arctic-trail/karhunkierros-sar-drone/docs/DESIGN_EVOLUTION_AND_STABILIZATION_LOG.md

# Master Design Evolution, Trade-Off Audit, and Architecture Stabilization Log

> **CONCEPT-STAGE STATUS DISCLAIMER (FIRST PUBLIC RELEASE):**
> This log documents the **open-source engineering concept, COTS hardware bill-of-materials (`€1,189–€1,329`), and software-simulated reference architecture** (`29/29` unit tests passing in `collector_hub/drone_observer.py`). While the shared ground trail-camera and collector stack ([`arctic-trail/arctic-trail-cam`](https://github.com/arctic-trail/arctic-trail-cam)) is bench-verified, **the physical SAR drone airframe, `-25 °C` winter flight endurance, payload drop, and `+10 °C` roofed station are currently at the concept and simulation stage** and require Phase 1–3 field flight validation and `Traficom` / `EASA SORA` regulatory authorization.

**Document Status:** Authoritative Master Engineering Log (`v2.0-FinLab-And-SupplyChain-Hardened`)  
**Repository Scope:** `karhunkierros-sar-drone` (100% Shared Ground Camera & Collector Stack with [`arctic-trail/arctic-trail-cam`](https://github.com/arctic-trail/arctic-trail-cam) + Modular `drone_observer.py` SAR Extension)  
**Purpose:** Permanently records every design iteration (Iterations 1–20), independent audit remediations (`F01`–`F53`), open-source ecosystem trade-offs, rejected architectural alternatives (including why we reject custom PCBs and heavy cloud/4G dependencies), and the **Reference COTS Hardware Baseline** so future development never goes in circles.

---

## 1. Executive Verdict: Has the Design Stabilized?

**Yes — at Iteration 20 (`v2.1-FinLab-USpace-Surge-And-SupplyChain-Hardened`), every finding from Round-1, Round-2, and Round-3 independent Flight Physics, ArduPilot Firmware, Hardware Bench Integration, Cybersecurity, Full-Stack & OPSEC Reviews plus Human-in-the-Loop Manual Manoeuvring, Two-Way Rescuer-to-Hiker Voice Relay, the `FIN-LAB` (`FIN-LAB-01..05`) reference benchmarks, and Allied Supply-Chain Provenance (`F01`–`F53`) has been resolved, and the complete architecture is verified end-to-end across all 29 automated `unittest` test suites.**

```
[========================================] 100% Software, Human Pilot Override, 2-Way Voice, FIN-LAB-01..05 & Audit Remediation (All 29 Test Suites Passing)
[========================================] 100% Shared Ground Camera & Collector Hub Stack with arctic-trail-cam (Zero Duplicate Products)
[========================================] 100% Snap-In Reference COTS Hardware Baseline (Zero Custom PCBs, <= €5,000 Rule Verified Across All 4 Allied Tiers)
[========                                ]  20% Physical Airframe Assembly & Live Field Flight Tuning
```

---

## 2. Complete Chronological Iteration History (Iterations 1–20)
*Why we changed what we changed — and what we must never revert to:*

| Iteration | Initial Idea / State | Problem / Limitation Discovered | Engineered Solution Adopted | Status |
| :--- | :--- | :--- | :--- | :---: |
| **Iter 1: Single-Camera Standoff Observer** | Drone launches on trail-camera trigger and orbits at `105 m AGL / 135 m` radius (`171 m` slant range) outside shotgun range (`55 m`). | Could only observe from high altitude; could not communicate with or warm a hypothermic person. | Added `compute_close_approach_state()` (`8–10 m` altitude, directional speaker + high-contrast message sign). | ✅ Locked |
| **Iter 2: "Bearnese Mountain Dog" Companion & Barrel** | Added miniature oak barrel with brass faucet ("Koskenkorva" joke) lowered to `2 m` above the person's head. | **Two severe flaws:** (1) Hovering `2 m` over a person's head with a cable is a physical entanglement/rotor hazard; (2) Alcohol (*Koskenkorva*) causes peripheral vasodilation and accelerates fatal hypothermia! | **Never revert to overhead drops or alcohol in public SAR:** Hard-coded a **`15 m` minimum horizontal human standoff bubble**, clear-snow offset drop (`10–15 m` away), **`25 N` electromagnetic/servo breakaway release**, `50 m` climb before audio prompt, and replaced payload with **`+42 °C` warm berry glucose-electrolyte drink**, hand warmers, and thermal blanket (keeping the *Koskenkorva* preset strictly as an internal pitch easter egg). | ✅ Locked |
| **Iter 3: Multi-Object & Multi-Drone Swarm** | Single drone could only track 1 person from 1 camera. | Tourist groups or families often split up (`> 250–450 m` apart) when lost in the dark. | Built `MultiCameraMultiObjectTracker`, `MultiDroneSwarmCoordinator` (up to 6 drones), and `plan_multi_drone_grid_search()` (boustrophedon parallel search lanes). | ✅ Locked |
| **Iter 4: Onboard Target-Lock & Self-Guidance** | Drone relied on ground trail-camera updates to know where the hiker was walking. | Once a hiker walks `50 m` past a trail camera, the ground camera can no longer see them. | Built `OnboardTargetLockSelfGuider`: once the drone's own thermal (`LWIR`) + optical (`YOLOv8n`) gimbal camera spots the person, it locks on and self-guides autonomously through tree canopy gaps (`CanopyKalmanTracker`). | ✅ Locked |
| **Iter 5: Privacy-by-Design ("Digitaalinen Autiotupa")** | Continuous trail camera tracking felt like "stalking random hikers in the woods." | Public and Data Protection Ombudsman (*Tietosuojavaltuutettu*) would reject continuous surveillance of hikers. | Created `PassiveTrailSightingLedger` (**48-hour auto-purging local ring buffer**, zero facial recognition, `0.00 W` RF) + `verify_humanitarian_sar_trigger()` (**"Pull, Don't Push"**: unlocks ONLY on `112 Suomi`, `Garmin inReach`, physical Trail-Post SOS button, or official `Poliisi`/`Rajavartiolaitos`/`Pelastuslaitos` SAR order). Also replaced defensive *"rauhanomainen"* wording with confident *"Suunnittelu, josta tietosuojavaltuutettukin tykkää"*. | ✅ Locked |
| **Iter 6: Finnish Legal, Wildlife & Arctic Context** | Generic coordinates and generic battery model. | Failed to account for *Poronhoitolaki* (`848/1990 § 42`), `-25 °C` *Kaamos* battery sag, or Finnish helicopter SAR coordinate formats. | Added `classify_finnish_boreal_thermal_signature()` (distinguishes humans from *poro* & *hirvi*; enforces `>= 100 m` silent ceiling over reindeer), `-25 °C` endurance model (`45%` dynamic handover reserve), and dual `ETRS-TM35FIN` + `WGS84 DDM` (`DD° MM.MMM'`) aviation SAR coordinates. | ✅ Locked |
| **Iter 7: Roadless Wilderness *Autiotupa* Survival Bridge** | Assumed the drone just orbits waiting for a police car. | In Karhunkierros / Lapland (`8–25 km` from the nearest plowed road), **a police car cannot reach the forest**, and snowmobile patrols take `90–180 min` — whereas hypothermia starts in `30–45 min`! Meanwhile, state `Metsähallitus` wilderness huts (*autiotuvat* with wood stoves) are only `0.5–2.5 km` away. | Built `compute_aerial_lantern_trail_guide_state()` (*Opaslyhty: "Seuraa minua autiotuvalle"*) + `evaluate_roadless_wilderness_autiotupa_rescue_bridge()`: guides hikers at walking pace with an `800 lm` spotlight to a warm *Autiotupa* in **`10–25 min`** (`> 110 min` faster than ground patrols). | ✅ Locked |
| **Iter 8: 100% Repository Separation** | Developed alongside the `arctic-trail-cam` ground sensor stack. | Keeping aerial SAR flight logic inside the ground trail-camera repository coupled release cycles across two distinct hardware builds. | Extracted into a **100% standalone Git repository** (`karhunkierros-sar-drone`) with clean modular versioning while sharing the common ground-camera and collector protocol. | ✅ Locked |
| **Iter 9: GNSS Jamming/Spoofing, RF Blackout & Icing Resilience** | Relied on standard GPS (`u-blox M10`), continuous RF telemetry, and `10 m AGL` below-canopy flight. | Eastern/Northern Finland experiences frequent **GPS jamming/spoofing** and RF interference; `10 m AGL` risks hitting spruce branches in wind; `-2 °C` freezing drizzle ices propellers. | Added `evaluate_gnss_rf_jamming_and_weather_resilience()`: (1) `PMW3901` Optical Flow + `Benewake TF02-Pro` (`40 m` IP65 LiDAR) cross-check fences off spoofed GPS (`no flyaway`) + `940 nm` trail-post fiducials; (2) `940 nm` One-Way Optical Diode pad handoff + 100% radio-silent autonomous rescue; (3) hydrophobic blade coating + centrifugal RPM ice-shedding burst; (4) `28 m AGL` above-canopy *Opaslyhty* mode with `10°` collimated spotlight. | ✅ Locked |
| **Iter 10: Immobilized Hiker 18h Beacon & Zero-Infrastructure Mobile Tailgate Mode** | Assumed (1) a pre-built fixed national-park drone pad, and (2) that every hiker can walk to the *Autiotupa*. | (1) Field testing and `Vapepa` volunteers need a portable car-trunk / snowmobile-*ahkio* launch mode with zero fixed park infrastructure; (2) an injured hiker with a broken ankle cannot walk to the *Autiotupa*. | Upgraded `compute_aerial_lantern_trail_guide_state()`: (1) supports `custom_shelter_target` for **Mobile Tailgate / Snowmobile *Ahkio* Launch & Return**; (2) if `stationary_duration_s >= 180 s`, escalates to `IMMOBILIZED_SHELTER_IN_PLACE_SKY_LIGHTHOUSE_HOLD` (`45 m AGL`) and, at `<= 25%` battery, lands on the `15 m` clearing in **`GROUNDED_CLEARING_18HR_LOW_POWER_STROBE_BEACON` (`18+ hours` strobe + beacon)** so an injured hiker is never abandoned. | ✅ Locked |
| **Iter 11 (`v1.1-Audit-Hardened`): Independent Audit Remediation (`F01`–`F22`) & Snap-In COTS Baseline** | Audit identified 22 findings across coordinates (`F01`), fail-closed verification (`F02`), `public_release_sar_cask` `50 m`/`15 m` overrides (`F03`), 65-byte MAVLink v2 frame packing (`F04`), `TF02-Pro` vs `TFmini-S` range (`F05`), `4S` vs `6S` X500 V2 voltage (`F06`), `OPERATIONAL` camera survey (`F07`), grid-search exhaustion (`F08`), relief battery check (`F09`), iterative airspace repulsion (`F10`), `SPD=0` preservation (`F11`), XSS/JSONL/UDP hardening (`F13`–`F18`), and shared `arctic-trail-cam` files (`F15`, `F19`–`F21`). | Maintaining two separate camera codebases or designing custom PCBs would slow down field testing and create hardware/software divergence bugs. | Implemented all audit fixes (`F01`–`F22`), standardized on **`8,000 mAh 4S2P (14.8 V, 118.4 Wh) Ultra-Low-Temp Silicon-Anode Li-Ion`** + **`Benewake TF02-Pro (40 m IP65)`** + **`MicoAir MTF-02P / Matek 3901-L0X`**, and scrubbed 100% of binary EXIF/XMP/C2PA/PDF metadata (`tests/test_enhanced_resilience.py`). | ✅ Locked |
| **Iter 12: Open-Source Field Drone Ecosystem Evaluation (`ArduPilot`, `ELRS`, `QuadroFleet`, `Delta`, `Eusocial Drones`)** | Evaluated whether to adopt external open-source frameworks (`ArduPilot`, `Betaflight`, `ExpressLRS`, `OpenIPC`, `QuadroFleet-Masina`, `Delta`, `Eusocial Drones`) vs. keeping our system lean and keeping the Reference COTS Hardware Baseline unchanged. | Adopting heavy 4G/VPN daemons (`QuadroFleet-Masina`) as a hard requirement fails in 0-bar Oulanka canyons; `Betaflight` lacks autonomous loiter/EKF3 optical-flow navigation; heavyweight cloud platforms (`Delta`) add unnecessary attack surface. However, missing native `ArduCopter EKF3` source-set switching or open-standard `CoT` packets would leave low-hanging fruit on the table. | **Adopted 4 zero-bloat, zero-hardware-change wins (`F26`):** (1) `generate_arducopter_pixhawk6c_param_profile()` configures `ArduCopter 4.5+` native `EKF3` dual source sets (`EK3_SRC1` = M10 GNSS, `EK3_SRC2` = Optical Flow + `TF02-Pro` LiDAR, switched instantaneously via `RC9_OPTION = 90` on GPS spoofing); (2) `ExpressLRS` (`ELRS`) 2.4 GHz FHSS on `RadioMaster Pocket` + `RP3 V2 Diversity` for jam-resistant override + `ELRS Airport` backup telemetry; (3) `export_open_sar_situational_awareness_packet()` exports `Delta`-style open-standard `ETRS-TM35FIN` JSON + `Cursor-on-Target (CoT)` XML + 4-tier telemetry failover (`940nm Diode` -> `868/900MHz LoRa` -> `ELRS` -> `Opportunistic 105m AGL LTE`); (4) `Eusocial Drones` "inverted iceberg" OPSEC boundary (`MIT` + safety/liability disclaimer, zero PII/metadata). | ✅ Locked |
| **Iter 13 (`v1.3-Marketplace-Hardened`): "Uber-for-SAR" Open-Alert Dispatch Marketplace, Automated Roofed Shelters, Multi-Unit Auto-Prioritization, Human Control Panel & 28 m Elastic Pull-Guidance (`F23`–`F26`)** | Previously, dispatch assumed a single pre-selected launch pad or manual CLI invocation. In real regional SAR, multiple mobile units (`Poliisi` drone vans, `Rajavartiolaitos` patrols, `Vapepa` units) and automated roofed wilderness stations (`+10 °C` weatherproof roofed nests) coexist and need a coordinated way to see, accept, and prioritize open alerts — with full human oversight. | Needed: (1) an "Uber-driver-style" open-alert acceptance flow for mobile vans + `AUTO_ACCEPT_GEOFENCE` mode for roofed stations; (2) safety interlocks so a roofed station with a jammed hatch, `> 25 kg` snow load, or failed heater never auto-launches (`F23`); (3) automatic `#2 Backup` promotion if `#1 Primary` aborts (`F24`); (4) closed-loop `28 m AGL` "Follow & Elastic Pull" escort verification (`F25`); and (5) a live Human Coordinator Control Panel. | Built `SARDispatchMarketplaceCoordinator`, `compute_elastic_pull_guidance_vector()`, `simulate_elastic_pull_escort_to_autiotupa()`, `/api/drone?action=dispatch-marketplace`, CLI `--mode dispatch-marketplace`, and the interactive **Uber-for-SAR Open-Alert Dispatch & Roofed Nests Control Panel** in `collector_hub/ui/index.html`, verified by `test_21` and `test_22`. | ✅ Locked |
| **Iter 14 (`v1.4-System-Assessment-Hardened`): End-to-End Physics, Safety-Geofence & Fail-Closed Marketplace Hardening (`F27`–`F31`)** | Deep assessment of the newly added `compute_elastic_pull_guidance_vector()` and `SARDispatchMarketplaceCoordinator` against Safeguards 1–6 (`15 m` human standoff, immobilized hiker 18h beacon, *Poronhoitolaki* `100 m` wildlife ceiling, "Pull, Don't Push" privacy gate, and physical roofed-hatch hardware protection). | Found 5 subtle cross-feature gaps: (`F27`) `compute_elastic_pull_guidance_vector()` achieved `6 m` / `10 m` spotlight lead by moving the `2.1 kg` airframe itself within `6 m` / `10 m` horizontally of the hiker (and `0 m` on arrival), violating `MIN_HUMAN_HORIZONTAL_STANDOFF_M = 15.0 m`; (`F28`) elastic pull lacked the immobilized hiker (`stationary_duration_s >= 180 s` -> `45 m` Sky-Lighthouse / `18h` grounded beacon) and *Poronhoitolaki* `100 m` reindeer hold; (`F29`) `broadcast_open_alert()` did not call `verify_humanitarian_sar_trigger()`; (`F30`) `human_coordinator_intervene("FORCE_ASSIGN_UNIT")` could attempt to launch a roofed nest into a jammed/snow-buried hatch; (`F31`) UI panel lacked one-click buttons for `Approve Launch`, `Abort #1 & Promote #2`, and `Toggle Nest #1 Auto`. | Resolved all 5 gaps (`F27`–`F31`): (`F27`) airframe always maintains `airframe_horiz_separation_m >= 15.0 m` via `enforce_hardcoded_human_safety_geofence()`, using `spotlight_gimbal_pitch_deg` to place the illuminated snow pool `6 m` / `10 m` / `15 m` ahead; (`F28`) unified immobilized hiker & *Poronhoitolaki* `100 m` escalation into `compute_elastic_pull_guidance_vector()`; (`F29`) fail-closed `verify_humanitarian_sar_trigger()` gate in `broadcast_open_alert()`; (`F30`) physical roofed-shelter interlock enforced even on manual coordinator override (`BLOCKED_UNSAFE_SHELTER_LAUNCH`); (`F31`) added all coordinator buttons in `collector_hub/ui/index.html`. | ✅ Locked |
| **Iter 15 (`v1.5-Audit-Hardened`): Round-1 Engineering Audit across Flight Physics, ArduPilot Firmware, Cybersecurity & OPSEC (`F32`–`F38`)** | Conducted two independent adversarial engineering reviews (Flight Physics & ArduPilot Firmware Review + Cybersecurity, Full-Stack & OPSEC Review) across the entire codebase, hardware parameter profile, and documentation. | Identified 7 high-value refinements (`F32`–`F38`): (`F32`) `evaluate_finnish_winter_flight_endurance()` previously used `133.2 Wh` (`9,000 mAh`) instead of `118.4 Wh` (`8,000 mAh 4S2P`) and passed `ambient_temp_c = +10 °C` when pre-warmed in a roofed nest, inadvertently disabling the `6 W` `+42 °C` cask heater and lowering the winter return reserve from `40–45%` to `30%`; (`F33`) `auto_prioritize_and_award_task()` had a dangerous fallback (`if not feasible_bids: feasible_bids = list(accepted_bids)`) that would launch a jammed/unfeasible unit if only unfeasible bids were present, and `human_coordinator_intervene()` checked cached bid dicts rather than live `self.fleet_units` state on post-acceptance hatch faults or backup failover; (`F34`) `generate_arducopter_pixhawk6c_param_profile()` needed `PM02 V3` calibration (`BATT_MONITOR=4`), `SERIAL5_PROTOCOL=2` / `FLOW_TYPE=5` (`MicoAir MTF-02P`), `SERIAL6_PROTOCOL=23` (`ELRS CRSF`), and `SERVO9_FUNCTION=28` (`GRIP_ENABLE=1` servo airdrop); (`F35`) during *Autiotupa* arrival (`dist <= 20 m`), pushing the drone `15 m` along `(ux_goal, uy_goal)` overshot directly over the cabin roof/chimney, and lateral pull (`6 m` beam vs `15 m` airframe) needed `spotlight_gimbal_yaw_rel_deg = 180.0` (aft); (`F36`) `export_open_sar_situational_awareness_packet()` needed `xml.sax.saxutils.escape` on `cot_xml` and unified `OULANKA_REF_LAT_DEG` (`66.2605° N`) CRS projection with `local_enu_to_etrs_tm35fin()`; (`F37`) `simulate_sar_dispatch_marketplace_lifecycle()` needed to re-run `simulate_multi_accept` after `hold_or_abort_launch`, merge default unit keys on JSON load, and allow exiting Marketplace to Standoff; (`F38`) scrubbed US-specific procurement strings (`Upgrade Energy`, `915MHz`, `"Ordered ..."`) from tracked files and fixed duplicate `test_17` method naming (`26` unittest suites). | Implemented all 7 Round-1 engineering audit remediations (`F32`–`F38`) and verified with `test_23_multi_model_audit_physics_security_and_opsec_regressions` (`26/26` `unittest` test suites passing). | ✅ Locked |
| **Iter 16 (`v1.6-Round2-Audit-Hardened`): Round-2 Adversarial Audit across Aerospace Kinematics, MAVLink Bitmasks, Hardware Bench Bring-Up & Atomic Persistence (`F39`–`F44`)** | Conducted a second independent adversarial engineering review probing arrival gimbal geometry, MAVLink v2 bitmasks, sub-zero fleet handover reserves, Wave 1/2/3 bench diagnostics, atomic JSON persistence, and binary PDF consistency. | Discovered 6 concrete engineering refinements (`F39`–`F44`): (`F39`) in `compute_elastic_pull_guidance_vector()`, `ARRIVED_AT_AUTIOTUPA_SAFE_HAVEN` had `effective_lead_m = 0.0`, which triggered `beam_offset_from_drone_m > 0` and set `spotlight_gimbal_yaw_rel_deg = 180.0°` (pointing the spotlight aft into the forest instead of at the cabin door!), and `compute_aerial_lantern_trail_guide_state()` (*Opaslyhty*) lacked the lateral `15 m` clearing offset on arrival (`dist_to_hut_m <= 20 m`), overflying the cabin roof when `dist_to_hut_m == 15 m`; (`F40`) `build_mavlink_guidance_frame()` used `type_mask = 0x0DF8`, which set `VX_IGNORE (8)`, `VY_IGNORE (16)`, `VZ_IGNORE (32)`, and `YAW_IGNORE (1024)` to `1` (ignored by ArduPilot!); (`F41`) `FleetCoordinator` hardcoded `30%` RTH reserve instead of scaling to `40%`/`45%` in sub-zero weather, `evaluate_unit_bid_metrics()` used `15%` post-return margin at `-22 °C`, `human_coordinator_intervene()` set `ROOF_CLOSED_WEATHER_SEALED` immediately while an aborted roofed drone was still airborne returning to dock, and `SubjectKalmanTracker.step()` lacked a velocity spike clamp; (`F42`) needed a dedicated Wave 1/2/3 SAR Drone hardware bench diagnostic and `.param` exporter (`run_sar_drone_companion_bench_check()`, `--mode bench-check --export-params`, and `run_guided_bench_doctor.py --drone-bench`); (`F43`) needed atomic JSON file writes (`_atomic_write_json` via temp + `fsync` + `os.replace`), mode persistence across `grid-search` and `sar-tourist-group`, 3D UI altitude sync (`28 m` / `50 m` / `8 m`), `403` directory-listing block, and `300 s` freshness filtering in `subghz_nlos_relay.py`; (`F44`) `docs/KARHUNKIERROS_PRO_BONO_SAR_BRIEF_FI.pdf` needed regeneration + metadata scrubbing so its binary text matches the `8,000 mAh 4S2P (118.4 Wh)` and `v1.6` documentation. | Implemented all 6 Round-2 engineering audit fixes (`F39`–`F44`), regenerated and metadata-scrubbed `docs/KARHUNKIERROS_PRO_BONO_SAR_BRIEF_FI.pdf`, and verified with `test_24_round2_multi_model_aerospace_and_bench_audit_regressions` (`27/27` `unittest` test suites passing). | ✅ Locked |
| **Iter 17 (`v1.7-Human-Pilot-And-Two-Way-Voice-Hardened`): Post-Detection Human Pilot Manual Manoeuvring & Two-Way Rescuer-to-Hiker Voice Intercom Relay (`F45`–`F47`)** | Automation is ideal for transit and parallel grid search, but once the lost person is found in the dark boreal forest, **we cannot trust pure automation to handle close-in obstacle nuances alone, nor will a frightened hiker blindly follow a silent, robotic drone** (they are more likely to fear or run away from it unless a real human rescuer speaks to them and listens to their reply). | Needed: (`F45`) Post-detection `HOLD_FOR_HUMAN_PILOT_AND_VOICE_CONTACT` (`35 m AGL`, `25 m` horizontal standoff) + pre-configured `ArduCopter 4.5+` manual stick override modes (`FLTMODE1 = 5 LOITER`, `FLTMODE4 = 4 GUIDED`, `FLTMODE6 = 6 RTL`) for `RadioMaster Pocket ELRS`; (`F46`) `HumanPilotAndTwoWayVoiceRelayController` allowing remote 6-DOF operator nudges (`N/S/E/W`, `Alt`, `Yaw`, `Gimbal`, `Deadman Hover Brake`, `Manual Cask Release`) via 65-byte `MAVLink v2 SET_POSITION_TARGET_LOCAL_NED` frames while **still enforcing `enforce_hardcoded_human_safety_geofence()`** (`>= 15.0 m` horizontal standoff, `>= 6.0 m` LiDAR floor); (`F47`) **Live Two-Way Voice Intercom Relay (`Rescuer <-> Hiker`)** solving the `82 dBA` propeller noise physics problem via 3 selectable uplink modes: (1) `AIRBORNE_PROP_NOTCHED_MIC_AND_VISUAL_GESTURE`, (2) `GROUNDED_15M_CLEARING_QUIET_SPEAKERPHONE`, and (3) `CASK_DROPPED_COLLAR_PTT_MIC`. | Built `HumanPilotAndTwoWayVoiceRelayController`, `execute_human_pilot_and_voice_relay_action()`, CLI `--mode human-pilot`, `/api/drone?action=human-pilot`, the interactive **Human Pilot & 2-Way Voice Intercom** panel in `collector_hub/ui/index.html`, and `test_25` (`28/28` `unittest` test suites passing). | ✅ Locked |
| **Iter 18–20 (`v2.1-FinLab-USpace-Surge-And-SupplyChain-Hardened`): 3-Pass Implementation & Red-Team Hardening of `FIN-LAB-01 / 02 / 03 / 04 / 05` & Allied Supply-Chain Provenance (`F48`–`F53`)** | Evaluated our SAR Drone and Arctic Trail Cam against the `FIN-LAB` Nordic harsh-environment & autonomous systems working group charters (`FIN-LAB-01` through `FIN-LAB-05`) and supply-chain resilience benchmarks (`NdFeB` sintered magnets, `-40 °C` battery cells, uncooled `LWIR` thermal cores, and the `<= €5,000` BOM rule) across 3 full adversarial engineering iterations. | Identified and closed 5 high-leverage capabilities + 6 adversarial red-team physics/geometry refinements (`F48`–`F53`): (1) **`FIN-LAB-03` High-Altitude (`> 40 m` to `120 m AGL`) GNSS-Denied Navigation (`F51`)** solving the `40 m` `Benewake TF02-Pro` LiDAR range ceiling during `105 m AGL` transit via Cold-Air Hypsometric Baro-DEM Scaling ($\Delta h_{\text{true}} = \Delta h_{\text{ISA}} \cdot (\bar{T}_K / 288.15)$, preventing the `4,347 m` `-25 °C` barometric drift trap) + Dual-Band `IMX462 Starvis` / `TOPDON TC001 LWIR` Homography Odometry + NUC shutter freeze watchdog + compound-blinding emergency descent to the `<= 40 m` LiDAR floor + surveyed *Autiotupa*/River/`940 nm` Trail-Post EKF resets (`20.76 m <= 30.0 m` 30-min drift pass mark); (2) **`FIN-LAB-05` `10 Hz` Cold-Weather & Flight Black-Box Telemetry Logger (`F52`)** (`IEC 60068-2-1` Cold & `RTCA DO-160G Section 24` Icing) with dynamic $\bar{R}_{\text{internal}}$ EMA, predictive `35 A` climb voltage-sag guard (`< 12.2 V` clamps climb rate to `1.5 m/s`), $\Omega^2$-scaled aerodynamic icing torque anomaly (`> 12%` triggers `8,500 RPM` centrifugal shedding without false-positive alarms on clean high-RPM climbs), and automatic `CLASS_A_MINUS_30C_QUALIFIED` grading; (3) **`FIN-LAB-01` Open Ingest API (`v0.9`) Civilian Twin Adapters, C2 Ingest Bridge & O1–O5 Scorecard (`F49`, `F50`, `F53`)** (`AutiotupaCabinOccupancyAndOverdueAdapter` with solar chimney false-alarm guard, `AcousticDistressAndMotorBearingAdapter` with Cramer's Rule `t1, t2 > 0` & `sin_opening >= sin(15°)` GDOP gate + wind howling suppression, `ReindeerPaliskuntaCollarTelemetryAdapter`, `TrailCameraMmWaveOpticalDiodeAdapter`, `ingest_finlab01_observation_into_sar_c2()`, and duration-weighted `compute_finlab01_conformance_scorecard()`); (4) **`FIN-LAB-04` Seeded Monte Carlo SAR Fleet & Battery Sizing Digital Twin (`F48`)** (`1,000` runs in `~7 ms` enforcing the `18.0 km` winter SAR operating radius and roadless Oulanka canyon ski approach so `CONFIG_MINIMAL_2_NESTS_1_PACK` fails at `59.6%` Golden-Hour while **`CONFIG_BALANCED_4_NESTS_3_PACKS`** (`€185k`, `100%` Golden-Hour, `P95 = 15.5 min`) is selected as Pareto-optimal); (5) **FIN-LAB Allied Component Provenance, Pin-to-Pin `JST-GH` Harness Schedule (`TELEM2` Pin 1 `+5V` isolated) & 5-Stage `2.5h` Rapid Build Checklist (`F53`)** (`€1,329` COTS incl. `+€45` `[D19]`/`[D20]` high-field EMI ferrite & UHF/DECT mic kit / `€1,770` Allied Tier-1 / `€2,126.40` `+60%` Allied Contingency / `€2,965` Sovereign European `Lynred ATTO320 / Senop` LWIR — all well under `<= €5,000`). | Built `compute_finlab03_gnss_denied_high_altitude_navigation()`, `ColdWeatherBlackBoxLogger`, `AutiotupaCabinOccupancyAndOverdueAdapter`, `AcousticDistressAndMotorBearingAdapter`, `ReindeerPaliskuntaCollarTelemetryAdapter`, `TrailCameraMmWaveOpticalDiodeAdapter`, `ingest_finlab01_observation_into_sar_c2()`, `compute_finlab01_conformance_scorecard()`, `simulate_sar_fleet_monte_carlo_sizing()`, `audit_supply_chain_and_cots_buildability()`, `run_complete_finlab_and_supply_chain_verification_suite()`, CLI `--mode finlab-suite`, `/api/drone?action=finlab-suite`, the **FIN-LAB & Supply-Chain Suite** UI inspector panel, and `test_26` (`29/29` `unittest` test suites passing). | ✅ **v2.0 FinLab-And-SupplyChain-Hardened** |

---

## 3. Learnings from the Open-Source Field Drone Ecosystem (Zero Hardware Changes)

| Project / Layer | What It Is | Our Architectural Decision (No Overkill, Zero Hardware Change) |
| :--- | :--- | :--- |
| **`ArduPilot` (`ArduCopter 4.5+`, GPL-3.0)** | Full autonomous flight stack for `Pixhawk 6C` (`STM32H7`). | **ADOPTED (`generate_arducopter_pixhawk6c_param_profile()`):** Runs natively on `Holybro Pixhawk 6C` + `PM02 V3`. We use its built-in **`EKF3` Dual Source-Set Switching** (`EK3_SRC1_*` = M10 GNSS; `EK3_SRC2_*` = `MicoAir MTF-02P / Matek 3901-L0X` Optical Flow + `Benewake TF02-Pro` LiDAR via `RC9_OPTION = 90`) and native `SERVO9_FUNCTION = 28` (`GRIP_ENABLE = 1`) servo airdrop so our Pi 5 can switch out of spoofed GPS in `< 50 ms` without custom flight-control C++ code. |
| **`Betaflight` (GPL-3.0)** | Acrobatic FPV flight controller firmware. | **REJECTED:** Designed for manual FPV racing/freestyle; lacks autonomous loiter, waypoint navigation, belly servo payload release, and `EKF3` optical-flow/LiDAR position hold. |
| **`ExpressLRS` (`ELRS`)** | Open-source FHSS RC link (`2.4 GHz`). | **ADOPTED:** Supported natively via **`RadioMaster Pocket ELRS` + `RP3 V2 Diversity Receiver` (`SERIAL6_PROTOCOL = 23`)**. Provides frequency-hopping safety-pilot override and can carry low-rate MAVLink telemetry (`ELRS Airport`) as Link Tier 3. |
| **`QuadroFleet-Masina` (4G/5G VPN)** | Open-source 4G/5G LTE video/telemetry + VPN tunnel. | **SKIP FULL STACK / ADOPT CONCEPT AS TIER-4 BURST:** Deep Karhunkierros canyons have `0 bars` of cellular reception, and running WebRTC/VPN daemons on the critical flight path adds unnecessary failure modes. Instead, our **Link Tier 4** uses a zero-dependency opportunistic high-altitude (`105 m AGL` above canopy) compressed keyframe burst only when hilltop LTE is detected, while **Link Tier 1 (`940 nm` Optical Diode)** and **Link Tier 2 (`868/900 MHz LoRa`)** remain primary. |
| **`Delta` (Open Architecture vs. Open Source)** | Multi-agency situational awareness architecture built on open data standards (`CoT`). | **ADOPTED OPEN-STANDARD PACKET (`export_open_sar_situational_awareness_packet()`):** Instead of building a heavyweight cloud, every alert and drone state exports a lightweight, XML-escaped, zero-dependency **`ETRS-TM35FIN` JSON + `Cursor-on-Target (CoT)` XML** packet (`< 1 m` CRS agreement) so `Poliisi`, `Rajavartiolaitos`, `Vapepa`, or `QGroundControl / ATAK` tablets can view and accept alerts immediately. |
| **`Eusocial Drones` ("Inverted Iceberg" Model)** | Open-source community portal that keeps sensitive operational tooling private. | **ADOPTED:** Validates our exact repository architecture: public-ready humanitarian SAR codebase (`MIT` + safety/liability disclaimer, zero PII/metadata, zero vendor-order correlation) with strict operational security hygiene. |

---

## 4. "Uber-for-SAR" Open-Alert Marketplace, Roofed Auto-Stations & 28 m Elastic Pull-Guidance (`F23`–`F38`)

1. **Open-Alert Broadcast to Mobile Units & Roofed Auto-Stations (`broadcast_open_alert()`, `F29`):**
   - Enforces `verify_humanitarian_sar_trigger()` ("Pull, Don't Push" privacy gate, `F29`): fails closed (`REJECTED_NO_HUMANITARIAN_SAR_TRIGGER`) unless triggered by an authorized `112 Suomi`, `Garmin inReach`, Trail-Post SOS button, overdue *autiotupa* check-in, or official `Poliisi` / `Rajavartiolaitos` / `Pelastuslaitos` SAR order.
   - When authorized, broadcasts an open task (`OPEN_FOR_UNIT_ACCEPTANCE`) to all registered **Mobile Patrol Units** (`POLIISI-VAN-OULU-21`, `RAJA-PARTIO-KUUSAMO-04`, `VAPEPA-AHKIO-RUKA-07`) and **Automated Roofed Wilderness Stations** (`NEST-OULANKA-ROOF-01`, `NEST-VALTAVAARA-ROOF-02`).
2. **Weatherproof Roofed Stations (`+10 °C`) with Auto-Accept & Live Hardware Safety Interlocks (`F23`, `F30`, `F33`):**
   - Automated stations sit under a motorized weatherproof roof (`+10 °C` heated enclosure keeping snow, freezing rain, and rime ice off the airframe and keeping the `8,000 mAh` Li-Ion pack at `100%` warm capacity, while `evaluate_finnish_winter_flight_endurance()` decouples `cell_temp_c` from `ambient_temp_c` so the `+42 °C` cask heater and `40–45%` winter return reserve remain active in `-22 °C` air, `F32`).
   - When set to `AUTO_ACCEPT_GEOFENCE`, the station automatically accepts tasks within its `14 km` geofence **only if** its `F23` safety interlock passes (`roof_hatch_operational == True`, `roof_snow_load_kg <= 25.0 kg`, `internal_temp_c >= -15.0 °C`, and `auto_accept_mode != "MAINTENANCE_OFFLINE"`).
   - Live bid refresh (`_refresh_active_task_bids()`, `F33`) re-evaluates `self.fleet_units` before every prioritization, manual assignment, or backup promotion. If all accepting units are unfeasible or have jammed hatches, `auto_prioritize_and_award_task()` fails closed (`BLOCKED_NO_FEASIBLE_OR_SAFE_UNITS`) and never launches an unsafe unit.
3. **Multi-Unit Auto-Prioritization & Automatic `#2 Backup` Failover (`F24`, `F33`):**
   - When multiple units accept the same alert, `auto_prioritize_and_award_task()` scores every feasible bid (`0–100 pts`): **Flight ETA (`45%`)**, **Winter Battery Endurance Margin (`25%`)**, **Thermal/Cask/GNSS-Denied Capability (`15%`)**, and **Shelter/Optical-Diode Readiness (`15%`)**.
   - Ranks `#1` as `PRIMARY_SAR_RESCUER` and `#2` as `SECONDARY_BACKUP_INTERCEPT`. If `#1` aborts (`ABORT_PRIMARY_PROMOTE_BACKUP`), `#2` is verified against live `shelter_safety_interlock_ok and mission_feasible` before promotion (`F33`).
4. **Human Coordinator Control Panel & Governance Modes (`F31`, `F37`):**
   - Supports three governance modes: `AUTO_DISPATCH_WITH_HUMAN_VETO` (default), `MANUAL_COORDINATOR_APPROVAL_ONLY`, and `FULL_AUTONOMOUS_ZERO_TOUCH`.
   - At any moment in the 3D UI (`collector_hub/ui/index.html`) or API, the human coordinator can click **Force Assign Unit**, **Approve Manual Launch**, **Abort Primary & Promote #2 Backup**, **Nest #1 Auto: ON/OFF**, **Hold / Pause Launch**, **Force Immediate RTB**, or **Standoff Orbit**.
5. **Closed-Loop `28 m AGL` "Follow & Elastic Pull" Guidance with Hard-Coded `15 m` Standoff, Aft Gimbal Yaw & Lateral *Autiotupa* Clearing Arrival (`F25`, `F27`, `F28`, `F35`):**
   - After dropping the `+42 °C` berry-electrolyte cask and thermal blanket at a `15 m` horizontal offset, the drone climbs to **`28.0 m AGL`** (safely above `15–22 m` spruce crowns) and engages `compute_elastic_pull_guidance_vector()`:
     - **Hard-Coded `>= 15.0 m` Horizontal Airframe Standoff & Aft Gimbal Orientation (`F27`, `F35`):** The `2.1 kg` airframe never moves closer than `15.0 m` horizontally to the hiker (`enforce_hardcoded_human_safety_geofence()`). When closer spotlight guidance (`6.0 m` or `10.0 m` ahead of the hiker) is needed while the airframe is `15.0 m` ahead, the gimbal rotates aft (`spotlight_gimbal_yaw_rel_deg = 180.0`) and pitches (`spotlight_gimbal_pitch_deg`) toward the hiker so the illuminated snow pool lands `6.0 m` or `10.0 m` in front of their boots.
     - **`ARRIVED_AT_AUTIOTUPA_SAFE_HAVEN` Lateral Clearing Offset (`F35`):** Once within `20.0 m` of the *autiotupa*, the drone offsets `15.0 m` laterally perpendicular to the trail (`-uy_goal, ux_goal`) in the cabin's front clearing (`drone_distance_to_autiotupa_m >= 15.0 m`), illuminating the cabin door from the side without ever overflying the cabin roof or hot chimney before executing autonomous Return-to-Base (`RTB`).

---

## 5. Reference COTS Hardware Baseline (Snap-In Architecture, Zero Custom PCBs)

| Subsystem | Reference COTS Components | Architectural Role |
| :--- | :--- | :--- |
| **Airframe & Propulsion** | `HolyBro X500 V2 500mm ARF` (pre-soldered 2216 KV920 motors, 20A BLHeli_S ESCs, PDB, 1045 props) | `500 mm` carbon-fiber quadcopter rated for `14.8 V 4S` propulsion and `2.1 kg` all-up SAR weight. |
| **Flight Controller & GNSS** | `HolyBro Pixhawk 6C (STM32H7)` + `PM02 V3` Power Module + `Micro M10 GNSS` + `6-Pin JST-GH` Cable Harness Kit | Runs `ArduCopter 4.5+` with `PM02 V3` sensing (`BATT_MONITOR=4`) and dual `EKF3` sensor source sets (`EK3_SRC1` GNSS / `EK3_SRC2` Optical Flow + LiDAR). |
| **Arctic Li-Ion Power System & Charger** | `8,000 mAh 4S2P (14.8 V, 118.4 Wh) Ultra-Low-Temp Silicon-Anode Li-Ion` (`-40 °C` rated) + `ISDT 608AC Smart XT60 Balance Charger` | Provides `36–38 min` pre-warmed winter endurance (`28+ min` cold-soaked at `-25 °C`) with `40–45%` dynamic winter return reserve. |
| **Companion Computer, Sensors & Bench Link** | `Raspberry Pi 5 (8GB)` + `Active Cooler` + `64GB microSDXC + USB-C SD Reader` + `27W USB-C Bench PSU` + `Cat6 Gigabit Ethernet RJ45 Patch Cable` + `5V/5A UBEC` + `TOPDON TC001 LWIR (256x192 + USB-C/A Adapter)` + `Arducam IMX462 Starvis` + `Benewake TF02-Pro (40m IP65 LiDAR)` + `MicoAir MTF-02P / Matek 3901-L0X Optical Flow` | Runs `drone_observer.py` vision, thermal classification, GNSS-spoofing cross-check, and `MAVLink v2` (`TELEM2`) commands. |
| **Telemetry, Control (`+ 2× 18650 Cells`), 2-Way Voice, EMI Shielding & SAR Payload** | `MicoAir LR900-F 868/900MHz LoRa` + `RadioMaster Pocket ELRS` + **`2× 18650 Flat-Top 3.7V Li-Ion Cells`** + `RP3 V2 Diversity Receiver` + `Servo/Electromagnetic Airdrop Release (SERVO9)` + `1,500 lm (10°) Spotlight` + `USB 5W Speaker + SSS1629A5 UAC2 Mic [D07]` + `Out-of-Band UHF (520–580 MHz) / DECT (1.9 GHz) Wireless Collar PTT Mic [D19] (inside Rescue Cask)` + `6× Fair-Rite Mix 31/43 Snap-On Ferrites & Copper EMI Tape [D20]` | 4-tier telemetry failover, `< 50 m` high-field EMI bus reset immunity (`[D20]`), jam-resistant manual override (`FLTMODE1=LOITER`), live two-way `Rescuer <-> Hiker` voice intercom (`3` acoustic uplink modes incl. `2.4 GHz`-jam-immune UHF/DECT collar mic `[D19]`), `15 m` offset care-cask drop, and `28 m AGL` *Opaslyhty* trail pull. |
