arctic-trail/karhunkierros-sar-drone/docs/EAR_ITAR_EU_DUAL_USE_AND_AALTO_PUBLICATION_COMPLIANCE.md

# Lane C (`Opaslyhty` & `PELASTUS`): EAR / ITAR / EU Dual-Use (`(EU) 2021/821`) & OFAC Sanctions Compliance Dossier for Aalto University Sharing & Public GitHub Release

**Document ID:** `LANE-C-EXPORT-COMPLIANCE-2026-10-31`  
**Synchronised with:** [`README.md`](../README.md), [`PROJECT_AND_DESIGN_BRIEF.md`](../PROJECT_AND_DESIGN_BRIEF.md), [`CHINA_FREE_ALLIED_EU_BOM_AND_ASSEMBLY_MANUAL.md`](CHINA_FREE_ALLIED_EU_BOM_AND_ASSEMBLY_MANUAL.md), and [`AALTO_OPTION_E_PHASE2_PELASTUS_CHALLENGE_BRIEF.md`](../aalto_pelastus_benchmark_challenge/AALTO_OPTION_E_PHASE2_PELASTUS_CHALLENGE_BRIEF.md).

---

## 1. Executive Verdict: Is Anything ITAR-Controlled?

- **ITAR (`22 CFR Parts 120–130`, USML): `ZERO RISK (0% ITAR Content)`.**
  - Nothing in `Opaslyhty` or `PELASTUS` falls on the U.S. Munitions List (`USML Cat VIII` or `Cat XII`). Commercial uncooled microbolometers (`Teledyne FLIR Boson` / `Lynred Atto`), standard civilian `u-blox M10` GNSS, and unarmed civil SAR airframes are governed by civil/dual-use rules (**U.S. EAR `15 CFR Parts 730–774`** and **EU Dual-Use Regulation `(EU) 2021/821`**), not ITAR.

---

## 2. The 4 Specific EAR / EU Dual-Use Risk Areas & Mandatory Guardrails

| # | Risk Area & Legal Citation | Why It Could Trigger a Permit / Violation | Status in Our Current Repo & Mandatory Guardrail |
| :---: | :--- | :--- | :--- |
| **1** | **Thermal Camera Core Frame Rate (`> 9 Hz` vs. `≤ 9 Hz`) & OFAC Sanctions**<br>*(EAR `ECCN 6A003.b.4.b` & `15 CFR § 734.4(a)(1)` `0%` de minimis; EU `2021/821` Annex I `6A003.b.4.b`; OFAC E.O. `14024`)* | • **Original `Topdon TC001` (`InfiRay` `25 Hz`):** Core maker `Yantai iRay Technology Co., Ltd.` is on the **U.S. OFAC SDN List** (`1 May 2024`, E.O. `14024`) and **BIS Entity List** (`89 FR 35688`). University compliance blocks SDN hardware.<br>• **Any U.S.-origin `> 9 Hz` (`30/60 Hz`) FLIR Boson (`6A003.b.4.b`):** Controlled for **Regional Stability (`RS1`)** with a **0% de minimis rule** (`§ 734.4(a)(1)`). Putting a `30/60 Hz` U.S. Boson on the drone makes the *entire drone* EAR-controlled and triggers **"deemed re-export" (`§ 734.14`)** restrictions if non-EU/non-allied foreign students at Aalto access non-public `6E001/6E002` integration data.<br>• **French `Lynred Atto320 25 Hz` (`Option P15-B`):** Controlled under **EU `6A003.b.4.b`**. Intra-EU transfer (`FR -> FI` / Aalto) is license-free under `Art. 11`, **but** physical export outside the EU requires a Finnish Ministry for Foreign Affairs (`Ulkoministeriö`) permit, and non-public vendor SDKs/ICDs (`6E001`) cannot be put in a public repo. | **SAFE IF THIS GUARDRAIL IS FOLLOWED:**<br>1. **For Open Public Repo & University Sharing:** Use our committed primary **`Option P15-A` (`Teledyne FLIR Boson 320 ≤9 Hz [8.6 Hz]`, MPN `20320A006-9AAX`, `ECCN 6A993.a`)**. Because it is `≤ 9 Hz`, it is **exempt from `6A003.b.4.b`**, has **zero `0%` de minimis taint**, and requires **no permit** to share with Aalto or publish on GitHub.<br>2. **Never commit vendor NDA documents or proprietary binary SDKs (`6E001`/`6E002`)** to the public repo—only publish our standard Linux `V4L2` / `USB-UVC` open-source capture code (`EAR § 734.7` / EU General Software Note exempt). |
| **2** | **`PELASTUS` (`160 m/s` Fixed-Wing) Crossing the `30-Minute` Complete-UAV Threshold**<br>*(EAR & EU `2021/821` Annex I `9A012.a.1` & Technology `9E001`)* | Under both **U.S. ECCN `9A012.a.1`** and **EU Dual-Use `9A012.a.1`**, a non-military autonomous UAV becomes a **controlled Dual-Use item** if it has:<br>1. Maximum endurance **`>= 30 minutes`** (and `< 1 hour`), **AND**<br>2. Capability for stable controlled flight in wind gusts **`>= 46.3 km/h` (`25 knots` / `12.86 m/s`)**.<br>• **`Opaslyhty` (`2.41 kg` quad) is 100% exempt** on both prongs (`19–27 min < 30 min` AND firmware wind limit `10.0 m/s = 36.0 km/h < 46.3 km/h`).<br>• **However, `PELASTUS` (`160 m/s` = `576 km/h` fixed-wing)** inherently withstands `> 25 kt` gusts. If an Aalto student team builds `PELASTUS` with **`>= 30 minutes` of battery/fuel endurance**, the physical aircraft and its non-public development data (`9E001`) become **controlled Dual-Use items**! | **MANDATORY GUARDRAIL FOR AALTO BRIEF:**<br>1. **Hard-cap the `PELASTUS` student challenge battery capacity / endurance specification to `<= 20 minutes` (`< 30 minutes`).** (At `160 m/s`, a `15 km` rescue sprint takes only `94 seconds`, so a `15–20 min` battery pack easily completes the mission while keeping `PELASTUS` **100% outside `9A012.a.1`**.)<br>2. Keep all Aalto challenge deliverables **100% open-source / published ("Public Domain" & "Fundamental Research" under `15 CFR § 734.7 / § 734.8` and the EU General Technology Note)** so no `9E001` deemed-export or technical-assistance permit is ever triggered. |
| **3** | **Encryption Source Code on Public GitHub (`ECCN 5D002`)**<br>*(EAR `15 CFR § 742.15(b)` & `§ 740.17` ENC; Wassenaar Crypto Note)* | Because GitHub is hosted on U.S. servers, uploading software to a public GitHub repo is subject to the EAR. Publishing custom **confidentiality encryption (`> 56-bit` AES/ChaCha20)** source code (`ECCN 5D002`) in a public repo is legal without a license *only* if you send a one-time notification email with the repo URL to `crypt@bis.doc.gov` and `enc@nsa.gov` (`15 CFR § 742.15(b)`). | **SAFE AS BUILT:**<br>• Our `GW-1` alert protocol uses **cleartext CoT + `Ed25519` digital authentication signatures**. Under `ECCN 5A002` Note 4 / `5D002`, **authentication/signature-only code (`Ed25519`) is NOT controlled under `5D002`**.<br>• **Guardrail:** Keep `RF-1` as signed cleartext (`Ed25519`). If payload confidentiality encryption is ever added to the public repo, send the 1-paragraph `§ 742.15(b)` URL notice to BIS/NSA before pushing. |
| **4** | **GNSS Anti-Jam (`CRPA`) or High-Speed (`> 515 m/s`) Navigation**<br>*(ITAR `USML Cat XII(d)` / EU `ML11` / EAR `7A005`)* | Multi-element Controlled Reception Pattern Antennas (`CRPA` / null-steering anti-jam GNSS) and GNSS receivers unlocked above COCOM limits (`> 515 m/s` or `> 18 km` altitude) are strictly controlled military/dual-use items (`USML Cat XII(d)` / `ML11` / `7A005`). | **SAFE AS BUILT:**<br>• Both `Opaslyhty` and `PELASTUS` use standard commercial single-antenna `u-blox M10` GNSS with factory COCOM limits intact.<br>• **Guardrail:** Never add GNSS anti-jam (`CRPA`) beamformers or RF spoofing hardware to the Aalto challenge or repo. |

---

## 3. Bottom-Line Checklist Before Publishing or Handing Off to Aalto University

1. **Public GitHub Repo (`Opaslyhty` + `PELASTUS` Simulation / Code / CAD):**
   - **100% clear to publish today with zero permits required** (uses `Ed25519` authentication-only, open `V4L2`/`USB-UVC` interfaces, zero proprietary vendor SDKs, and `≤ 9 Hz` `Teledyne FLIR Boson 320` primary configuration).
2. **Sharing the `PELASTUS` Challenge Brief with Aalto University (`Option E` Phase 2):**
   - **100% clear with zero permits required**, because [`AALTO_OPTION_E_PHASE2_PELASTUS_CHALLENGE_BRIEF.md`](../aalto_pelastus_benchmark_challenge/AALTO_OPTION_E_PHASE2_PELASTUS_CHALLENGE_BRIEF.md) explicitly mandates **maximum battery endurance `<= 20 minutes` (`< 30 min`)** and **100% open academic publication (`EAR § 734.7 / § 734.8` & EU General Technology Note)** so student prototypes never cross into `9A012.a.1` or `9E001`.
3. **Physical Hardware Loan (`Opaslyhty` Quad) Inside Finland:**
   - **With `Option P15-A` (`Teledyne FLIR Boson 320 ≤9 Hz`, `ECCN 6A993.a`):** **Zero dual-use restrictions** — can be freely loaned to Aalto University or SLPS and operated by any student or volunteer (subject only to standard `EAR Part 746` / EU comprehensive embargo exclusions for Iran, DPRK, Syria, Cuba, Russia, and Belarus).
   - **With `Option P15-B` (`Lynred Atto320 25 Hz`, `EU 6A003.b.4.b`):** **No permit required inside Finland or the EU** (intra-EU transfer under `EU Reg. 2021/821 Art. 11`), but the physical `25 Hz` thermal camera module must not be exported outside the EU (e.g., to Norway or the UK) without a Finnish Ministry for Foreign Affairs (`Ulkoministeriö`) dual-use export license.
