arctic-trail/karhunkierros-sar-drone/docs/SAR_OPERATOR_UX_AND_GAP_ANALYSIS.md

# Complete SAR System Operator UX, Multi-Role Endpoint Architecture & Production Readiness vs. Missing Physical Gates Audit

**End-to-End Use Cases, User Experience Workflows Across All 6 Operational Personas & Endpoint Applications, and Explicit Engineering Readiness Breakdown: `100% Production Code / Crypto / CAD (0 Dummy Stubs)` vs. `Missing Bench/Freezer HIL Testing` vs. `Missing Build & Field Flight Testing` vs. `Missing Regulatory/Agency Certification` (`Karhunkierros SAR Swarm` + `Electric Fixed-Wing Relay Carrier` + `3-Zone Pi-Diode Trail-Cam / Sky-Diode Sensor Mesh`)**

---

## 1. Executive Summary & Complete 6-Persona Ecosystem

In a life-or-death wilderness Search and Rescue (SAR) operation under sub-arctic conditions (`-25°C` to `-30°C` *Kaamos* polar night, `12–18 m/s` canyon winds, roadless boreal terrain), no single screen or single operator exists in isolation. The complete system serves **six distinct user personas**, each interacting with a purpose-built **Endpoint Application or Physical UX Surface** connected across a resilient multi-tier communication fabric (`MAVLink v2 UDP :14550` TX+RX binary parser, `868 MHz LoRa TDMA Mesh`, `2.4 GHz NLOS Sky-Diode Troposcatter`, atomic disk-persisted `/api/ecosystem/state` + `BroadcastChannel`, and `Cursor-on-Target / 112 ERICA JSON`).

To ensure **zero ambiguity between production software/CAD deliverables and remaining physical hardware/regulatory milestones**, every persona and subsystem in this document (and live in the UI via the **`🛡️ SW: 100% PROD • MISSING GATES ▾`** modal backed by `GET /api/ecosystem/readiness`) explicitly separates:
1. **`[SW / CRYPTO / CAD: 100% PROD]`** — Production-grade software, binary protocol parsers, cryptography, spherical geodesy, and `.step`/`.stl` CAD verified by `44/44` automated tests (`0` experimental dummy stubs).
2. **`[MISSING: BENCH / FREEZER HIL TESTING]`** — Physical hardware-in-the-loop (HIL) bench wiring and `-25°C` to `-30°C` cold-soak chamber validation still required.
3. **`[MISSING: BUILD & FIELD FLIGHT TESTING]`** — Physical composite airframe layup, electric propulsion thrust-stand run, and outdoor flight/drop/field range trials still required.
4. **`[MISSING: REGULATORY / EXTERNAL AGENCY CERT]`** — External statutory permits, BVLOS approvals, and government C2 network handshakes still required before live operational deployment.

| # | User Persona / Role | Endpoint Application / UX Surface | `SW / Crypto / CAD Status` (`Today`) | `Missing Physical Gates` (`Bench HIL` • `Field Flight` • `Regulatory`) |
| :--- | :--- | :--- | :--- | :--- |
| **1** | **SAR Incident Commander & Swarm Mission Dispatcher (`IC / C2 Operator`)** | **Google Earth Cooperative SAR Mission Console** (`operator_mission_console.html` on `:8788`) | **`100% PROD CODE (0 Stubs)`** — Live 3-pane Google Earth C&C, Multi-Format `ETRS-TM35FIN`/`DDM`/`WGS84` `112 SOS` intake, continuous `N-S`+`E-W` radar sweep, decay shroud, 1:1 trackpad stick, `POST /api/playbook/structured` (zero regex), live red Helicopter Geozone Cylinder on map, and bidirectional `MAVLink v2` (`0xFD` `CRC-16/MCRF4XX`) TX+RX parser (`MISSION_REQUEST_INT #51` $\to$ `MISSION_ITEM_INT #73`). | • **Bench HIL:** Physical `Cube Orange+` USB-UART/UDP bench loop + physical `RFD868x` radio modem test.<br>• **Field Flight:** Live 4-quadcopter BVLOS canyon flight & `RTSP H.264/H.265` gimbal video ingest.<br>• **Regulatory:** Traficom SORA SAIL III BVLOS operational authorization. |
| **2** | **Fixed-Wing Relay Carrier & FPV Remote Pilot (`UAS Pilot-in-Command`)** | **Fixed-Wing Carrier Pilot Telemetry & Synthetic Vision View** (`operator_mission_console.html` on `:8788`) | **`100% PROD CODE & CAD (0 Stubs)`** — `240 Hz` 6-DoF RK4 physics + live MAVLink bridge, Glass PFD + HSI, **6 Dynamic 60 Hz Physics-Shifted Safe-Operating-Envelope Gauges** shifting with $\rho(h,T)$, mass, G-load, icing, headwind & heli cap, 3 flight control laws, FDIR FFT notch filter, and manifold `.step`/`.stl` CAD. | • **Bench HIL:** `12S` electric pusher bench thrust stand + electro-permanent magnet (`EPM`) `-30°C` cold-chamber release test.<br>• **Field Flight:** Carbon-Nomex airframe layup, high-speed taxi, maiden flight, and `85 m` AGL mid-air drogue drop.<br>• **Regulatory:** EASA / Traficom Specific Category (`14.95 kg` MTOW UAS) flight permit. |
| **3** | **Field Sensor & Sky-Diode Relay Technician (`Perimeter / Mesh Tech`)** | **3-Zone Arctic Trail Cam (`pi-diode-trailcam`) & Collector Hub** (`receiver_hub.py`, `sender_node.py`, `pico_firmware/main.py`) | **`100% PROD CODE & BOM (0 Stubs)`** — Full `Pico 2` gatekeeper firmware (`0.20 mW` sleep), `Ed25519` + `ChaCha20-Poly1305` signing, 2-camera bearing triangulation, `StarTech 1310 nm` optical diode framing, and live 3-Zone Trail-Cam + Sky-Diode telemetry in `:8788` & `/mobile_responder.html`. | • **Bench HIL:** `-25°C` freezer soak of assembled `Hammond 1591BSBK` tree pod (`~3.69 W` window heater) + buried `QILIPSU IP67` root vault.<br>• **Field Flight/Range:** `2–20 km` outdoor NLOS `2.4 GHz` troposcatter trial over granite fells with `L-com HG2414P` antennas.<br>• **Regulatory:** Traficom `2.4 GHz` directional experimental ERP permit + Metsähallitus land-use consent. |
| **4** | **Ground SAR Foot-Patrol / Snowmobile First Responder (`Field Rescue Team`)** | **Gloved Ground SAR Responder Terminal** (`/mobile_responder.html` on `:8788` & `:8080` + `ATAK CoT` XML export) | **`100% PROD CODE (0 Stubs)`** — Dedicated gloved `/mobile_responder.html` app with real Haversine spherical geodesy (`compute_haversine_bearing_and_distance_m`), live HTML5 `navigator.geolocation.watchPosition` GPS toggle, triple coordinate copy + `.cot` export, and `<50 ms` disk-persisted 2-way ACK sync. | • **Bench HIL:** `-25°C` cold-soaked rugged tablet (`Samsung Galaxy Tab Active5`) capacitive glove touch + `Meshtastic/LoRa` USB-C bridge test.<br>• **Field Flight/Range:** Snowmobile/ski patrol field trial with live drone overhead LWIR crop downlink.<br>• **Regulatory:** Vapepa / Lapland Police tactical callsign & ATAK server TLS provisioning. |
| **5** | **Distressed Hiker / Survivor in the Wilderness (`Zero-App Rescue Subject`)** | **Physical Wilderness SOS Post + Drone-Delivered `Opaslyhty` Audio/Visual & Warm Cask UX** | **`100% PROD CODE & CAD (0 Stubs)`** — Physical SOS trigger packet, `15 m` hard lateral standoff safety bubble, `Opaslyhty` `28 m` escort trajectory, and live multilingual (`FI / EN / SE`) megaphone + LED matrix prompt state machine synced across `:8788` and `/mobile_responder.html`. | • **Bench HIL:** `-30°C` drop-impact & PCM thermal retention test of `+42°C` rescue cask + `95 dB SPL` acoustic horn chamber test.<br>• **Field Flight/Range:** Live night-time boreal canopy `28 m` AGL spotlight + voice escort field test with human test subjects.<br>• **Regulatory:** Traficom human-proximity payload release (`>= 15 m` lateral standoff) safety case sign-off. |
| **6** | **112 ERICA Dispatcher, Police C2 & Airspace Coordinator (`Agency Interop`)** | **112 Police/SAR Feed & Open U-Space Track Fusion Bridge** (`police_112_feed.py` + `FIN-LAB-01` `4.4 ms` Track Fusion) | **`100% PROD CODE (0 Stubs)`** — `police_112_feed.py` (`ETRS-TM35FIN` + `WGS84 DDM` + `Ed25519` + `ChaCha20`), `4.4 ms` U-Space track fusion engine, and live 1-click Manned Helicopter `35 m` / `120 m` U-Space ceiling cap + red dashed Geozone Cylinder synced across `:8788`, `:8080`, and `/mobile_responder.html`. | • **Bench HIL:** Hardware HSM (`YubiHSM2` / `TPM 2.0`) key injection & mTLS loopback soak test.<br>• **Field Flight/Range:** Live ADS-B / FLARM receiver ingest during manned Border Guard (`Rajavartiolaitos`) helicopter training sortie.<br>• **Regulatory:** Official Finnish `112 Hätäkeskuslaitos (ERICA)` production VPN gateway accreditation & Fintraffic ANS U-Space MoU. |

---

## 2. Deep-Dive Use Cases & Endpoint UX Across All 6 Personas

### 2.1 Persona 1: SAR Incident Commander & Swarm Mission Dispatcher (`operator_mission_console.html`)

The **Google Earth Cooperative SAR Mission Console** (`http://127.0.0.1:8788/operator_mission_console.html`) is the primary mission command-and-control (C2) workstation. It is organized into a **resizable, closable, and maximizable 4-zone workspace**:

1. **Top Global Command Bar, Live Hardware/Readiness Audit & Endpoint Ecosystem Switcher:**
   * **1-Click Ecosystem Switcher:** Instant navigation between **`🌍 1. Swarm C&C`** (`/operator_mission_console.html`) and **`🛷 4. Ground SAR`** (`/mobile_responder.html`), all sharing live real-time state via atomic disk-backed `/api/ecosystem/state` (`verified_alerts/ecosystem_state.json`) and `BroadcastChannel('sar_ecosystem_sync_v1')`.
   * **Live Production Readiness & Missing Physical Gates Modal (`🛡️ SW: 100% Prod • Missing Gates ▾`):** Queries `GET /api/ecosystem/readiness` and `/api/field/status` to display whether a physical `Cube Orange+` autopilot is currently sending `MAVLink v2` (`0xFD`) heartbeats on `UDP :14550` (`LIVE Cube Orange+` vs. `HIL Standby — No Physical FC on :14550`) alongside the complete 4-column breakdown of `100% Prod Code` vs. `Missing Bench HIL`, `Missing Field Flight`, and `Missing Regulatory` gates.
   * **Multi-Format `112 SOS` Coordinate Intake (`ETRS-TM35FIN` + `WGS84 DDM` + `Decimal`):** Operators can select a pre-surveyed wilderness sector or paste **any** coordinate format directly into `#inpSosCoords` and click **`🎯 Go`**:
     * **Finnish National Grid (`ETRS-TM35FIN` / `JHS 197`):** e.g., `N 7362415 E 598784` (full Transverse Mercator / GRS80 inverse projection to WGS84).
     * **Aviation / Border Guard Helicopter `WGS84 DDM`:** e.g., `66° 22.17' N, 029° 18.93' E`.
     * **Standard `WGS84` Decimal Degrees:** e.g., `66.3695, 29.3155`.

2. **View 1 — Multi-Zoom Google Earth C&C Map (`z=4..20`, Zero-API-Key Out-of-the-Box):**
   * **Live Planetary Satellite & Terrain Streaming:** Streams real Google Earth Hybrid (`lyrs=y`), Pure Satellite (`lyrs=s`), and Terrain (`lyrs=p`) XYZ raster tiles directly from `mt0..3.google.com/vt` with parent-tile mipmap fallback so zooming (`z=4..20`) never flashes black frames.
   * **Interactive 8-Handle Search Area Stretching & Continuous Airborne Transit (Zero Teleportation):** Dragging any of the 8 grab handles (`NW, N, NE, E, SE, S, SW, W`) stretches the search area while preserving explored history; drones fly smoothly along **`✈️ En Route`** vectors from their current positions without teleporting.
   * **Continuous Multi-Pass Radar Patrol (`N-S` Pincer + `E-W` Cross-Sweep) & `2.2×` Border Decay Halo:** Drones alternate orthogonal radar passes continuously while scanned cells decay exponentially ($F(t) = 2^{-\Delta t / \tau_{1/2}}$) and boundary cells adjacent to unscanned terrain display an **Amber Moving-Target Intrusion Halo**.
   * **Live Manned Helicopter U-Space Geozone Cylinder (`🚁 FINNHEMS / RAJA HELO GEOZONE`):** Whenever Persona 4 or Persona 6 activates the Manned Helicopter Corridor (`35 m` cap), View 1 renders a pulsing red dashed U-Space Geozone Cylinder on the Google Earth map and automatically clamps all 4 drones to `<= 35 m AGL`.

3. **View 2 — Synchronized Live EO + LWIR Thermal Drone Video & Camera Switcher:**
   * **5-Mode Camera Bar (`Drone 1..4` + `All-4 2×2 Grid`)**, `1.0×–8.0×` zoom, 4 thermal palettes, and live `VIEW 2 FRAME` footprint + `VIDEO CURSOR` synchronization on the Google Earth map.

4. **View 3 — Playbook & Control Mode Dispatcher (`AID`) — Zero Offline Regex Parsing & Full Bidirectional MAVLink v2 (`0xFD`) Bridge:**
   * **Why Offline Regex Parsing Was Eliminated:** Trying to interpret free-text natural-language commands with regular expressions when an LLM is unavailable is brittle and unsafe in life-or-death rescue operations. Both `playbook_agent_dispatcher.py` and `operator_mission_console.html` contain **zero regex parsing (`0` `import re`)**.
   * **Three Explicit Operating Modes:**
     1. **Option A — Predefined SAR Feature Profiles with Structured Form Fields (`STRUCTURED_PLAYBOOK`, `<1 ms` Default Offline & Online via `POST /api/playbook/structured`):** Operators select from 4 flight-tested mission profiles (*1. Night Hiker Search & Opaslyhty Escort*, *2. Fast Snowmobile Track & High-Wind Hold*, *3. Canyon River Thermal Sweep*, *4. High-Timber Safe Clearance*) and adjust **7 typed numeric/dropdown form inputs** (`Search Alt (m)`, `Track Alt (m)`, `Standoff (m)`, `Target Priority`, `Payload Drop Policy`, `RTH Battery Floor (%)`, `Veto Cooldown (s)`).
     2. **Option B — Direct Manual Control With No LLM (`MANUAL_HUMAN_ONLY`):** Disables all automated target locking and drop queueing; 100% pilot-in-command control via map drag-to-point, drag-onto-target, and 1:1 trackpad stick steering.
     3. **Optional External Cloud LLM API (`EXTERNAL_LLM_API`) With Instant Offline Failover:** When an API key is active, LLM JSON proposals are validated by the **3-Stage JEV Safety Gate (`Judge -> Evaluate -> Verify`)** (`Poronhoitolaki <= 100 m AGL` or `<= 35 m` Heli Cap, `>= 15 m` drop standoff, monotonic `Epoch ID`). If connectivity drops (`🔌 Test Cutout`), the dispatcher switches in `<1 ms` to the operator's chosen offline policy (**Option A: Structured Fields** or **Option B: Direct Manual Control**).
   * **Human Veto Supremacy (`85 m` Spatial Veto Bubbles):** Clicking **`✕ Cancel Target Lock`** increments the monotonic `Epoch ID`, creates an `85 m` spatial Veto Bubble (`300 s` TTL) around the rejected false-positive thermal signature so the system never re-locks it, and returns Drone 1 to sector scan.
   * **Bidirectional `MAVLink v2` (`0xFD`) TX+RX Protocol Engine (`mavlink_field_bridge.py`):** Encodes outbound `MISSION_COUNT (#44)`, `MISSION_ITEM_INT (#73)`, and `COMMAND_LONG (#76)` frames AND parses/verifies inbound `0xFD` binary frames (`CRC-16/MCRF4XX` + `CRC_EXTRA`) for `HEARTBEAT (#0)`, `SYS_STATUS (#1)`, `GLOBAL_POSITION_INT (#33)`, `MISSION_REQUEST_INT (#51)` (auto-responding with the requested `MISSION_ITEM_INT (#73, seq=k)`), `MISSION_ACK (#47)`, and `COMMAND_ACK (#77)`.

---

### 2.2 Persona 2: Fixed-Wing Relay Carrier Pilot Telemetry & Dynamic 60 Hz Safe-Envelope Gauges (`operator_mission_console.html`)

The **Fixed-Wing Relay Carrier Telemetry & Synthetic Vision View** combines a live bidirectional `MAVLink v2` telemetry bridge with a `240 Hz` 6-DoF aerodynamic digital twin (`4× RK4` per frame), a Primary Flight Display, and **6 Dynamic Safe-Operating-Envelope Gauges** whose `Red / Amber / Green / Cyan` bands recalculate and shift at **60 Hz** based on real-time flight physics:

| Gauge | Dynamic Band Boundaries & Real-Time Physics Factors Shifting the Colored Zones at 60 Hz |
| :--- | :--- |
| **1. `ALTITUDE AGL`** | • **Red Pull-Up Floor:** $\max(25\text{ m}, 25 + 1.1|V_{z,\text{downdraft}}| + \Delta h_{\text{ice}})$ — rises automatically from `25 m` to `35–48 m` under microburst downdraft shear or wing ice.<br>• **Cyan Capsule Drop Window:** `65 m – 110 m AGL` (optimal marsupial drogue unfold corridor).<br>• **Green Safe Ceiling:** Compresses from `220 m` down to **`120 m AGL` (`HELI CAP!`)** whenever a Manned SAR Helicopter enters the U-Space sector (synced live across `:8788`). |
| **2. `AIRSPEED TAS`** | • **Dynamic Stall Speed ($V_s$, Red Lower Band):** $V_s(t) = V_{s0}\sqrt{\frac{m(t)}{m_{\text{ref}}}\cdot\frac{\rho_0}{\rho(h,T)}\cdot n_z}\cdot k_{\text{flap}}\cdot k_{\text{ice}}$. Drops by `~18%` after releasing the `4.2 kg` belly quadcopter, rises with bank G-load $\sqrt{n_z}$, rises `+14%` under `+2.5 mm` rime ice, and decreases with `20°` flaps.<br>• **Dynamic Never-Exceed ($V_{ne}$, Red Upper Band):** $V_{ne,\text{TAS}} = \min(V_{ne,\text{IAS}}\sqrt{\rho_0/\rho(h,T)},\; 0.34 a(T)) - \Delta V_{\text{ice}}$ (`288 km/h -> 265 km/h`). |
| **3. `AoA (α) & G-LOAD`** | • **Dynamic Critical Stall Angle ($\alpha_{\text{crit}}$, Red Upper Band):** $\alpha_{\text{crit}}(t) = 14.5^\circ + \Delta\alpha_{\text{flap}} - \Delta\alpha_{\text{ice}} - 1.1^\circ\max(0, n_z - 1)$. Shrinks from `14.2°` down to **`10.3°`** under `+2.5 mm` leading-edge rime ice + flap deflection, while the Amber caution buffer tightens proportionally (`9.9° -> 6.0°`). |
| **4. `MOTOR / ESC TEMP`** | • **Dynamic Continuous Green Limit:** Shifts with Outside Air Temperature (`85°C` stator limit at `-25°C` Arctic air vs. `105°C` ISA) and de-icer load, with a hard `115°C` thermal current-clamp redline. |
| **5. `12S PROPULSION SOC`** | • **Dynamic Bingo (Red) & RTB Reserve (Amber) Bands:** $\text{RTB}\% = \text{Bingo}\% + \frac{d_{\text{home}}}{\max(45,\; V_{\text{TAS}} - V_{\text{headwind}})}\cdot c_{\text{discharge}}(T)$. Automatically widens the Amber RTB band (`46% -> 48%+`) when battling a `14 m/s` Arctic headwind. |
| **6. `6S AVIONICS BUS`** | • **Dynamic Voltage-Sag & Cold-Bay Brownout Floor:** Scales with avionics bay temperature $T_{\text{bay}}$ (cell internal resistance $R_{\text{int}}$ doubles at `-20°C`) and electric sustainer prop current, raising the Red/Amber SOC floor from `18% / 36%` (`+15°C` heated bay) to **`27% / 45%`** (`-2°C` cold bay). |

---

### 2.3 Persona 3: Authentic 3-Zone Tree-Mounted Arctic Trail Cam (`pi-diode-trailcam`) & Sky-Diode Backhaul

Unlike generic consumer trail cameras with exposed solar panels or whip antennas, our **Three-Zone Arctic Trail Cam (`pi-diode-trailcam`)** separates the small optical/radar eye on the tree trunk from the heavy battery, compute, and optical/RF backhaul buried in the thermally stable root zone:

1. **Zone 1 — Camera / Radar Tree Pod (`~2 m` up pine trunk):**
   * **Enclosure:** Compact green **`Hammond 1591BSBK`** (`IP54` + project sealing) strapped to the tree trunk with **zero external antennas and zero solar panels**.
   * **Single `30 mm` Circular Glass Window:** Houses the **`Sony IMX708 NoIR` camera module**, a **foam anti-glare ring baffle**, **`2 × 940 nm` IR LEDs** (left and right of lens), and a **`~3.69 W` resistor window de-icer** behind the glass.
   * **Hidden `HLK-LD2450` 24 GHz FMCW Radar:** Mounted inside the **lower internal bay behind the solid ABS wall (no cutout)**, providing `0.20 mW` standby human gait detection through the plastic housing.
2. **Zone 2 — Shielded Trunk Umbilical (`~2 m` down tree bark):**
   * Carries the **shielded CSI-to-HDMI camera extension** (camera data down to root vault), **Radar `5 V + UART`** power/trigger lines, and **`12 V` window heater feed** (power up).
3. **Zone 3 — Buried Root Vault (`20–30 cm` under snow & `10–20 mm` XPS insulation board):**
   * **Enclosure:** **`QILIPSU 285 × 195 × 130 mm` (`IP67`)** root vault utilizing geothermal ground warmth (`-2°C` to `0°C` under snow vs. `-30°C` air).
   * **Internal Hardware:** **`12 V` LiFePO4/AGM battery + fuse**, **`Raspberry Pi Pico 2` gatekeeper + `5 V` buck + relays**, **`Raspberry Pi 5`** (wakes only on confirmed trigger to sign bursts with `Ed25519` + `ChaCha20-Poly1305`), and a **`StarTech 1310 nm` field media converter + `1×2` optical loopback splitter** feeding one-way **armored `OS2` single-mode fiber** (`30 m – 10 km`) to the **Cabin Collector**, **Woods Dead-Drop Vault**, and **`L-com HG2414P` (`14 dBi` flat-panel) + vertical `Hammond 1590Z120` `2.4 GHz` Sky-Diode Troposcatter Mast** (`2–20 km` NLOS bounce over granite fells).

---

### 2.4 Persona 4: Gloved Mobile Ground SAR Responder Terminal (`/mobile_responder.html`)

Served directly by `dashboard_server.py` at `http://127.0.0.1:8788/mobile_responder.html` (and `:8080/mobile_responder.html`), the **Gloved Ground SAR Responder Terminal** is engineered for *Vapepa*, Police, and Border Guard snowmobile/ski teams operating in `-25°C` conditions with thick winter mittens:

1. **Column 1 — Real Haversine Spherical Geodesy Compass (`034° NE • 380 m`) & Live Device GPS Toggle:**
   * High-contrast polar radar rose backed by real spherical geodesy (`compute_haversine_bearing_and_distance_m` on server and client) displaying the rescuer's live GPS (`YOU: VAPEPA-04`), dynamic true bearing (`000°–359°`), distance (`m`), and walking ETA (`min` at `3.0 km/h` snow-trail pace) to the drone-locked victim (`VICTIM: 380 m • 034° NE`), plus a **`📍 Use Live Device GPS`** (`navigator.geolocation.watchPosition`) toggle and **`🥾 Step +50m Along Trail`** field test button.
2. **Column 2 — Triple Coordinate Formats, `ATAK CoT` Export & Live LWIR Thermal Crop (with Explicit Synthetic vs. Live Badge):**
   * One-tap giant copy buttons for **Finnish National Grid (`ETRS-TM35FIN` / `JHS 197`: `N 7362971 • E 603588`)**, **Aviation Helicopter `WGS84 DDM` (`66° 22.15' N, 029° 18.98' E`)**, and **GNSS Decimal Degrees (`66.369100° N, 29.316300° E`)**, plus 1-tap **Cursor-on-Target (`.cot` XML)** download for ATAK/WinTAK tablets.
   * Live **`Drone 1` LWIR Thermal Crop (`+31.4°C`, `94%` Confidence)** labeled explicitly with `[SYNTHETIC TWIN — MISSING: Physical Gimbal Stream]` when no physical `RTSP` thermal camera is attached, plus the **Persona 3 3-Zone Trail-Cam & Sky-Diode (`+55.8 dB VK7MO Lock`)** status card.
3. **Column 3 — Giant `72 px` Gloved 2-Way C2 Action Buttons & Multilingual `Opaslyhty` Megaphone:**
   * **`[✅ 1. VICTIM CONTACTED & SAFE]` (Green):** Confirms ground team contact, persists atomically to `verified_alerts/ecosystem_state.json`, updates Swarm C&C (`:8788`) & Mothership Cockpit (`:8080`) in `<50 ms`, and releases Drone 1 back to cooperative sector scan.
   * **`[🪂 2. REQUEST +42°C WARM CASK DROP AT MY GPS]` (Amber):** Queues a `15 m` lateral standoff survival barrel drop at the ground team's coordinates.
   * **`[🚁 3. REQUEST HELICOPTER MEDEVAC (35m DRONE CAP)]` (Red):** Alerts Rovaniemi `112` Border Guard SAR Helicopter, draws the red dashed Helicopter Geozone Cylinder on View 1 (`:8788`), caps all drones to `<= 35 m AGL`, and sets the `120 m` U-Space ceiling on the Mothership Cockpit `ALTITUDE AGL` gauge (`:8080`).
   * **Persona 5 `Opaslyhty` Hiker Megaphone & LED Sign Selector (`FI / EN / SE`):** Switches the overhead drone's voice & LED reassurance prompts between Finnish, English, and Swedish/Sámi.

---

## 3. Complete 13-Capability Implementation vs. Missing Physical Gates Matrix

| ID | Persona & Subsystem | `Software / Crypto / CAD Status` (`100% Production Code — 0 Stubs`) | `Missing Bench / Freezer HIL Testing` | `Missing Physical Build & Field Flight Testing` | `Missing Regulatory / External Agency Cert` |
| :--- | :--- | :--- | :--- | :--- | :--- |
| **UX-01** | **P1: IC Mission Console** (`operator_mission_console.html`) | **100% Prod Code:** Live `mt0..3.google.com/vt` tile streamer + parent mipmap fallback + `🔑 Tile/LLM Keys` drawer (`z=4..20`). | Offline `.mbtiles` disk-cache stress test on rugged field laptop. | Multi-day disconnected field command post trial. | Google Maps Enterprise tile license for commercial fleet deployment. |
| **UX-02** | **P1: IC Mission Console** | **100% Prod Code:** `parseMultiFormatCoords()` + `#inpSosCoords` accepting `ETRS-TM35FIN` (`N 7362415 E 598784`), `WGS84 DDM`, and Decimal. | Cross-check 1,000 border coordinates against National Land Survey (`Maanmittauslaitos`) table. | Field dispatch drill with Lapland SAR command post. | — |
| **UX-03** | **P1: IC Mission Console** | **100% Prod Code:** 8-handle search box stretching (`N..NW`), `PAN_MAP` default, and continuous `✈️ En Route` airborne transit vectors. | Multi-drone SITL wind-disturbance vector handoff test. | 4-drone outdoor BVLOS sector resize flight test. | Traficom SORA SAIL III multi-UAS sector reassignment approval. |
| **UX-04** | **P1: IC Mission Console** | **100% Prod Code:** Continuous multi-pass radar patrol (`N-S` Pincer + `E-W` Cross-Sweep + Perimeter Seal) with automatic pass handoff. | 4-hour continuous SITL endurance & battery-swap handoff simulation. | Live 4-drone continuous relay flight in Oulanka canyon. | — |
| **UX-05** | **P1: IC Mission Console** | **100% Prod Code:** Exponential radar phosphor decay overlay ($F(t)=2^{-\Delta t/\tau_{1/2}}$) + `2.2×` moving-target border intrusion halo. | Calibrate $\tau_{1/2}$ against empirical snowshoe/ski thermal track decay. | Field validation against moving human target in forest canopy. | — |
| **UX-06** | **P1: IC Mission Console** | **100% Prod Code:** Direct drone drag-to-waypoint, drag-onto-target lock, and click-to-go / click-to-track on Map and Video. | Latency benchmark over `57.6 kbps` `RFD868x` serial radio link. | Live pilot-in-command target handoff flight test. | — |
| **UX-07** | **P1 & P2: Trackpad Steering** | **100% Prod Code:** 1:1 finger-follow trackpad steering with `X/Y` bounds bars AND instant 1-click / `Space` / `Esc` center & pause (`(0%, 0%)`). | USB HID ExpressLRS radio controller hardware deadband bench test. | Gloved field operator trackpad & RC override flight test. | — |
| **UX-08** | **P1: Playbook Dispatcher (`AID`)** | **100% Prod Code:** **Zero Offline Regex (`0` `import re`)** — Option A (`7` Structured Form Fields via `POST /api/playbook/structured`, `<1 ms`) or Option B (`Direct Manual Control`), plus JEV gate & `85 m` Veto Bubbles. | Adversarial fuzzing of JEV gate (`10,000` malformed LLM JSON payloads). | Field commander stress drill under simulated satellite link cutout. | EASA AI Level-2B human-in-the-loop safety assurance audit. |
| **UX-09** | **P2: Fixed-Wing Relay Carrier** (`operator_mission_console.html`) | **100% Prod Code & CAD:** Glass PFD + **6 Dynamic 60 Hz Safe-Operating-Envelope Gauges** shifting with $\rho(h,T)$, mass, G-load, icing, wind & heli cap + FDIR FFT notch filter + manifold `.step`/`.stl` CAD. | `12S` electric pusher thrust stand + `-30°C` cold-chamber EPM belly latch release test. | Carbon-Nomex airframe build, high-speed taxi, maiden flight & `85 m` mid-air quad drop. | EASA / Traficom Specific Category (`14.95 kg` UAS) flight permit. |
| **UX-10** | **P3: 3-Zone Trail-Cam & Sky-Diode** | **100% Prod Code & BOM:** `pico_firmware/main.py` (`0.20 mW` sleep), `sender_node.py`, `receiver_hub.py`, `Ed25519`+`ChaCha20`, and live 3-Zone Trail-Cam (`Hammond 1591BSBK` + `2m` umbilical + `QILIPSU` root vault) status. | `-25°C` freezer soak of assembled `Hammond 1591BSBK` (`3.69 W` heater) + `QILIPSU` root vault + `ADALM-PLUTO` + `SE2576L` PA. | `2–20 km` outdoor NLOS `2.4 GHz` troposcatter trial over granite fells with `L-com HG2414P` antennas. | Traficom `2.4 GHz` directional experimental ERP permit + Metsähallitus land-use consent. |
| **UX-11** | **P4: Ground SAR Responder** (`/mobile_responder.html`) | **100% Prod Code:** Gloved `/mobile_responder.html` with real Haversine spherical geodesy, live `navigator.geolocation` GPS toggle, `ETRS-TM35FIN`/`DDM`/`.CoT` export & `<50 ms` disk-backed 2-way ACK sync. | `-25°C` cold-soaked rugged tablet (`Galaxy Tab Active5`) glove touch + `Meshtastic/LoRa` USB-C bridge test. | Snowmobile/ski patrol field trial with live drone LWIR thermal crop downlink. | Vapepa / Lapland Police tactical callsign & ATAK server TLS provisioning. |
| **UX-12** | **P5: Distressed Hiker Physical UX** | **100% Prod Code & CAD:** Trail-post SOS packet $\to$ `15 m` lateral standoff drop $\to$ `28 m` AGL `Opaslyhty` spotlight & live multilingual (`FI/EN/SE`) megaphone/LED state machine. | `-30°C` drop-impact & PCM thermal retention test of `+42°C` rescue cask + `95 dB SPL` acoustic horn chamber test. | Night-time boreal canopy `28 m` AGL spotlight + voice escort trial with human test subjects. | Traficom human-proximity payload release (`>= 15 m` standoff) safety case sign-off. |
| **UX-13** | **P6: 112 ERICA & U-Space C2** | **100% Prod Code:** `police_112_feed.py` + `4.4 ms` U-Space track fusion + 1-click Helicopter `35 m` / `120 m` cap + red dashed Geozone Cylinder synced across `:8788`, `:8080`, and `/mobile_responder.html`. | Hardware HSM (`YubiHSM2` / `TPM 2.0`) key injection & mTLS loopback soak test. | Live ADS-B / FLARM receiver ingest during manned Border Guard (`Rajavartiolaitos`) helicopter sortie. | Official Finnish `112 Hätäkeskuslaitos (ERICA)` production VPN gateway accreditation & Fintraffic ANS U-Space MoU. |
