arctic-trail/karhunkierros-sar-drone/docs/images/real_build/stage3_24_full_benchtop_clean_separated_bundles_golden_overview.jpg

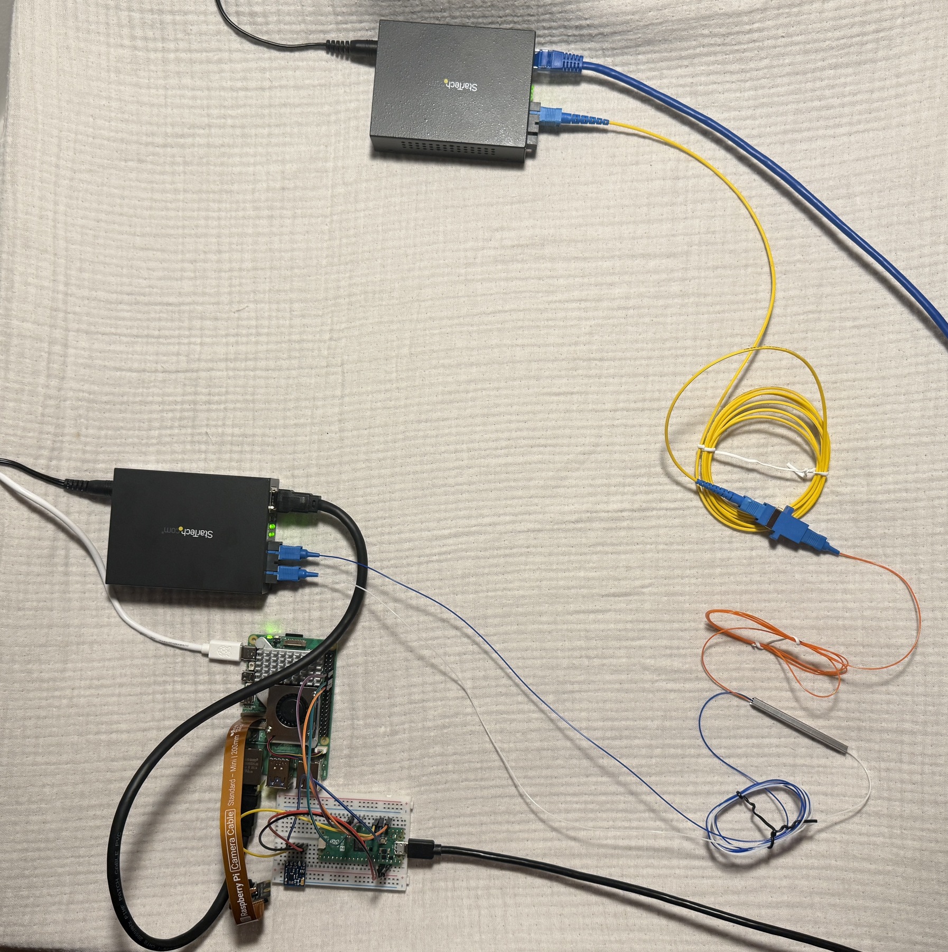
docs/images/real_build/stage3_24_full_benchtop_clean_separated_bundles_golden_overview.jpg
