arctic-trail/karhunkierros-sar-drone/docs/images/sar_operator_cnc_mission_ux_v11.jpg

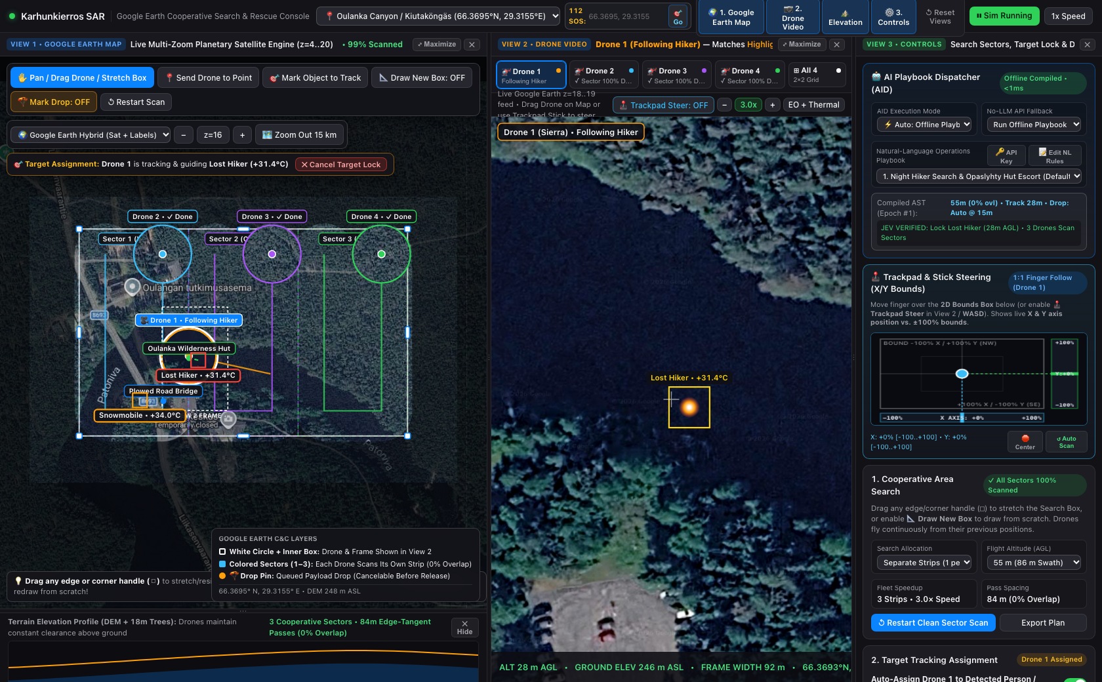
docs/images/sar_operator_cnc_mission_ux_v11.jpg
