arctic-trail/karhunkierros-sar-drone/pcb/Allied_EU_COTS_BOM.csv

Item_ID | SSOT_Part_Key | Category | Manufacturer_Part_Number | Description | Supplier_EU_Allied | Qty | Unit_Mass_kg | Total_Mass_kg | Unit_Cost_EUR | Total_Cost_EUR | Custom_PCB | Bench_Status
P01 | P01_Holybro_X500_V2_Frame_Motors | Airframe & Propulsion | Holybro-30056-X500-V2-ARF | Holybro X500 V2 500mm 3K Carbon Fiber Quadcopter Kit + 4x 2216 KV920 Brushless Motors + 4x BLHeli_S 20A ESCs + 4x 1045 Carbon-Nylon Propellers + 270mm Wide-Stance Carbon Landing Skids | Holybro / DroneShop.nl (EU) | 1 | 0.755 | 0.755 | 290.00 | 290.00 | False | ON_BENCH
P02 | P02_Holybro_Pixhawk_6C_Mini_PM02V3 | Flight Controller & Power Sense | Holybro-11021-PX6C-Mini-PM02V3 | Holybro Pixhawk 6C Mini (STM32H743 + ICM-42688-P + BMI088 Dual Heated IMU) + PM02 V3 12S XT60 Power Module (18.182 V/V Divider on Pin 4 & 36.36 A/V Shunt on Pin 3) | Holybro / Mouser EU | 1 | 0.068 | 0.068 | 225.00 | 225.00 | False | ON_BENCH
P03 | P03_Holybro_M10_GPS_Compass | GNSS & Magnetometer | Holybro-12029-M10-GPS | Holybro M10 Multi-Constellation GNSS (GPS/Galileo/GLONASS/BeiDou) + IST8310 Compass on Rear-Port Folding Pedestal Mast (-68 +64 mm) | Holybro / Mouser EU | 1 | 0.042 | 0.042 | 59.00 | 59.00 | False | ON_BENCH
P04 | P04_Molicel_P45B_4S2P_9000mAh_PTC | Arctic Energy Storage & Thermal Bay | INR21700-P45B-4S2P-EPP15-PTC10W | 8x Molicel INR21700-P45B (4S2P 14.4V 9.0Ah Low-Impedance Li-Ion Pack) + 100A 4S BMS + JST-XH Balance Lead + 60A MIDI Fuse + 174x114x104mm (15mm Wall) EPP Enclosure + 10W Polyimide PTC Heater + DS18B20 + IRLZ44N MOSFET | NKON.nl (NL) / DigiKey EU | 1 | 0.785 | 0.785 | 129.00 | 129.00 | False | ON_BENCH
P05 | P05_Benewake_TF02_Pro_BMP390_Mount | Multi-Modal Altitude & Baro Suite | TF02-Pro-40m-BMP390-JSTGH | Benewake TF02-Pro 40m IP65 Optical ToF Altimeter (69x41.5x26mm Nadir on SERIAL4 RNGFND1_TYPE 19) + Bosch BMP390 Precision Barometer (BARO_GND_TEMP Hypsometric Cold-Air Compensation) | Mouser EU / Eckstein GmbH | 1 | 0.085 | 0.085 | 145.00 | 145.00 | False | ON_BENCH
P06 | P06_RPi5_Topdon_TC001_LWIR_Pod | Companion Compute & LWIR/EO/LoRa Payload | RPi5-8GB-TC001-IMX296-SX1262-BEC12S | Raspberry Pi 5 (8GB) + Active Cooler + Topdon TC001 256x192 25Hz LWIR Thermal Camera (-45 deg Oblique-Nadir) + RPi Global Shutter Camera (IMX296 Nadir VIO) + Waveshare SX1262 868MHz LoRa HAT + Matek BEC12S-PRO 5V/5A UBEC | BerryBase DE / Mouser EU / Topdon EU | 1 | 0.525 | 0.525 | 415.00 | 415.00 | False | ON_BENCH
P07 | P07_ELRS_868MHz_C2_And_RemoteID | C2 Telemetry & EU SORA Compliance | RM-Bandit-868MHz-ELRS-Holybro-RID | RadioMaster Bandit Micro 868MHz ExpressLRS Diversity C2 Receiver (CRSF on RC IN) + Holybro EU Direct Remote ID Broadcast Module (DroneCAN) | DroneShop.nl / Holybro EU | 1 | 0.065 | 0.065 | 48.00 | 48.00 | False | ON_BENCH
P08 | P08_Silicone_Harness_PEEK_Fasteners | Thermal Isolation & Integration Hardware | 12AWG-SIL-PEEK-M3-KEVLAR | 12 AWG Silicone 200C (-60C) Foam-Labyrinth Harness + PEEK Thermal-Break Standoff Isolators + M3 Silicone Vibration Bobbins + Dual Kevlar Battery Straps + Loctite 243 | Wurth Elektronik / Boker DE | 1 | 0.055 | 0.055 | 18.00 | 18.00 | False | ON_BENCH
P09 | P09_Polar_Night_Strobe_Shepherd_Starvis_Kit | Polar-Night Kaamos Guiding-Lantern & Starvis-2 NoIR Kit | IMX462-STARVIS2-XPG3-3W-EASA-STROBE | EASA 3sm Green Night Anti-Collision Strobe Dome (0.5W Dorsal) + Cree XP-G3 3.0W 350lm Warm-White PWM Downward Hiker Shepherd LED Spot (AO3400 MOSFET on AUX1 SERVO9) + Sony IMX462 Starvis-2 NoIR 0.0001 lux Low-Light Optical-Flow Sensor | BerryBase DE / Mouser EU / DroneShop.nl | 1 | 0.030 | 0.030 | 45.00 | 45.00 | False | ON_BENCH
