arctic-trail/karhunkierros-sar-drone/docs/images/real_build/stage1_01_unboxed_parts.jpg

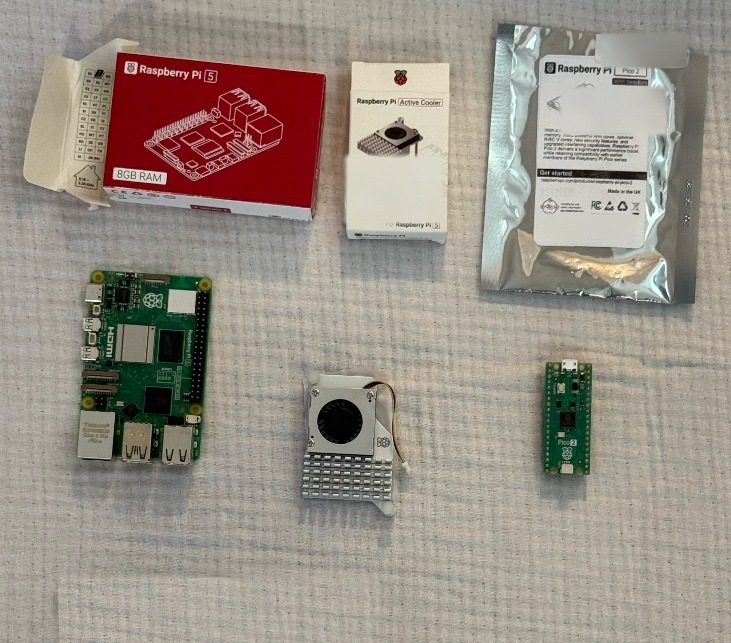
docs/images/real_build/stage1_01_unboxed_parts.jpg
