arctic-trail/karhunkierros-sar-drone/cad/opaslyhty_x500v2_sar_assembly.step

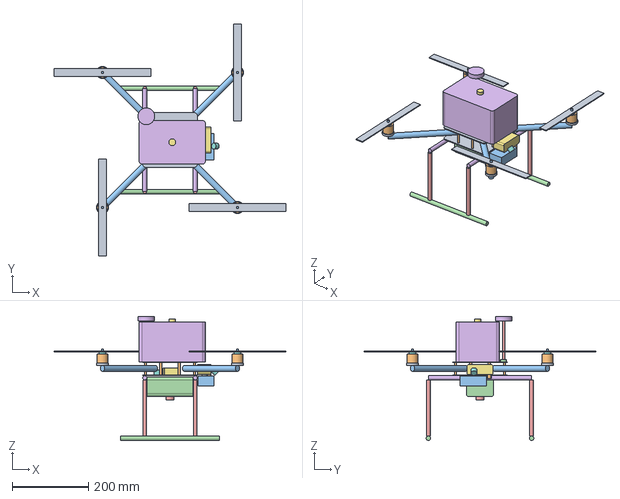
[picture p25: CAD file, 2026-11-12]
cad/opaslyhty_x500v2_sar_assembly.step
607.6 x 607.6 x 325.0 mm
