arctic-trail/karhunkierros-sar-drone/maritime_usv_finlab06/cad/finlab06a_hull_frames_and_deck_1to1.dxf

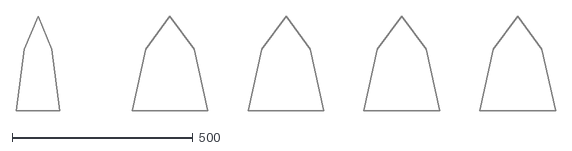
[picture p26: CAD file, 2026-10-22]
maritime_usv_finlab06/cad/finlab06a_hull_frames_and_deck_1to1.dxf
1490.0 x 260.0
