arctic-trail/karhunkierros-sar-drone/(list of files, cad)

Other CAD files:
cad/opaslyhty_x500v2_sar_cnc_plates.dxf
maritime_usv_finlab06/cad/finlab06a_catamaran_1850mm.step
cad/opaslyhty_x500v2_sar_assembly.stl
maritime_usv_finlab06/cad/finlab06a_catamaran_1850mm.stl
