arctic-trail/karhunkierros-sar-drone/docs/images/flashing_steps/step01_device_select.png

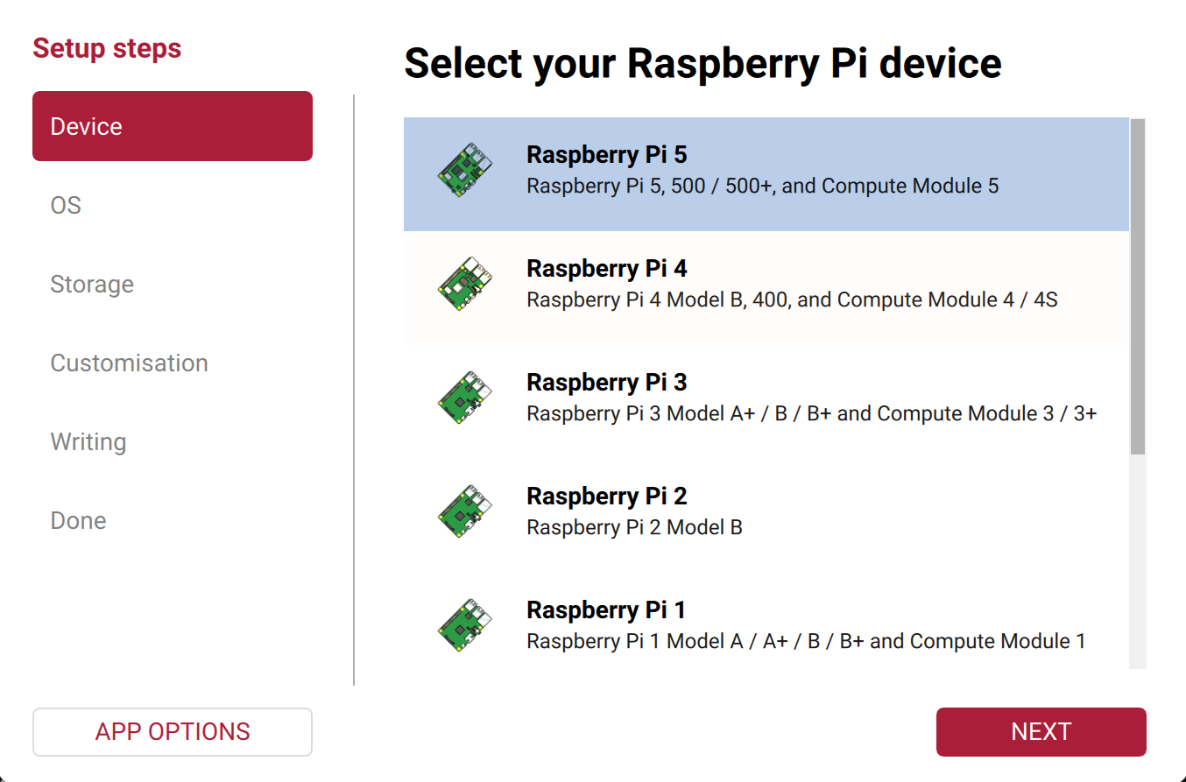
docs/images/flashing_steps/step01_device_select.png
