arctic-trail/karhunkierros-sar-drone/docs/images/flashing_steps/step03_os_other.png

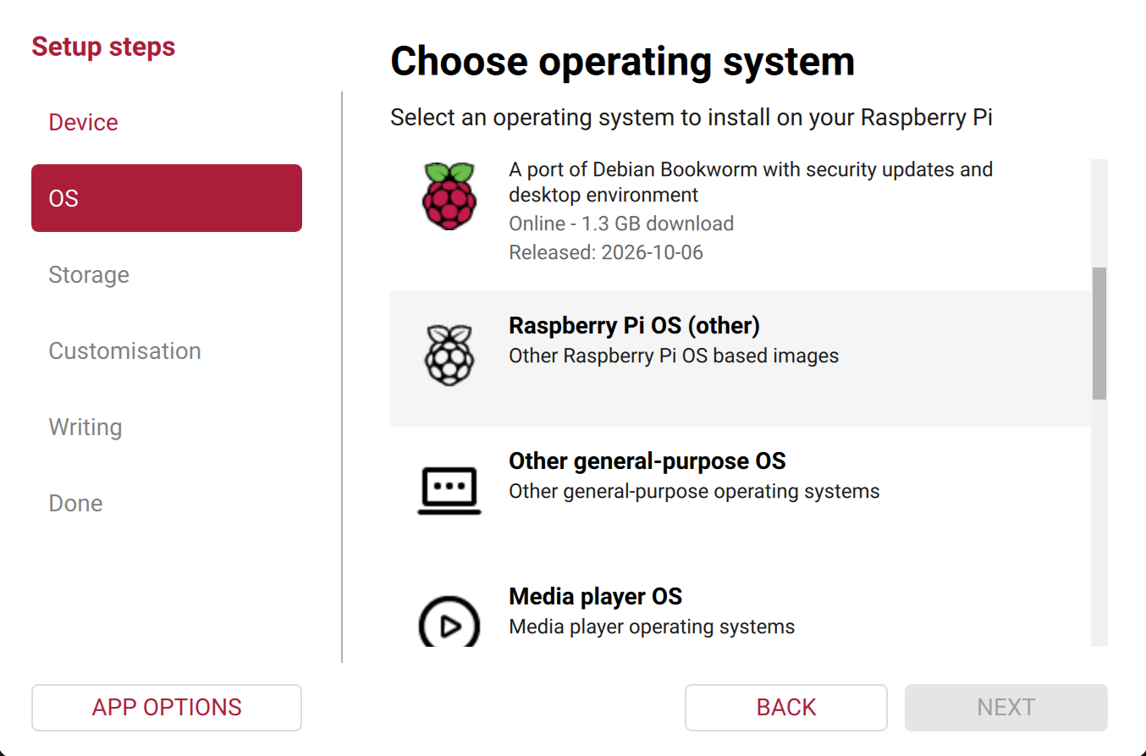
docs/images/flashing_steps/step03_os_other.png
