arctic-trail/karhunkierros-sar-drone/docs/images/flashing_steps/step04_os_lite_64bit.png

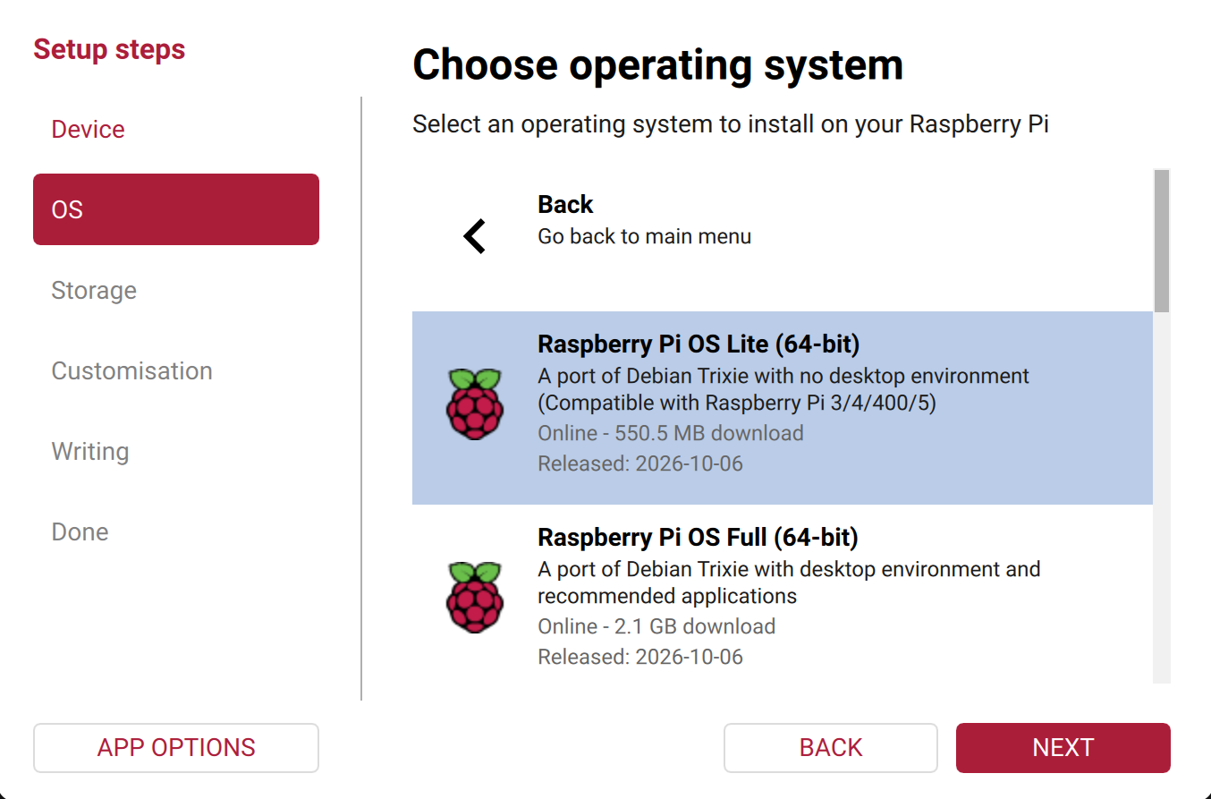
docs/images/flashing_steps/step04_os_lite_64bit.png
