arctic-trail/karhunkierros-sar-drone/docs/images/flashing_steps/step07_hostname_trailcam_node.png

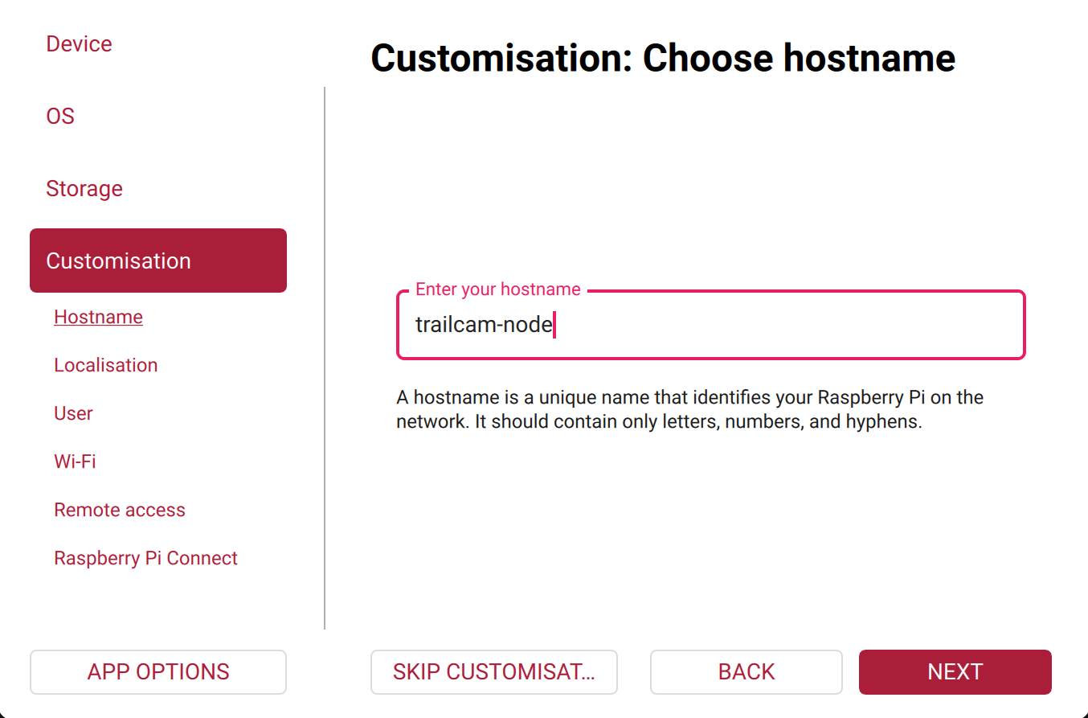
docs/images/flashing_steps/step07_hostname_trailcam_node.png
