arctic-trail/karhunkierros-sar-drone/docs/images/flashing_steps/step09_user_pi.png

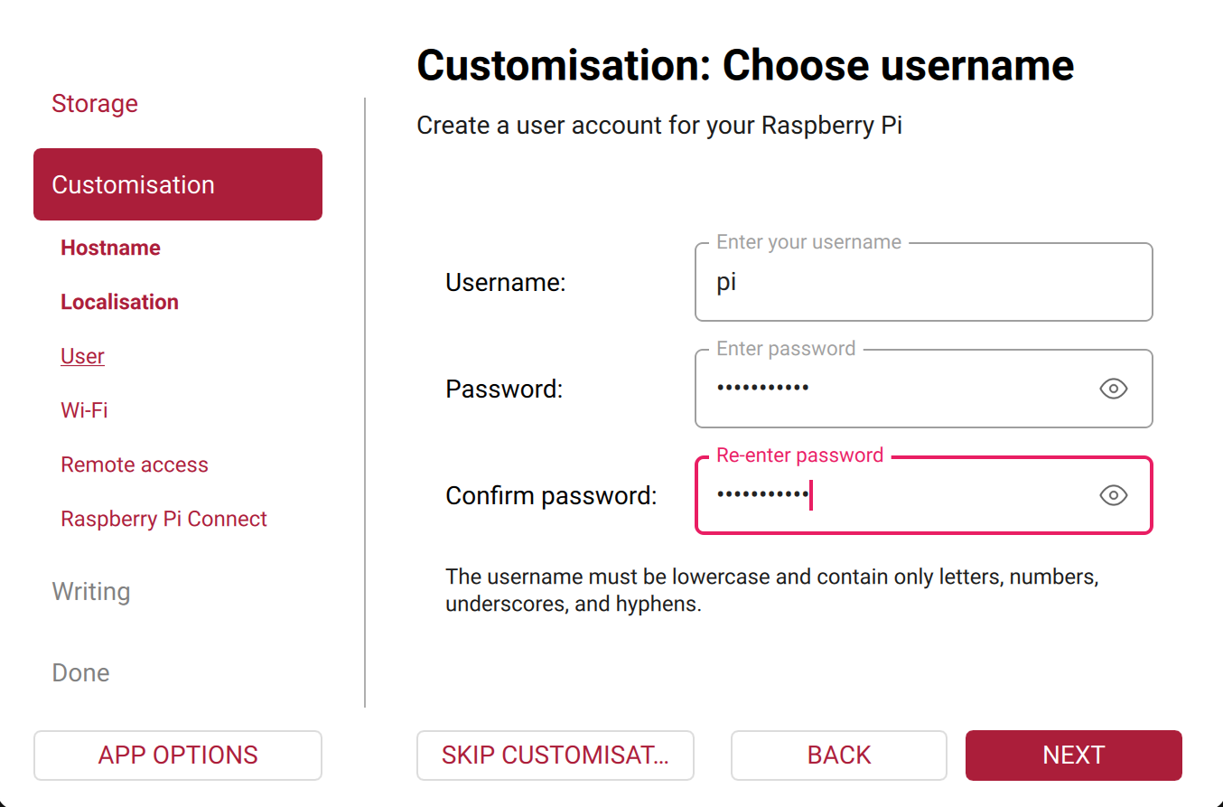
docs/images/flashing_steps/step09_user_pi.png
