arctic-trail/karhunkierros-sar-drone/docs/images/flashing_steps/step11_ssh_enable.png

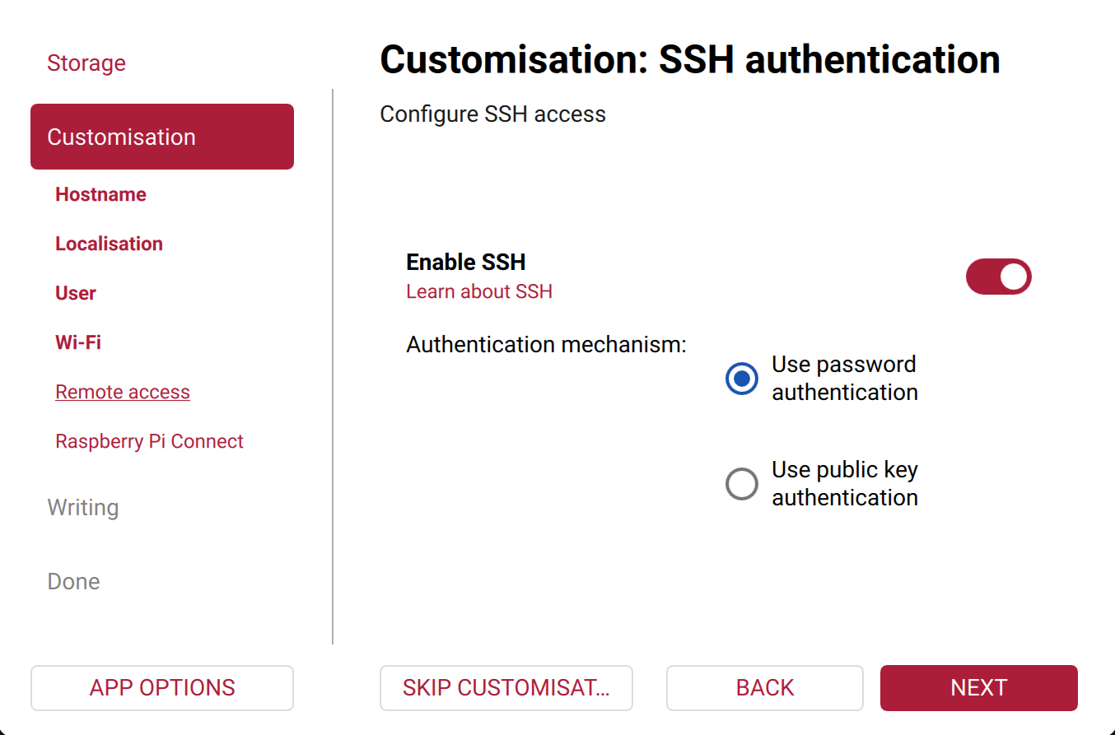
docs/images/flashing_steps/step11_ssh_enable.png
