arctic-trail/karhunkierros-sar-drone/docs/images/flashing_steps/step17_write_complete.png

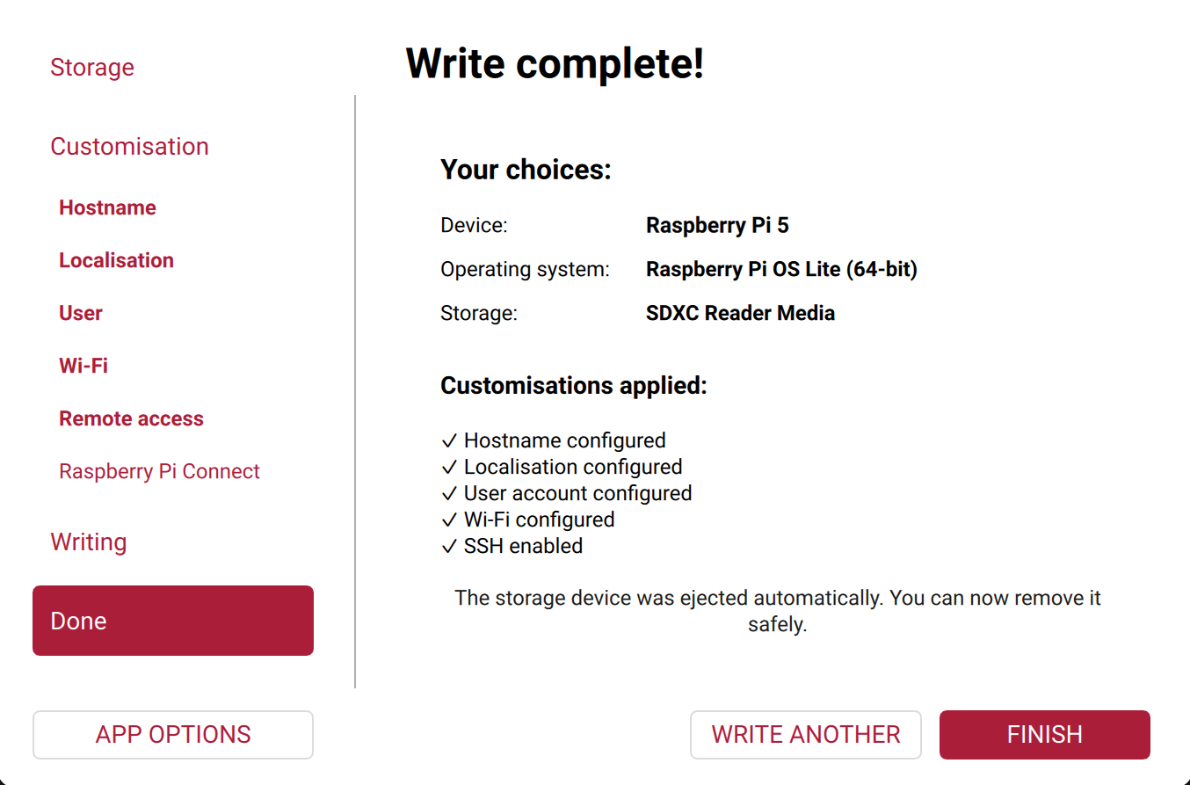
docs/images/flashing_steps/step17_write_complete.png
