arctic-trail/karhunkierros-sar-drone/docs/images/real_build/ribbon_wide_vs_narrow_ends_guide_v1.jpg

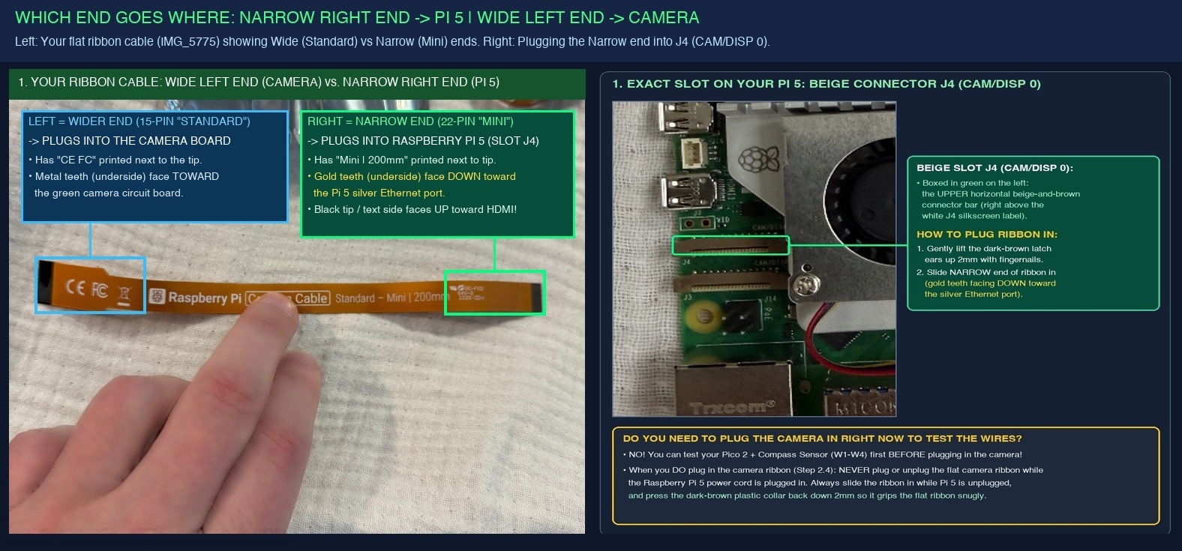
docs/images/real_build/ribbon_wide_vs_narrow_ends_guide_v1.jpg
