arctic-trail/karhunkierros-sar-drone/docs/images/real_build/stage1_02_peeling_thermal_film.jpg

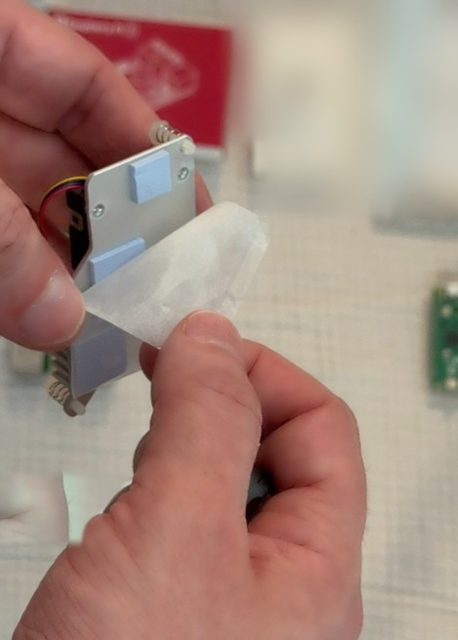
docs/images/real_build/stage1_02_peeling_thermal_film.jpg
