arctic-trail/karhunkierros-sar-drone/docs/images/real_build/stage1_03_cooler_top_alignment.jpg

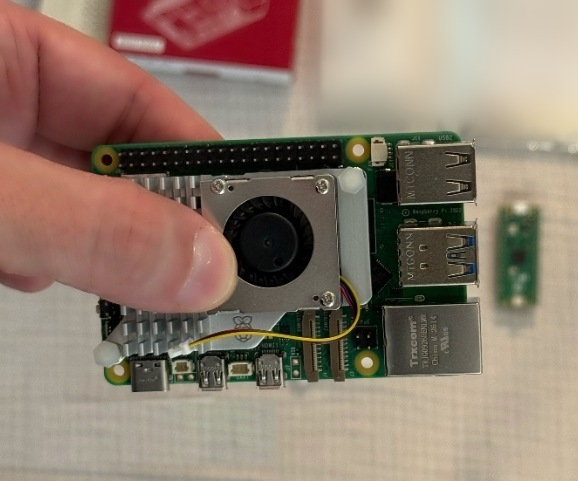
docs/images/real_build/stage1_03_cooler_top_alignment.jpg
