arctic-trail/karhunkierros-sar-drone/docs/images/real_build/stage1_04_hdmi_camdisp_clearance.jpg

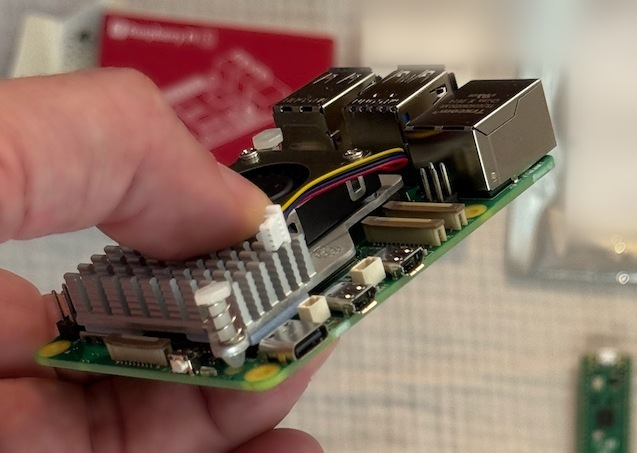
docs/images/real_build/stage1_04_hdmi_camdisp_clearance.jpg
