arctic-trail/karhunkierros-sar-drone/docs/images/real_build/stage1_05_gpio_side_profile_pins_locked.jpg

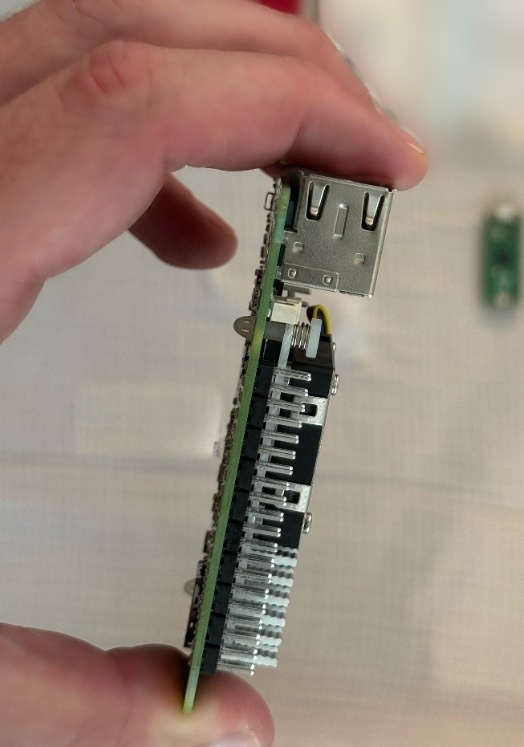
docs/images/real_build/stage1_05_gpio_side_profile_pins_locked.jpg
