arctic-trail/karhunkierros-sar-drone/docs/images/real_build/stage1_06_ports_edge_profile.jpg

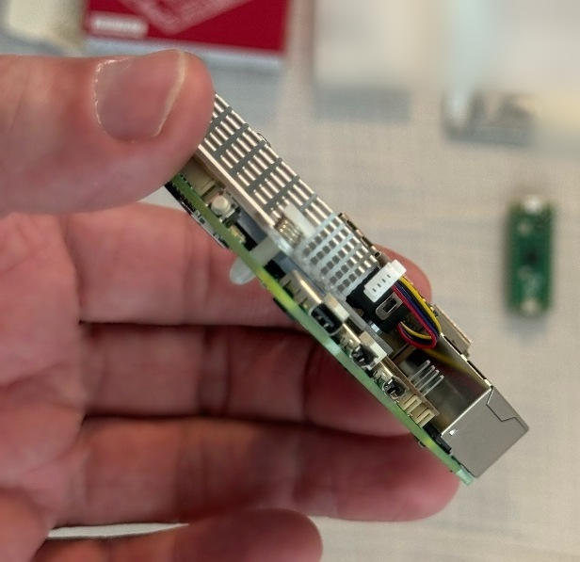
docs/images/real_build/stage1_06_ports_edge_profile.jpg
