arctic-trail/karhunkierros-sar-drone/docs/images/real_build/stage1_07_fan_socket_j11_closeup.jpg

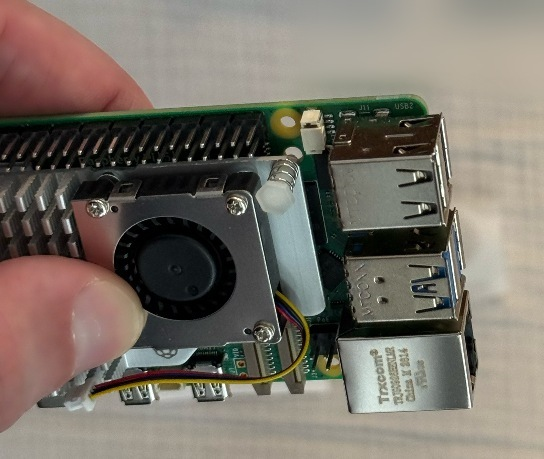
docs/images/real_build/stage1_07_fan_socket_j11_closeup.jpg
