arctic-trail/karhunkierros-sar-drone/docs/images/real_build/stage1_07b_pointing_at_j11_dust_cap.jpg

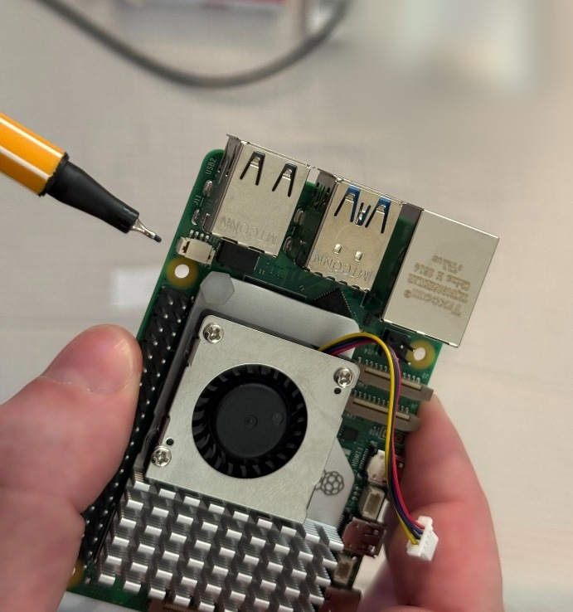
docs/images/real_build/stage1_07b_pointing_at_j11_dust_cap.jpg
