arctic-trail/karhunkierros-sar-drone/docs/images/real_build/stage1_07c_prying_j11_dust_cap.jpg

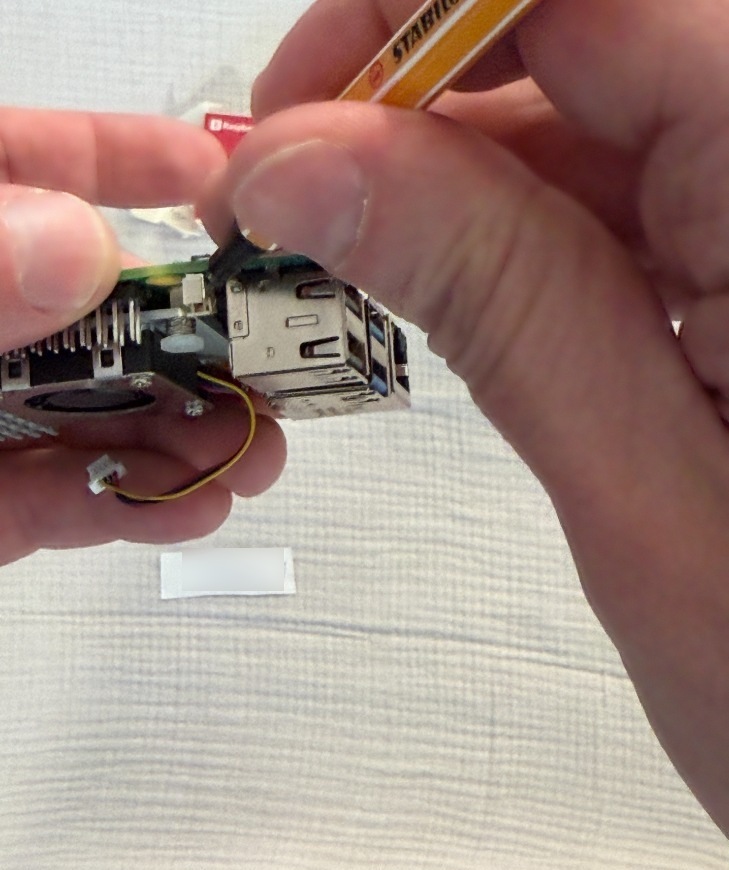
docs/images/real_build/stage1_07c_prying_j11_dust_cap.jpg
