arctic-trail/karhunkierros-sar-drone/docs/images/real_build/stage1_07d_j11_cap_removed_socket_open.jpg

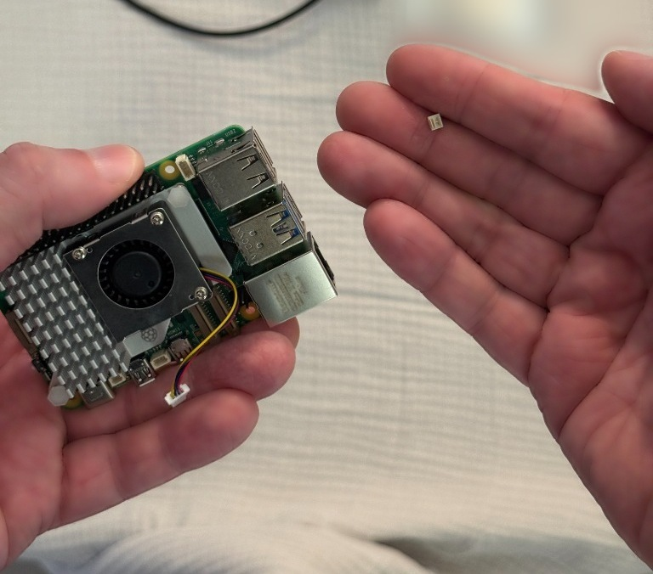
docs/images/real_build/stage1_07d_j11_cap_removed_socket_open.jpg
