arctic-trail/karhunkierros-sar-drone/docs/images/real_build/stage1_07e_fan_cable_plugged_into_j11.jpg

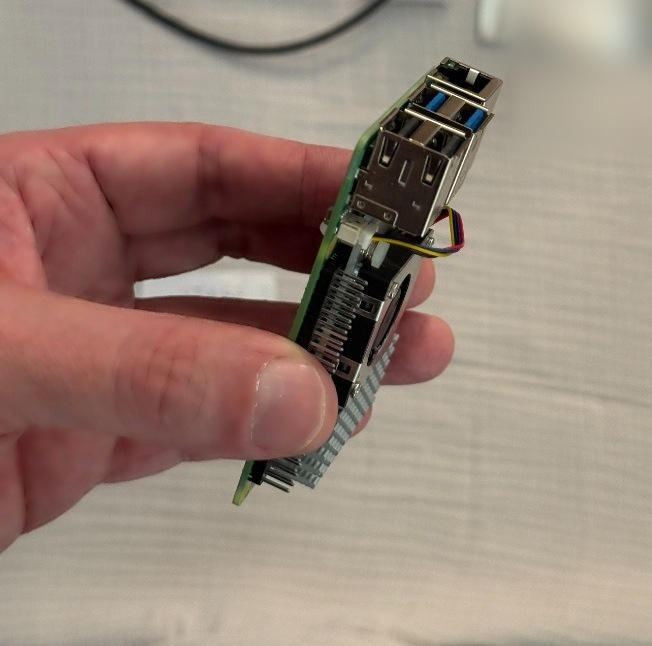
docs/images/real_build/stage1_07e_fan_cable_plugged_into_j11.jpg
