arctic-trail/karhunkierros-sar-drone/docs/images/real_build/stage1_08_pico2_micro_usb_alignment.jpg

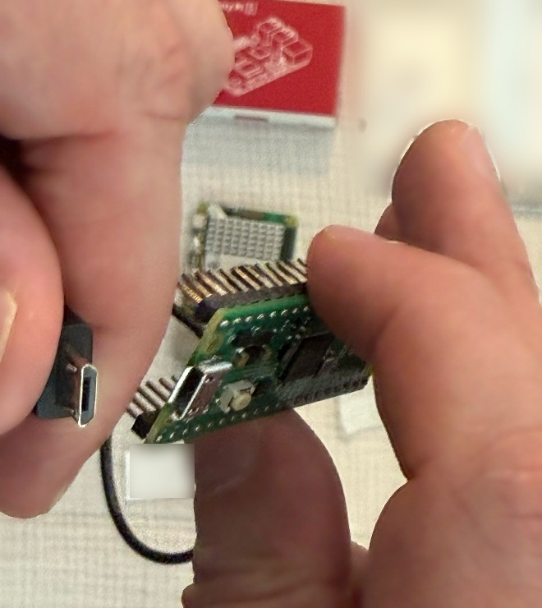
docs/images/real_build/stage1_08_pico2_micro_usb_alignment.jpg
