arctic-trail/karhunkierros-sar-drone/docs/images/real_build/stage1_09_pico2_top_bootsel_view.jpg

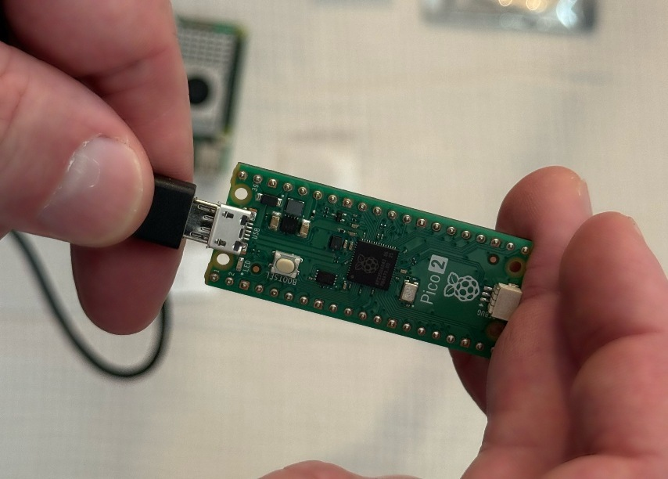
docs/images/real_build/stage1_09_pico2_top_bootsel_view.jpg
