arctic-trail/karhunkierros-sar-drone/docs/images/real_build/stage1_10_pico2_40pin_header_profile_closeup.jpg

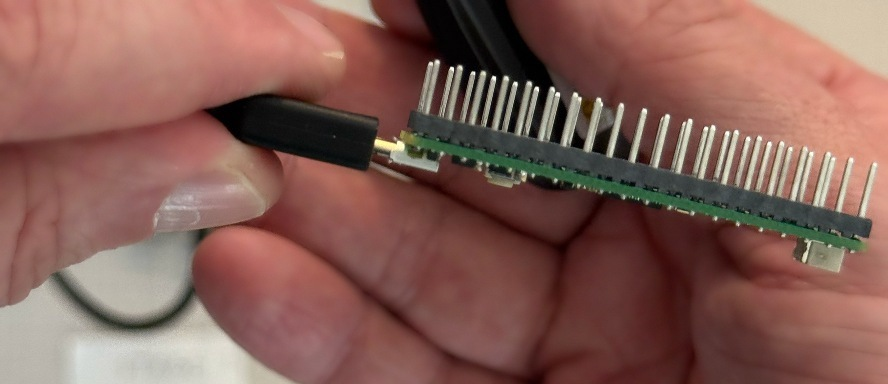
docs/images/real_build/stage1_10_pico2_40pin_header_profile_closeup.jpg
