arctic-trail/karhunkierros-sar-drone/docs/images/real_build/stage1_11_pico2_side_profile_over_stage1_bench.jpg

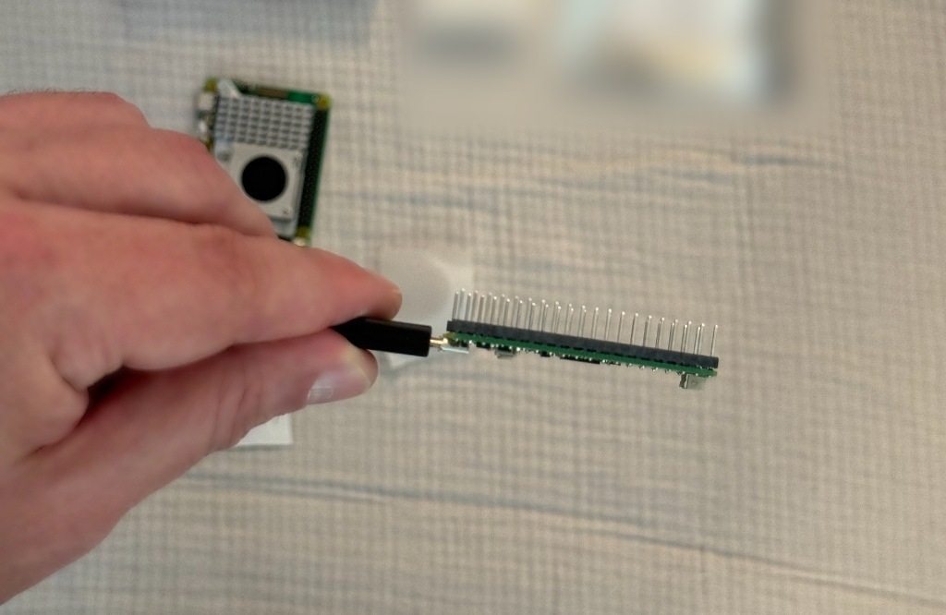
docs/images/real_build/stage1_11_pico2_side_profile_over_stage1_bench.jpg
