arctic-trail/karhunkierros-sar-drone/docs/images/real_build/stage1_12_micro_usb_to_usb_a_cord_both_ends.jpg

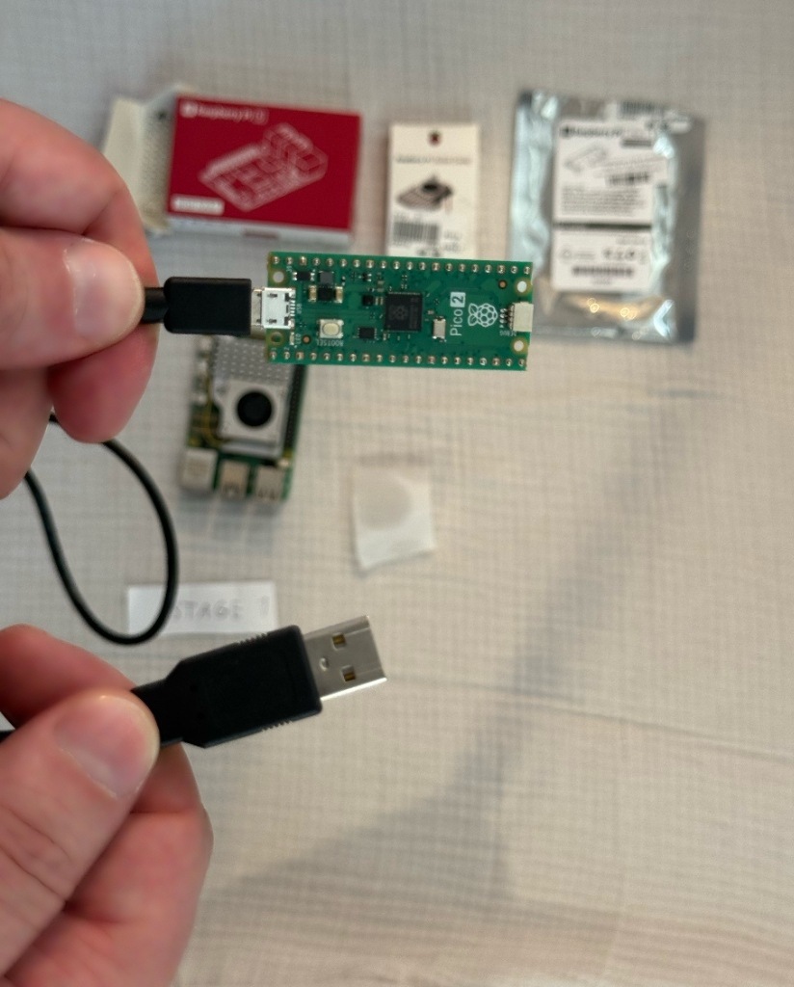
docs/images/real_build/stage1_12_micro_usb_to_usb_a_cord_both_ends.jpg
