arctic-trail/karhunkierros-sar-drone/docs/images/real_build/stage1_13_usb_c_adapter_in_macbook_pro.jpg

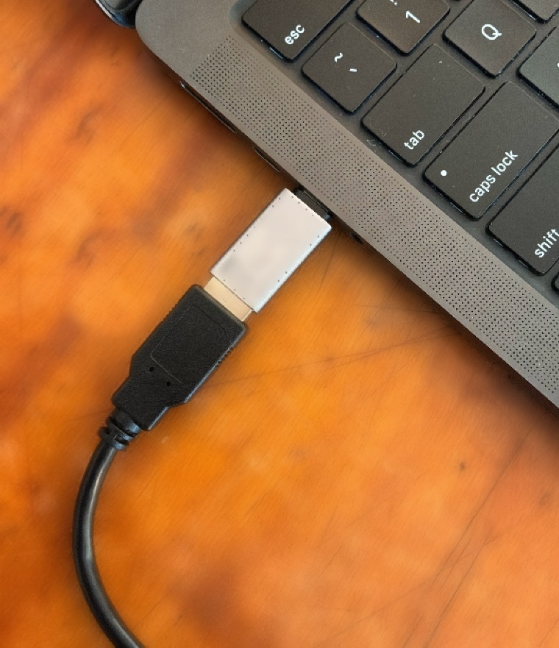
docs/images/real_build/stage1_13_usb_c_adapter_in_macbook_pro.jpg
