arctic-trail/karhunkierros-sar-drone/docs/images/real_build/stage1_14_pressing_bootsel_button.jpg

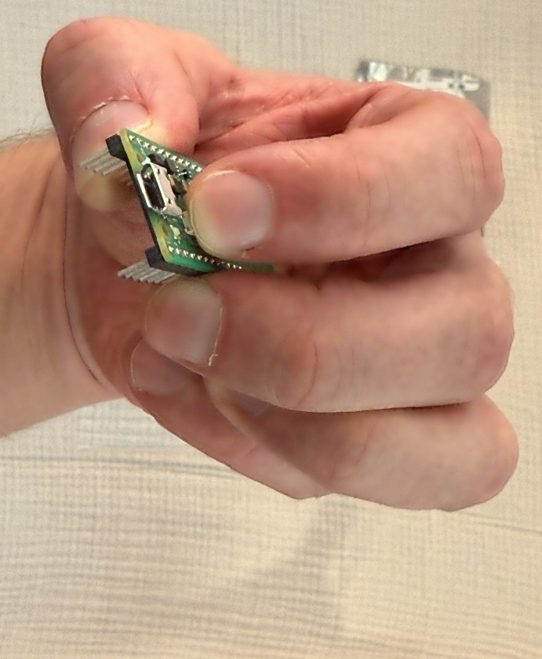
docs/images/real_build/stage1_14_pressing_bootsel_button.jpg
