arctic-trail/karhunkierros-sar-drone/docs/images/real_build/stage1_15_plugging_cord_while_holding_bootsel.jpg

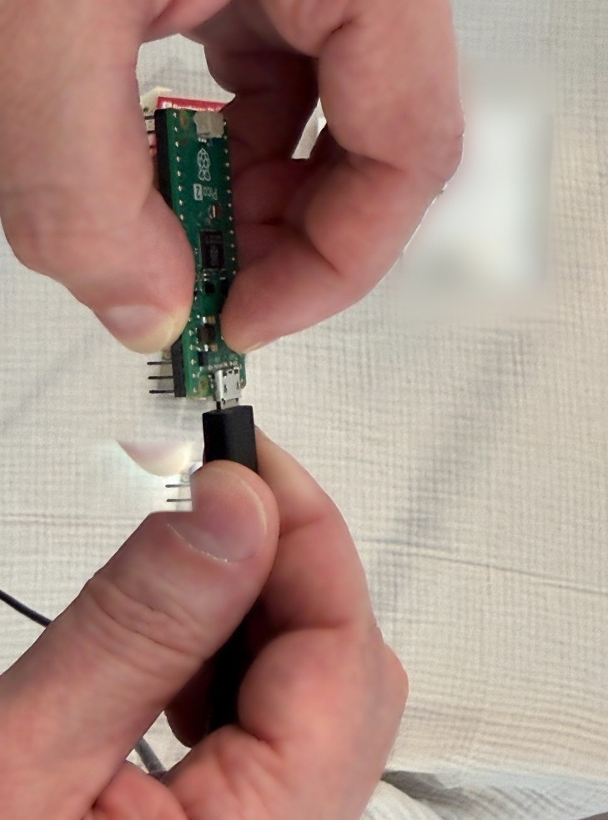
docs/images/real_build/stage1_15_plugging_cord_while_holding_bootsel.jpg
