arctic-trail/karhunkierros-sar-drone/docs/images/real_build/stage2_01_empty_breadboard_30rows.jpg

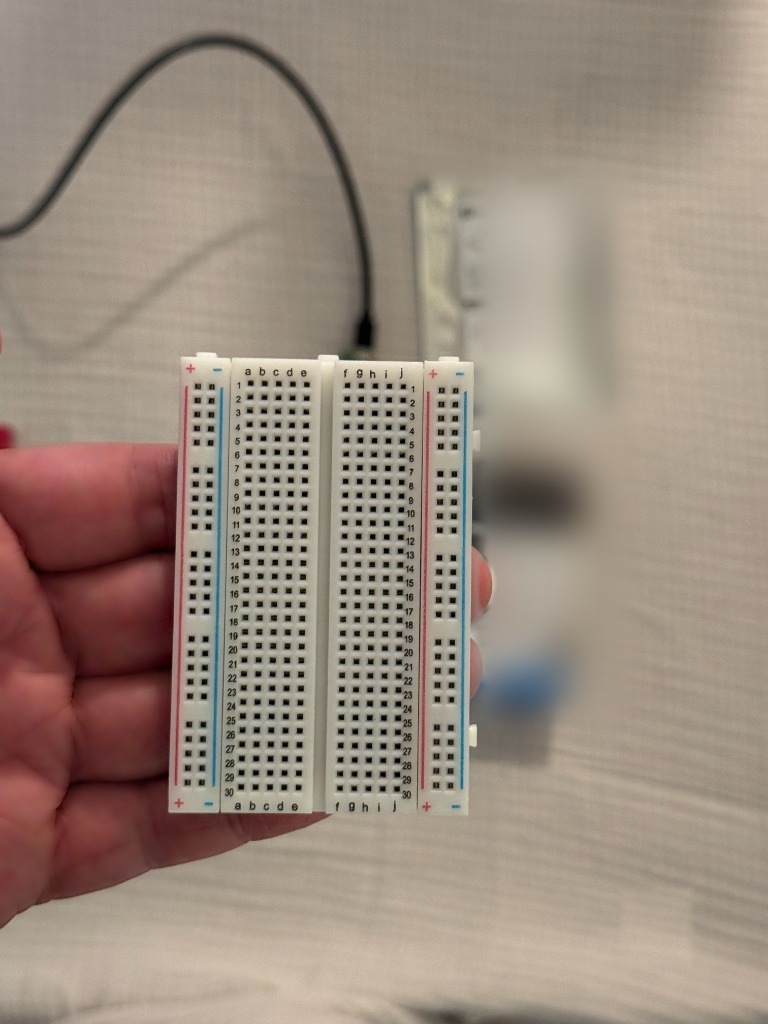
docs/images/real_build/stage2_01_empty_breadboard_30rows.jpg
