arctic-trail/karhunkierros-sar-drone/docs/images/real_build/stage2_02_pico2_top_alignment_rows1_to_20.jpg

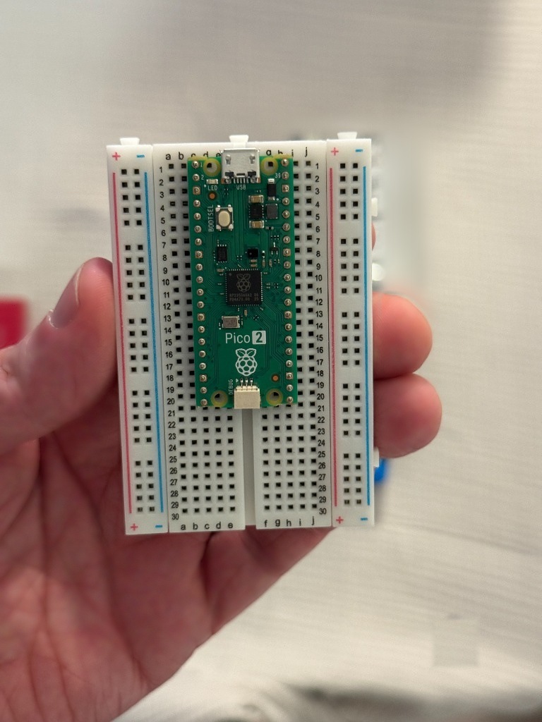
docs/images/real_build/stage2_02_pico2_top_alignment_rows1_to_20.jpg
