arctic-trail/karhunkierros-sar-drone/docs/images/real_build/stage2_03_pico2_angled_seated_in_breadboard.jpg

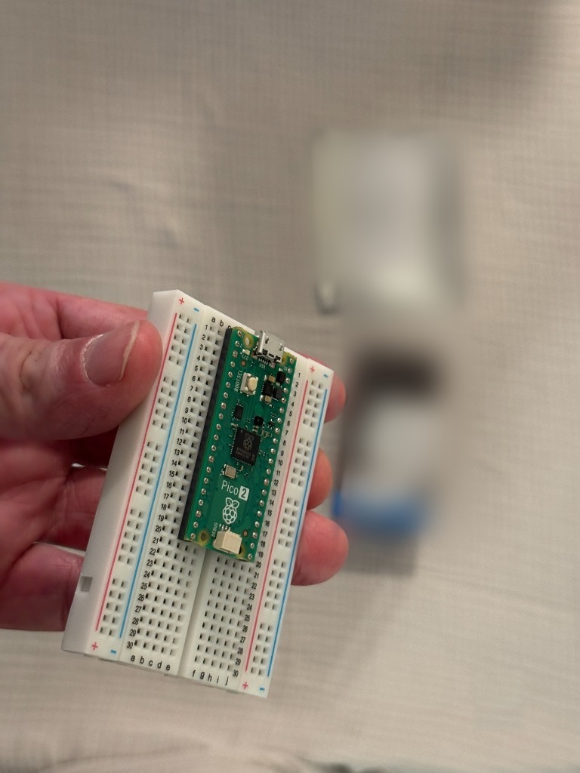
docs/images/real_build/stage2_03_pico2_angled_seated_in_breadboard.jpg
