arctic-trail/karhunkierros-sar-drone/docs/images/real_build/stage2_04_pico2_side_profile_flush_on_breadboard.jpg

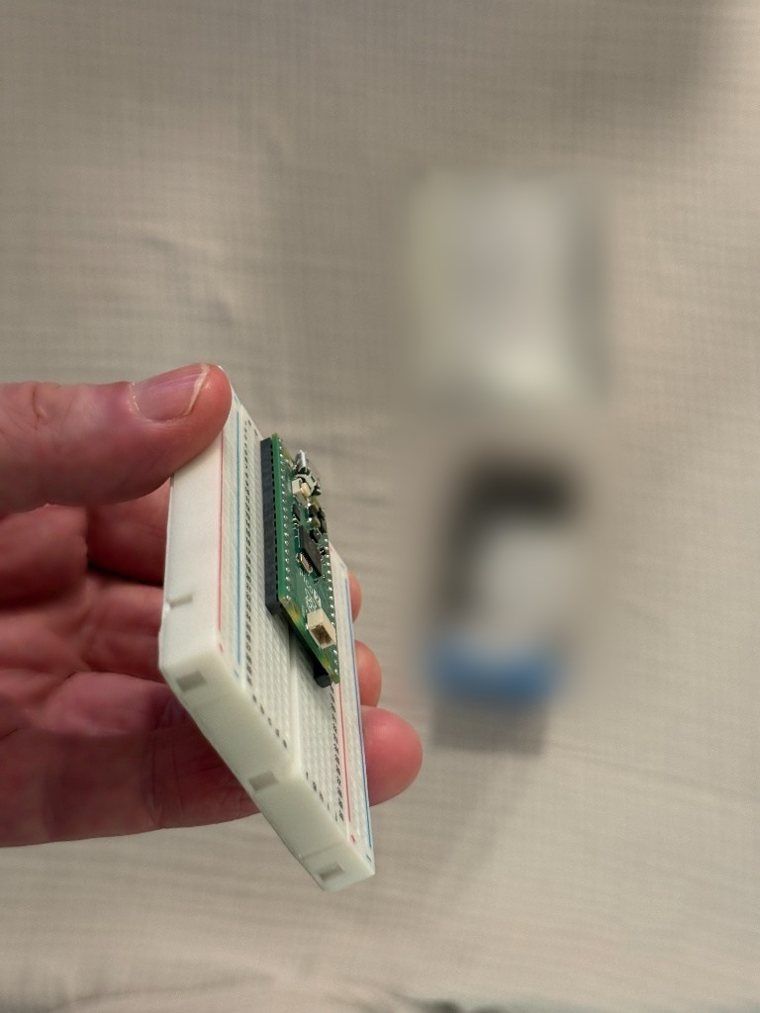
docs/images/real_build/stage2_04_pico2_side_profile_flush_on_breadboard.jpg
