arctic-trail/karhunkierros-sar-drone/docs/images/real_build/stage2_05b_unboxed_qmc5883l_gy271_sensor.jpg

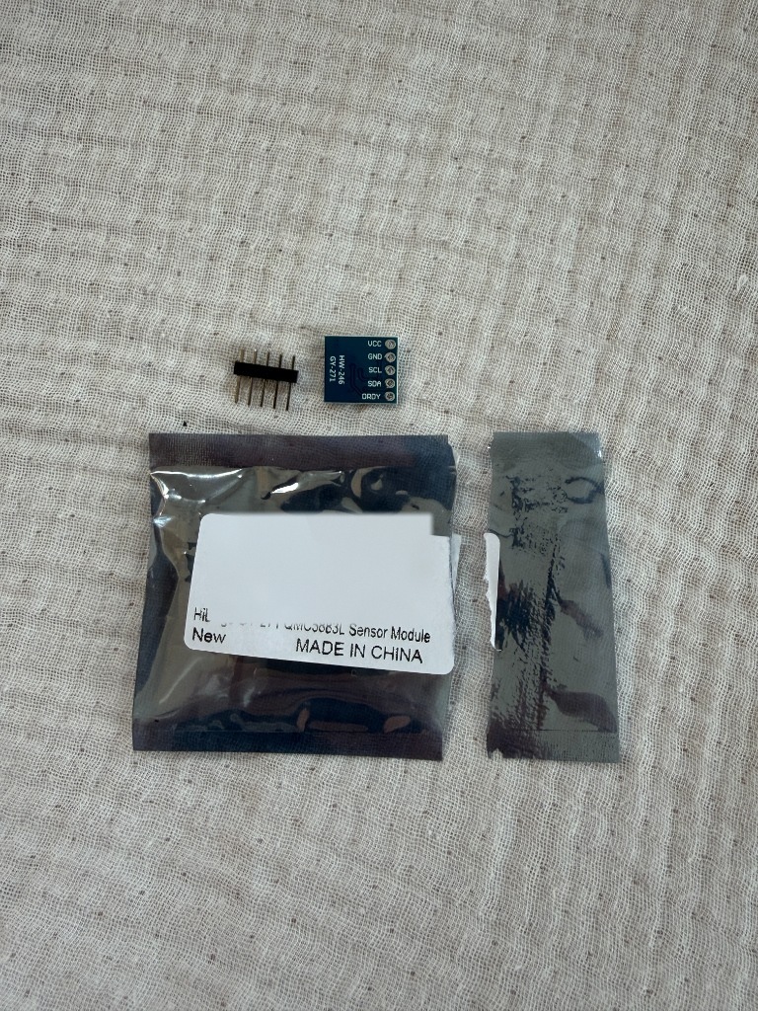
docs/images/real_build/stage2_05b_unboxed_qmc5883l_gy271_sensor.jpg
