arctic-trail/karhunkierros-sar-drone/docs/images/real_build/stage2_06_topdown_breadboard_pico2_next_to_pi5.jpg

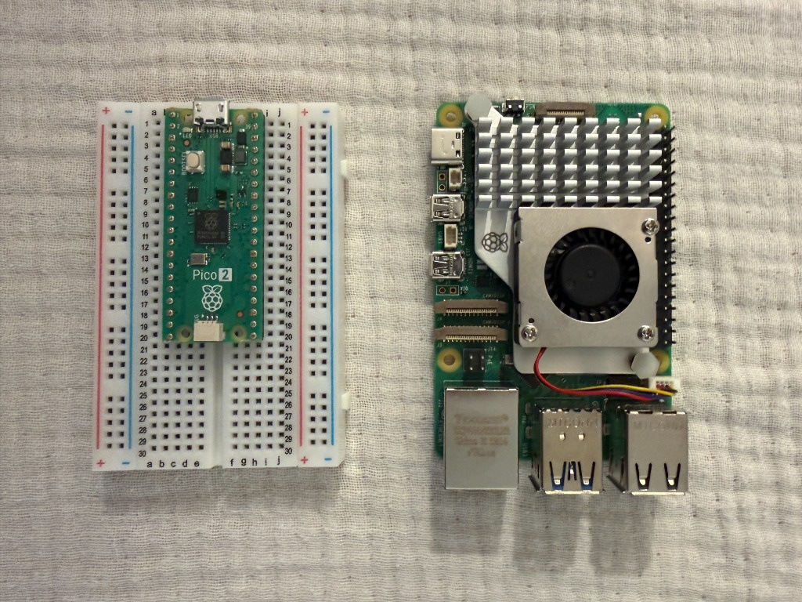
docs/images/real_build/stage2_06_topdown_breadboard_pico2_next_to_pi5.jpg
