arctic-trail/karhunkierros-sar-drone/docs/images/real_build/stage2_07_micro_usb_cord_connected_to_breadboard_pico2.jpg

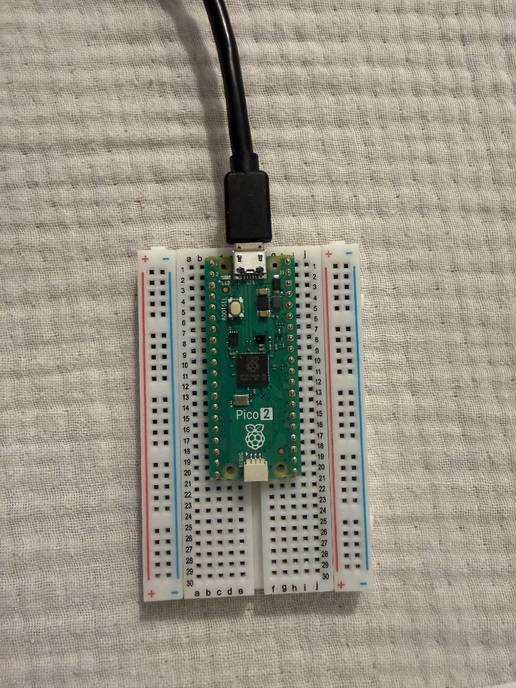
docs/images/real_build/stage2_07_micro_usb_cord_connected_to_breadboard_pico2.jpg
