arctic-trail/karhunkierros-sar-drone/docs/images/real_build/stage2_08_sandisk_64gb_microsd_and_adapter.jpg

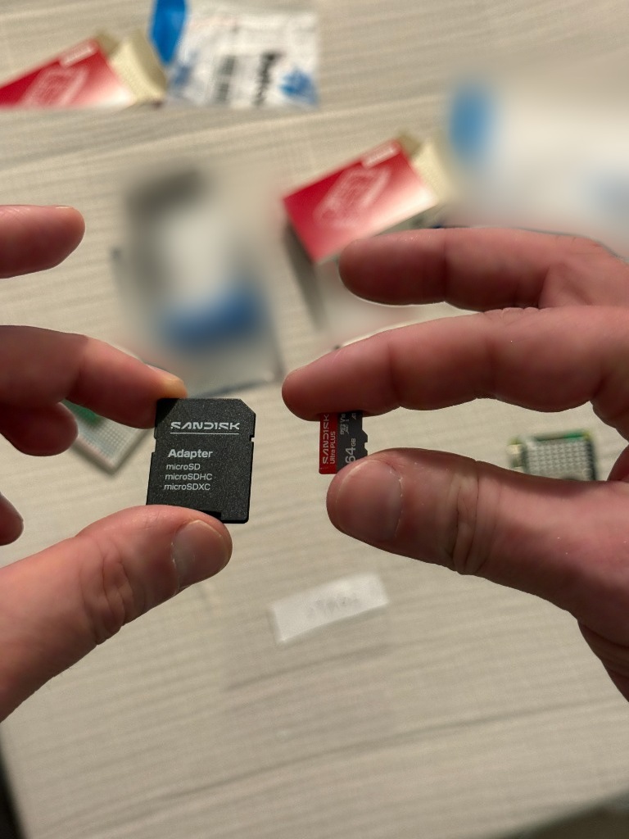
docs/images/real_build/stage2_08_sandisk_64gb_microsd_and_adapter.jpg
