arctic-trail/karhunkierros-sar-drone/docs/images/real_build/stage2_09_sliding_microsd_into_adapter.jpg

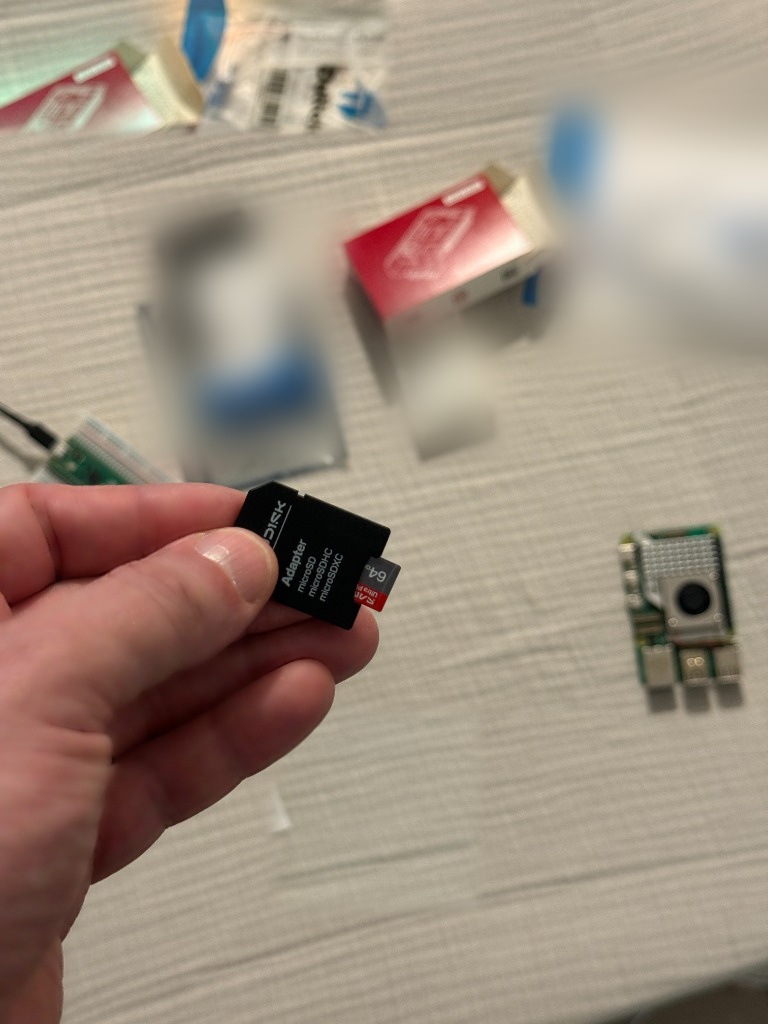
docs/images/real_build/stage2_09_sliding_microsd_into_adapter.jpg
