arctic-trail/karhunkierros-sar-drone/docs/images/real_build/stage2_10_microsd_seated_flush_in_adapter.jpg

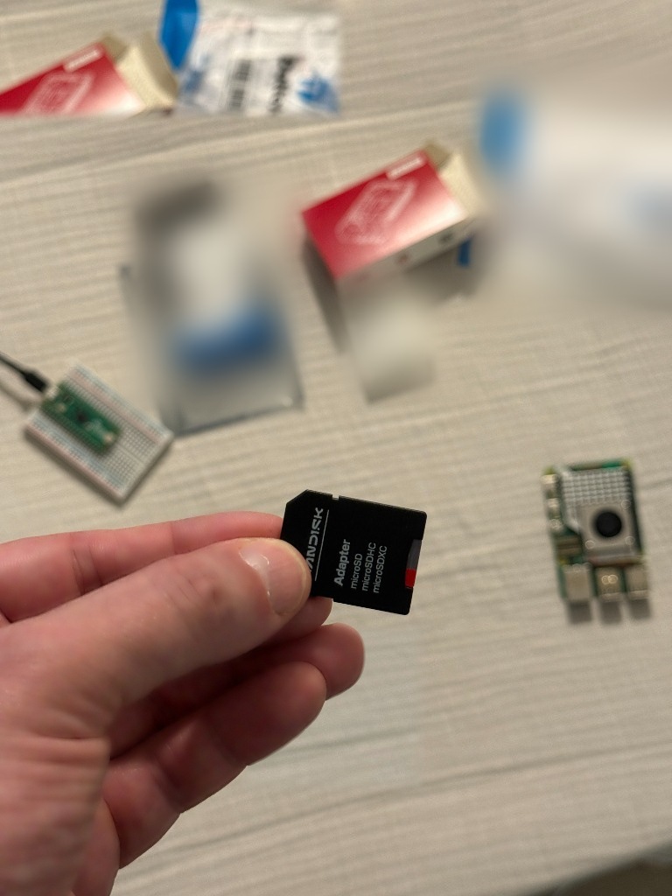
docs/images/real_build/stage2_10_microsd_seated_flush_in_adapter.jpg
