arctic-trail/karhunkierros-sar-drone/docs/images/real_build/stage2_11_sd_adapter_in_macbook_pro_slot.jpg

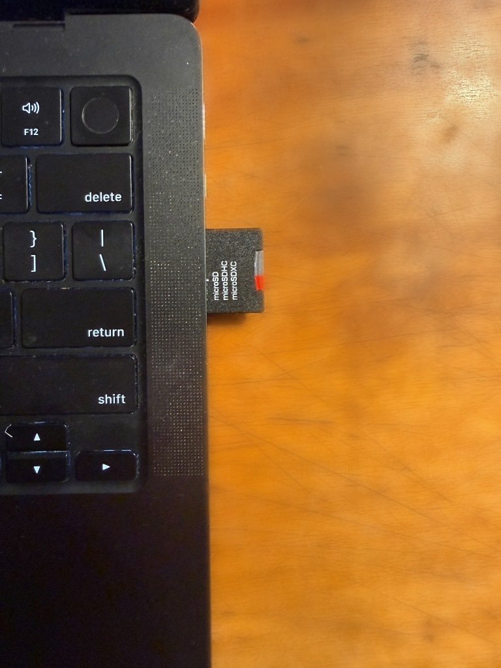
docs/images/real_build/stage2_11_sd_adapter_in_macbook_pro_slot.jpg
