arctic-trail/karhunkierros-sar-drone/docs/images/real_build/stage2_12_sliding_microsd_into_pi5_underside_slot.jpg

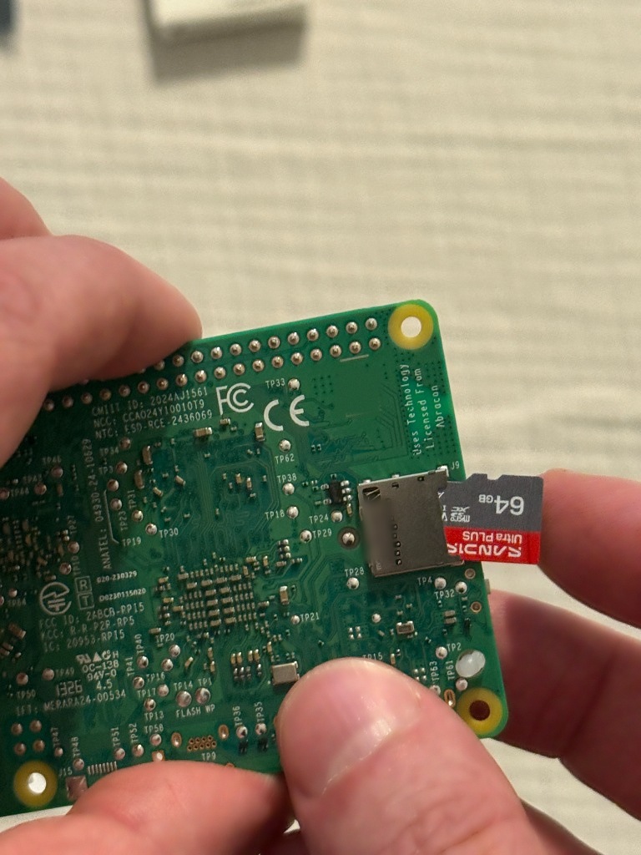
docs/images/real_build/stage2_12_sliding_microsd_into_pi5_underside_slot.jpg
