arctic-trail/karhunkierros-sar-drone/docs/images/real_build/stage2_13_microsd_seated_flush_in_pi5_underside_slot.jpg

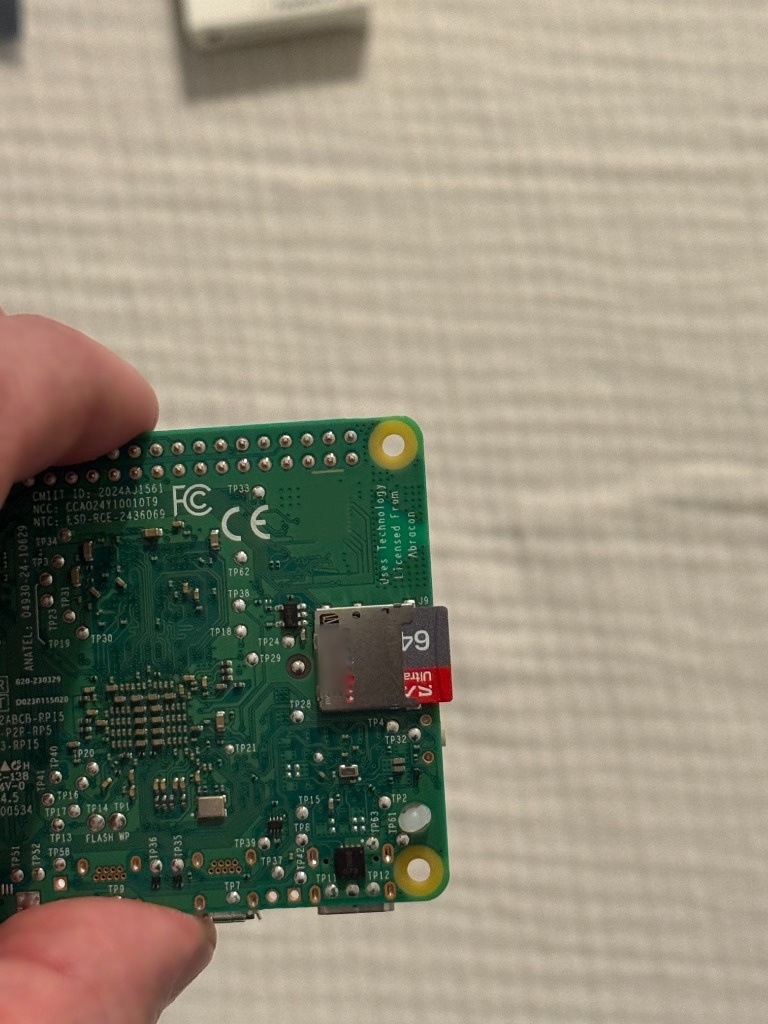
docs/images/real_build/stage2_13_microsd_seated_flush_in_pi5_underside_slot.jpg
