arctic-trail/karhunkierros-sar-drone/docs/images/real_build/stage2_14_elegoo_jumpers_flatlay.jpg

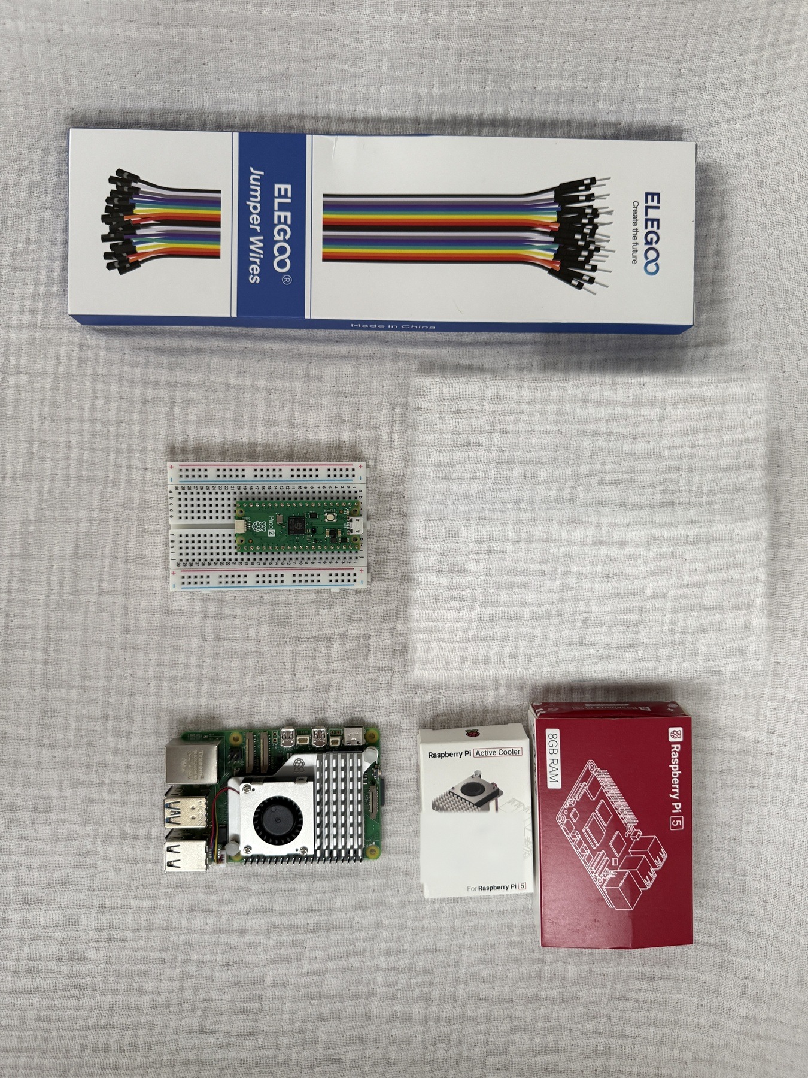
docs/images/real_build/stage2_14_elegoo_jumpers_flatlay.jpg
