arctic-trail/karhunkierros-sar-drone/docs/images/real_build/stage2_15_unpacked_40wire_jumper_ribbon.jpg

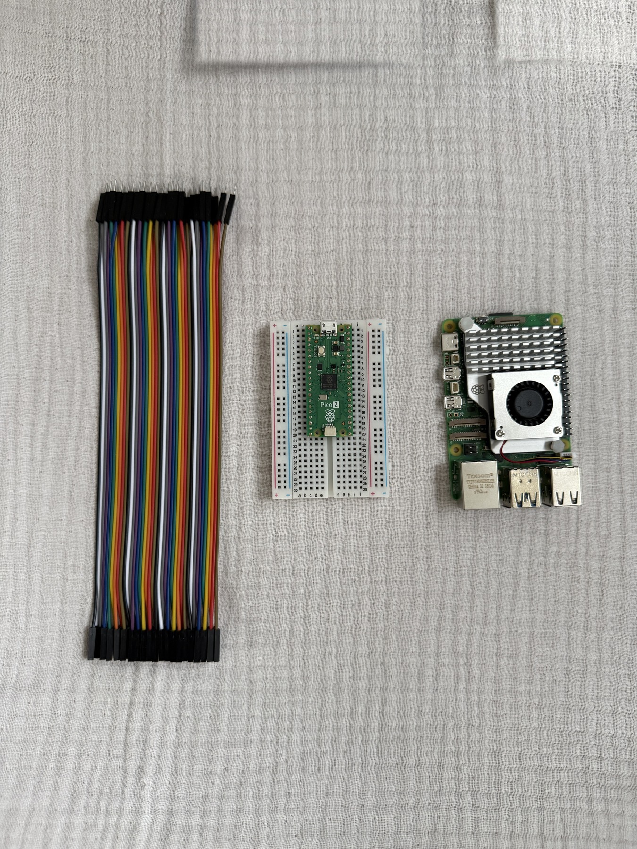
docs/images/real_build/stage2_15_unpacked_40wire_jumper_ribbon.jpg
