arctic-trail/karhunkierros-sar-drone/docs/images/real_build/stage2_16_4_male_male_and_3_male_female_wires_selected.jpg

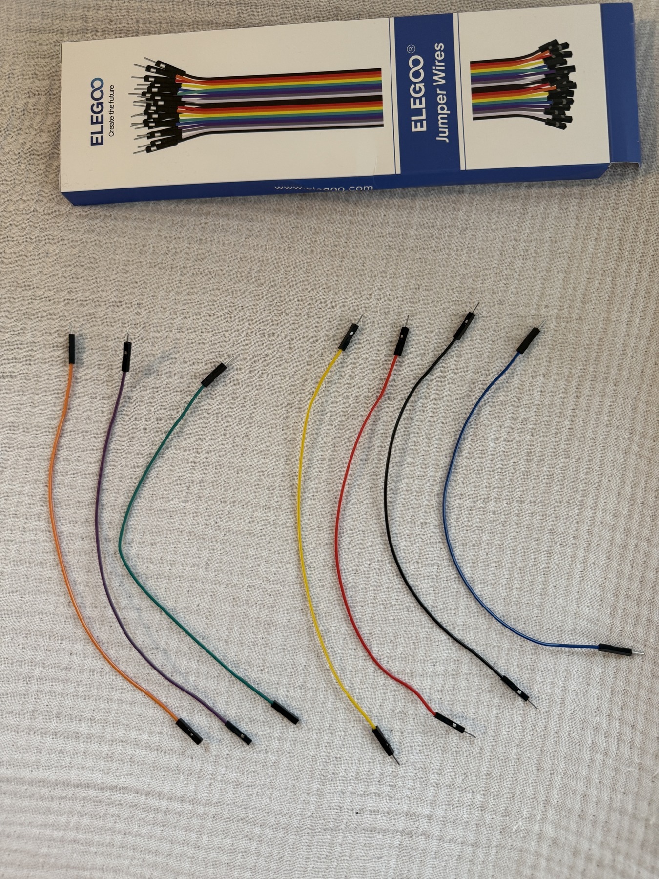
docs/images/real_build/stage2_16_4_male_male_and_3_male_female_wires_selected.jpg
