arctic-trail/karhunkierros-sar-drone/docs/images/real_build/stage2_17_unboxed_gy271_compass_and_5pin_header.jpg

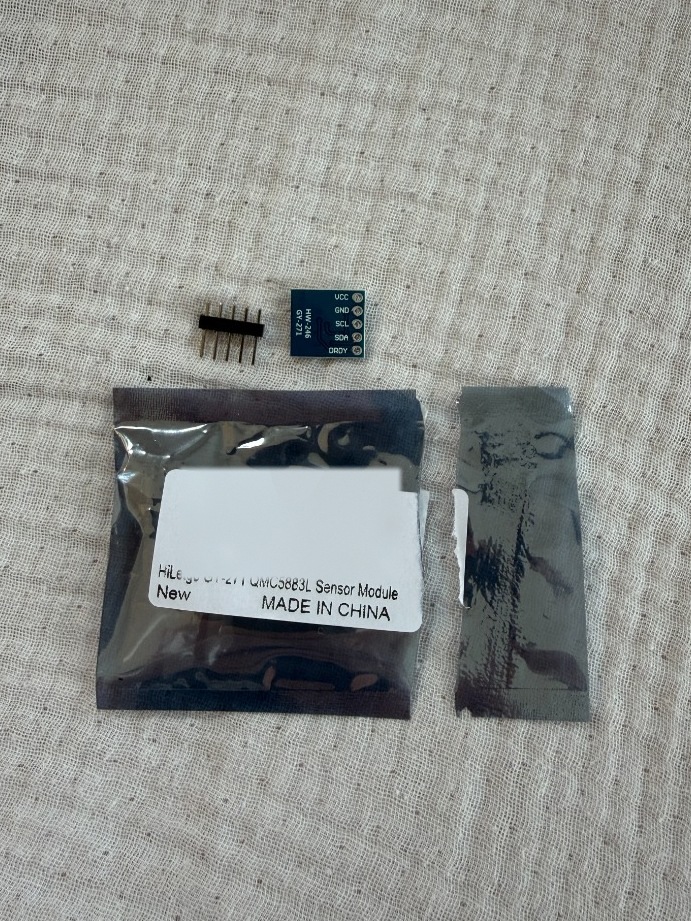
docs/images/real_build/stage2_17_unboxed_gy271_compass_and_5pin_header.jpg
