arctic-trail/karhunkierros-sar-drone/docs/images/real_build/stage2_18_straightening_jumper_pin_with_pliers.jpg

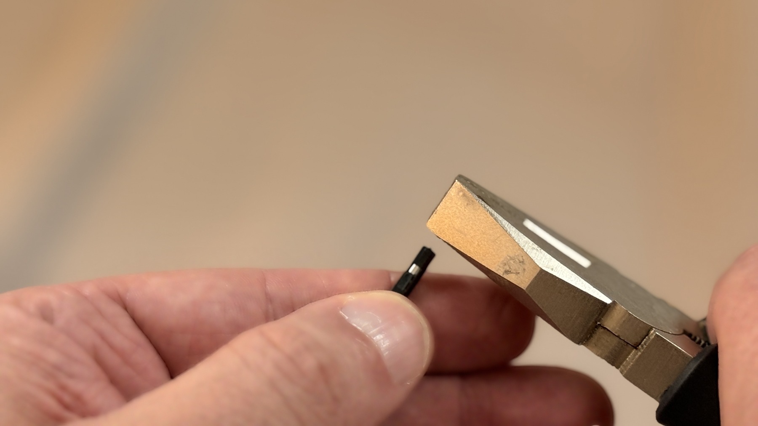
docs/images/real_build/stage2_18_straightening_jumper_pin_with_pliers.jpg
