arctic-trail/karhunkierros-sar-drone/docs/images/real_build/stage2_19_w1_to_w4_wired_on_breadboard_top_view.jpg

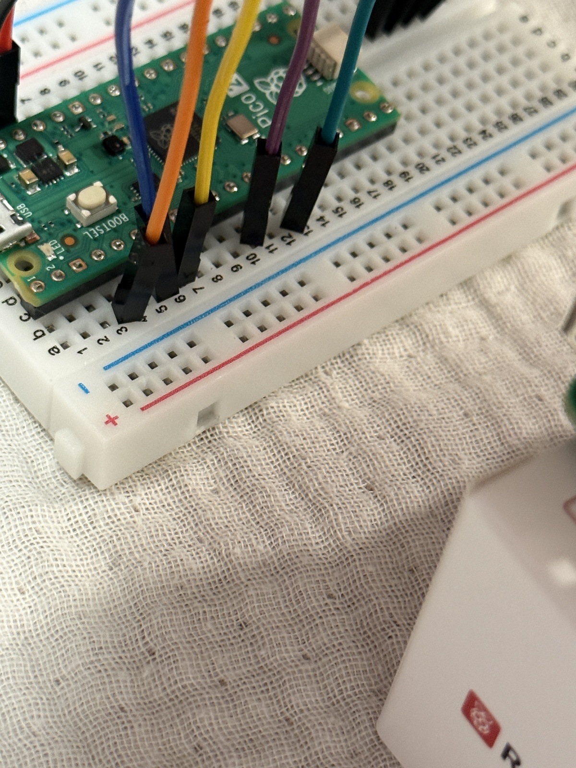
docs/images/real_build/stage2_19_w1_to_w4_wired_on_breadboard_top_view.jpg
