arctic-trail/karhunkierros-sar-drone/docs/images/real_build/stage2_20_all_7_wires_on_breadboard_rows_visible.jpg

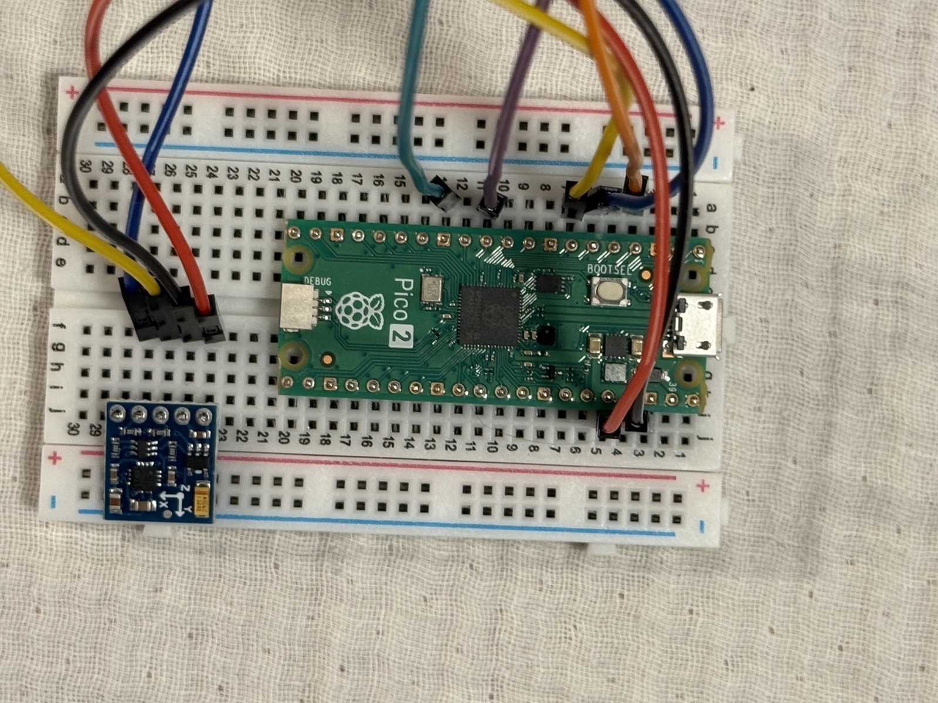
docs/images/real_build/stage2_20_all_7_wires_on_breadboard_rows_visible.jpg
