arctic-trail/karhunkierros-sar-drone/docs/images/real_build/stage2_21_holding_5pin_header_short_up_long_down.jpg

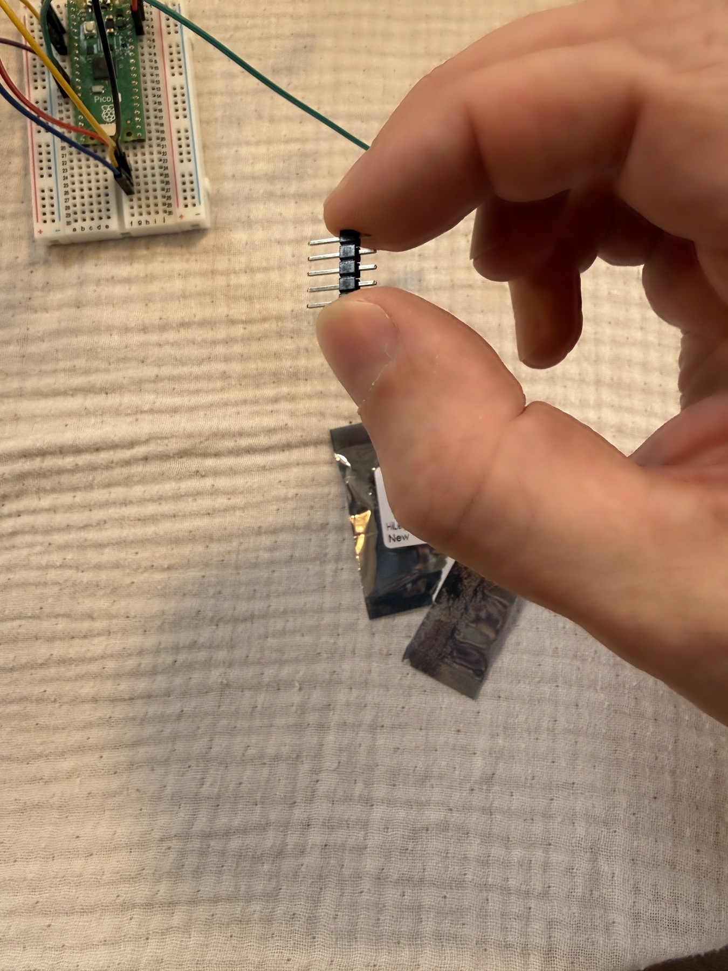
docs/images/real_build/stage2_21_holding_5pin_header_short_up_long_down.jpg
