arctic-trail/karhunkierros-sar-drone/docs/images/real_build/stage2_22_pliers_zigzag_bend_for_snug_unsoldered_fit.jpg

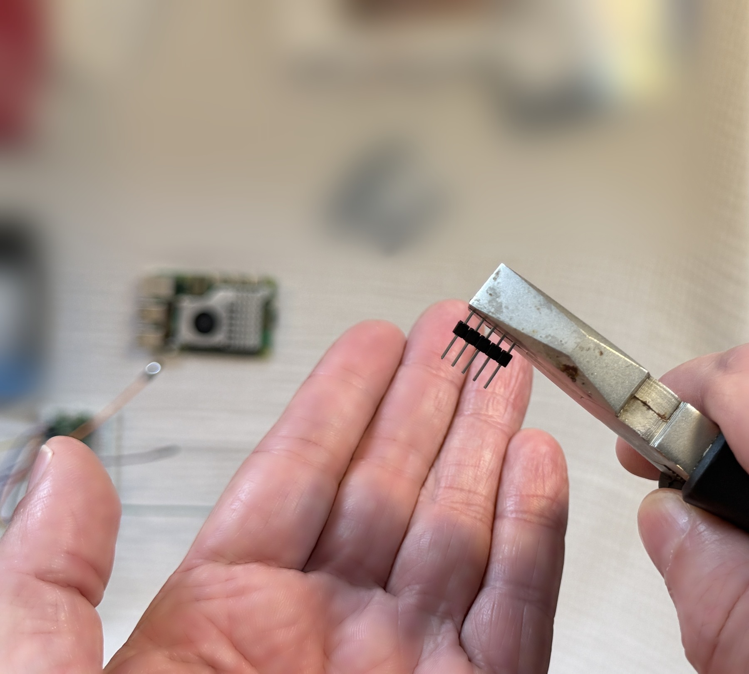
docs/images/real_build/stage2_22_pliers_zigzag_bend_for_snug_unsoldered_fit.jpg
