arctic-trail/karhunkierros-sar-drone/docs/images/real_build/stage2_23_gy271_slid_onto_5pin_header.jpg

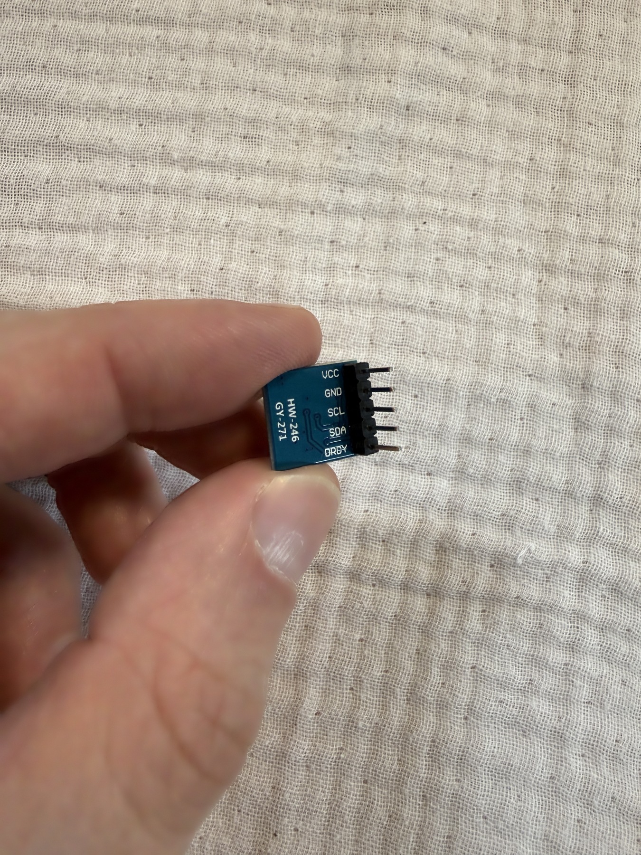
docs/images/real_build/stage2_23_gy271_slid_onto_5pin_header.jpg
