arctic-trail/karhunkierros-sar-drone/docs/images/real_build/stage2_24_w1_to_w4_in_col_f_and_5pin_strip_in_col_j.jpg

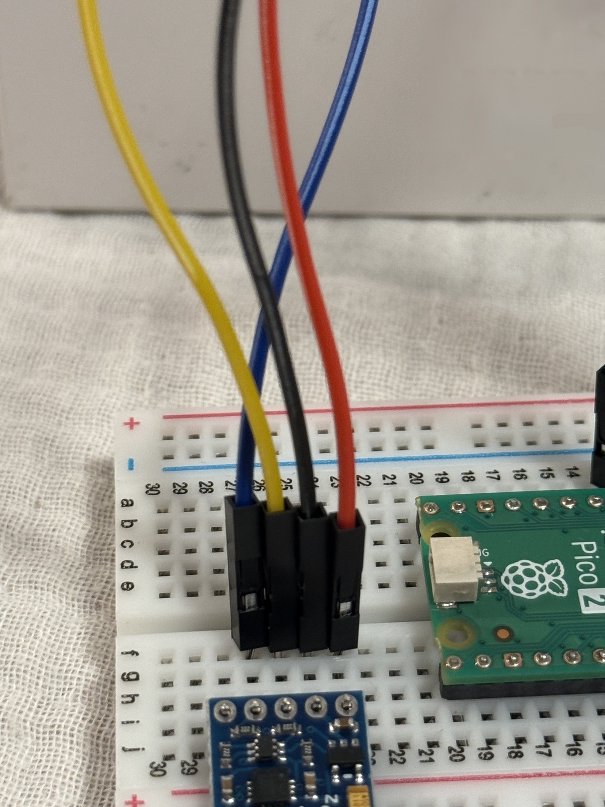
docs/images/real_build/stage2_24_w1_to_w4_in_col_f_and_5pin_strip_in_col_j.jpg
