arctic-trail/karhunkierros-sar-drone/docs/images/real_build/stage2_25_completed_breadboard_with_gy271_in_col_j_facing_right.jpg

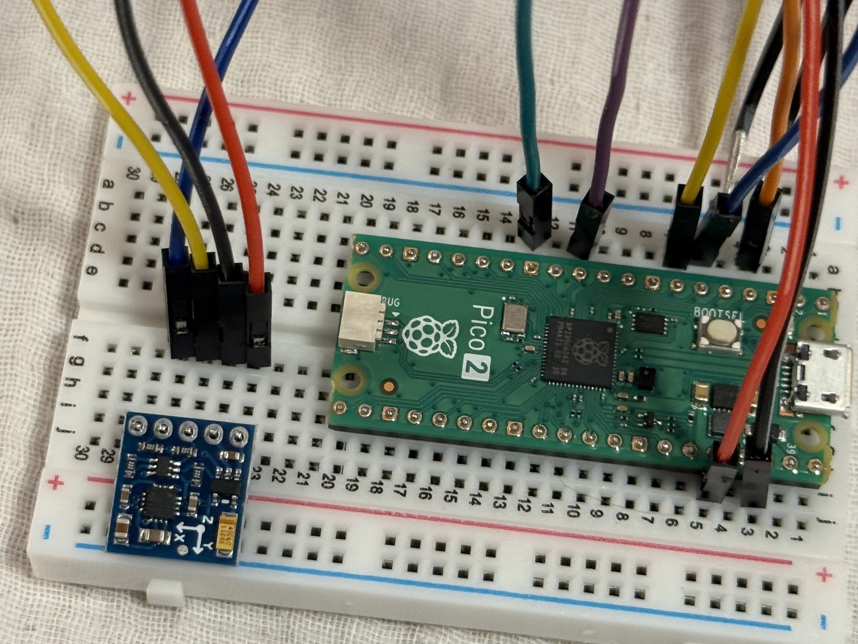
docs/images/real_build/stage2_25_completed_breadboard_with_gy271_in_col_j_facing_right.jpg
