arctic-trail/karhunkierros-sar-drone/docs/images/real_build/stage2_28_pi5_gpio_and_cam_disp0_top_view.jpg

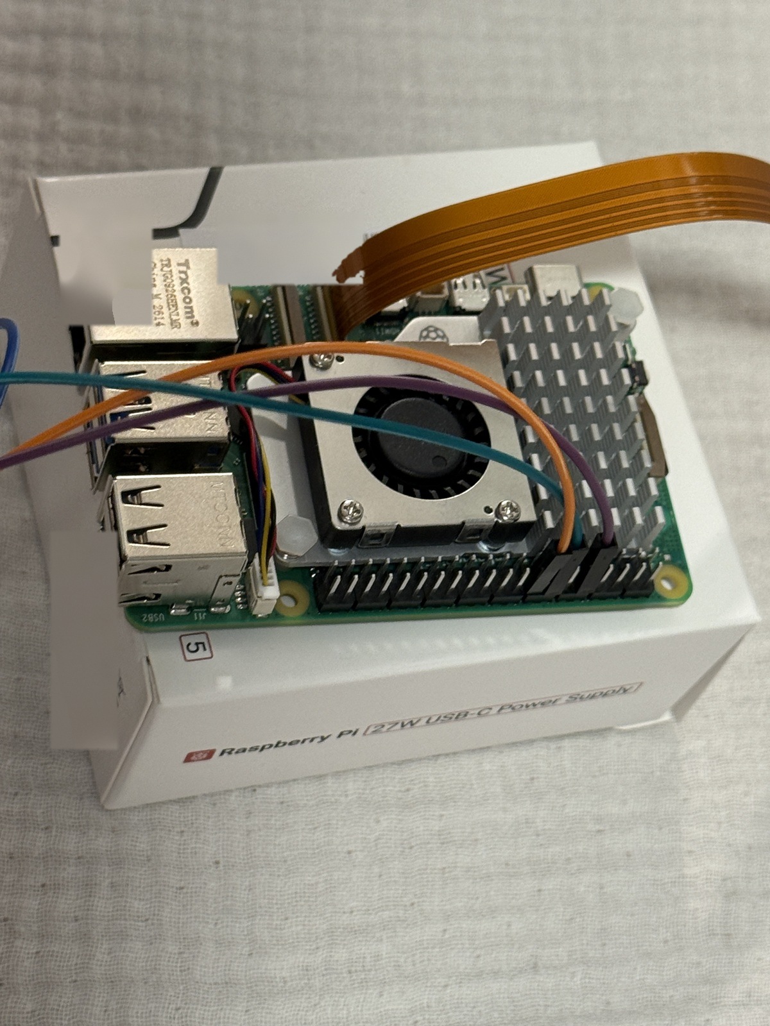
docs/images/real_build/stage2_28_pi5_gpio_and_cam_disp0_top_view.jpg
