arctic-trail/karhunkierros-sar-drone/docs/images/real_build/stage2_29_completed_stage2_3_full_assembly_golden.jpg

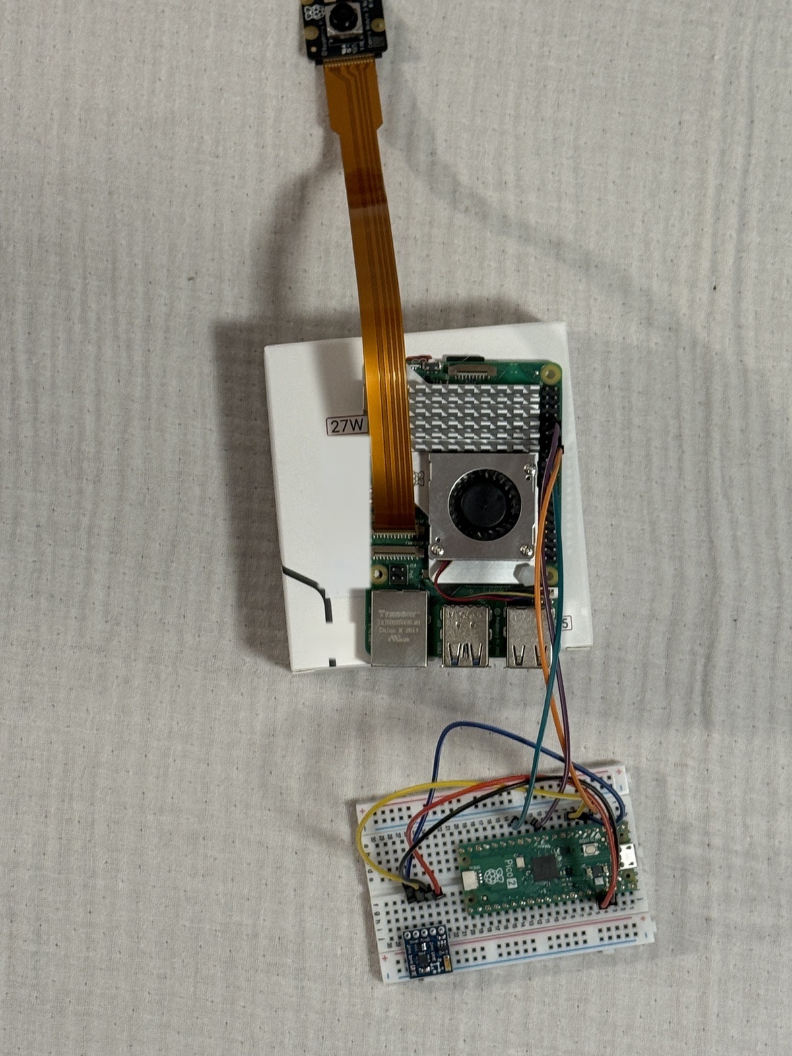
docs/images/real_build/stage2_29_completed_stage2_3_full_assembly_golden.jpg
