arctic-trail/karhunkierros-sar-drone/docs/images/real_build/stage2_30a_three_white_boxes_golden.jpg

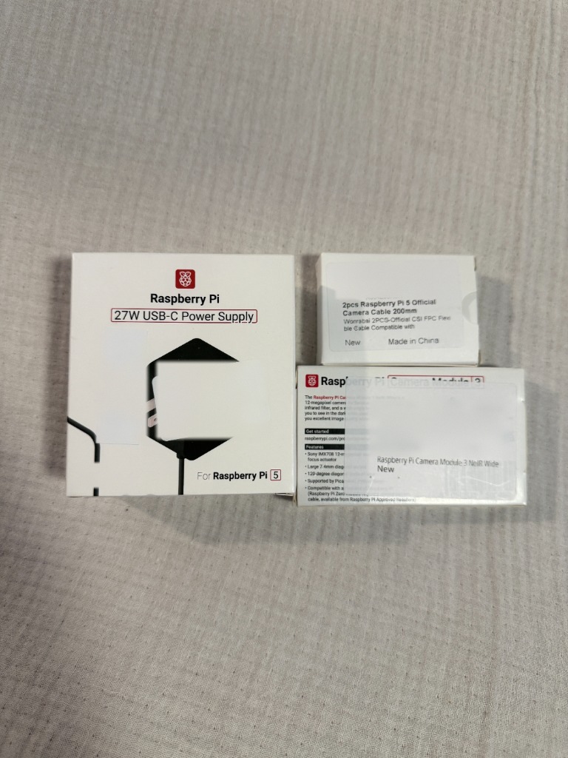
docs/images/real_build/stage2_30a_three_white_boxes_golden.jpg
