arctic-trail/karhunkierros-sar-drone/docs/images/real_build/stage2_31_unboxed_raspberry_pi5_camera_ribbon_cable.jpg

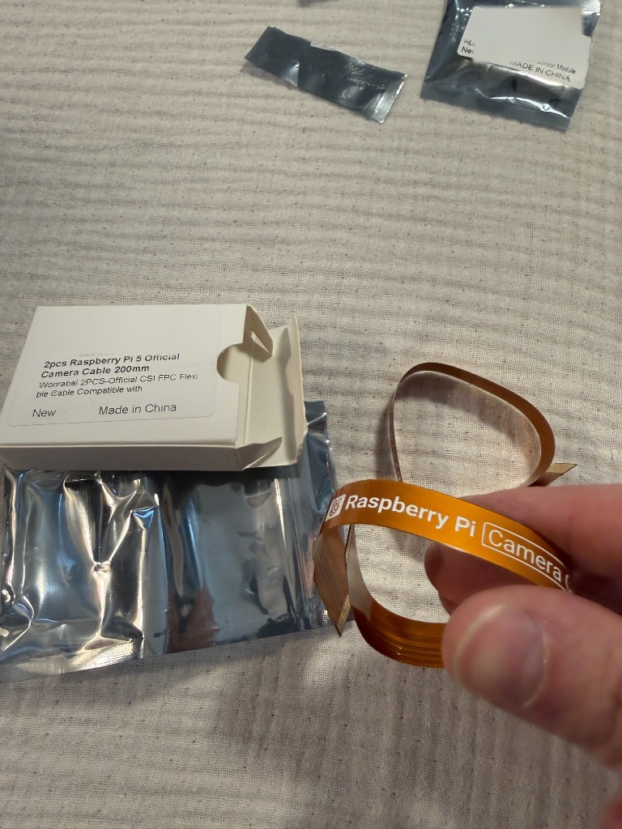
docs/images/real_build/stage2_31_unboxed_raspberry_pi5_camera_ribbon_cable.jpg
