arctic-trail/karhunkierros-sar-drone/docs/images/real_build/stage2_32_flat_camera_ribbon_wide_vs_narrow_ends.jpg

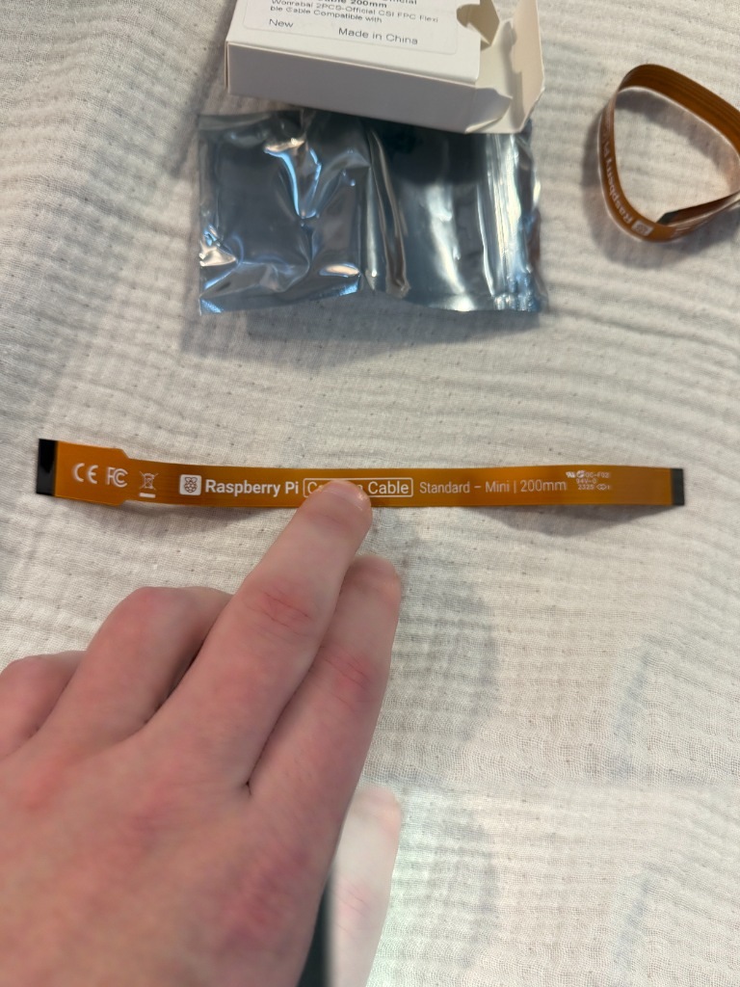
docs/images/real_build/stage2_32_flat_camera_ribbon_wide_vs_narrow_ends.jpg
