arctic-trail/karhunkierros-sar-drone/docs/images/real_build/stage2_33_flat_camera_ribbon_gold_teeth_side.jpg

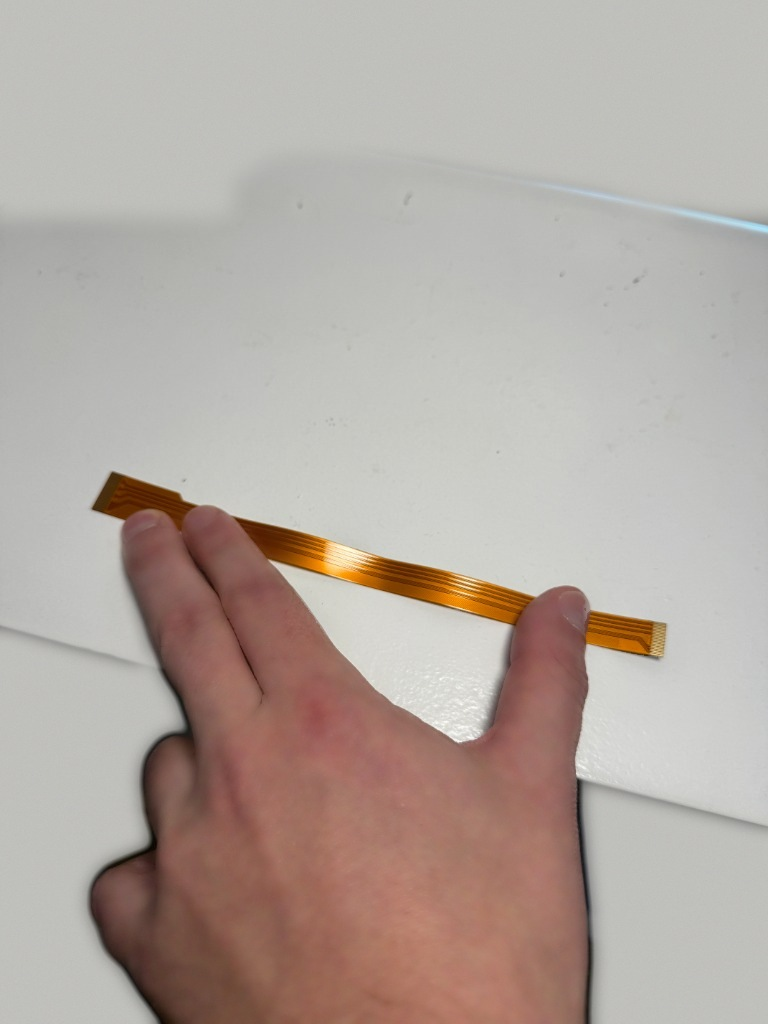
docs/images/real_build/stage2_33_flat_camera_ribbon_gold_teeth_side.jpg
