arctic-trail/karhunkierros-sar-drone/docs/images/real_build/stage2_34_pi5_j4_ribbon_seated_and_locked.jpg

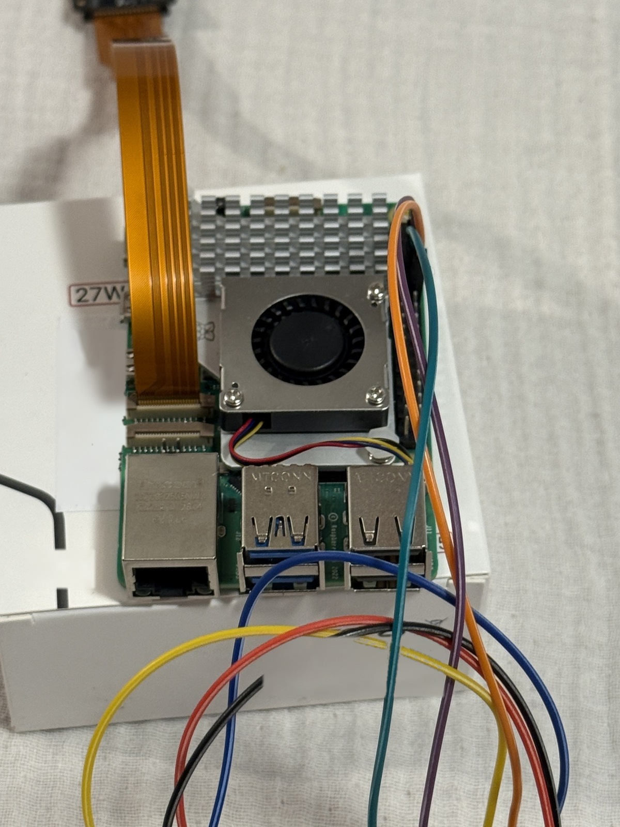
docs/images/real_build/stage2_34_pi5_j4_ribbon_seated_and_locked.jpg
