arctic-trail/karhunkierros-sar-drone/docs/images/real_build/stage2_35_camera_module3_factory_white_ribbon.jpg

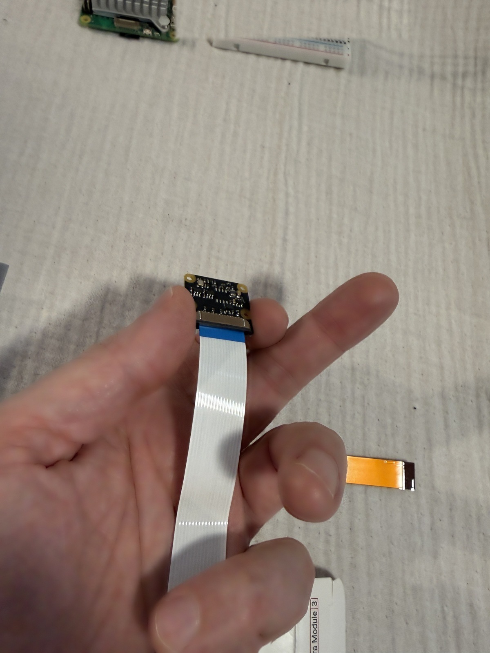
docs/images/real_build/stage2_35_camera_module3_factory_white_ribbon.jpg
