arctic-trail/karhunkierros-sar-drone/docs/images/real_build/stage2_36_camera_module3_white_ribbon_removed.jpg

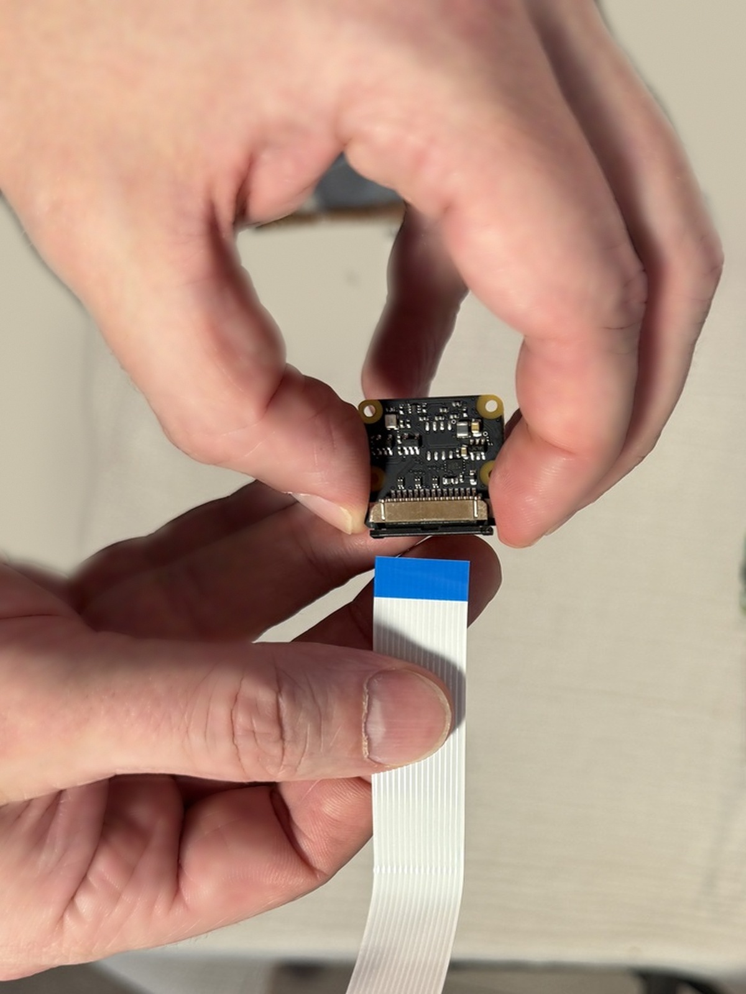
docs/images/real_build/stage2_36_camera_module3_white_ribbon_removed.jpg
