arctic-trail/karhunkierros-sar-drone/docs/images/real_build/stage2_37_camera_module3_orange_ribbon_seated_and_locked.jpg

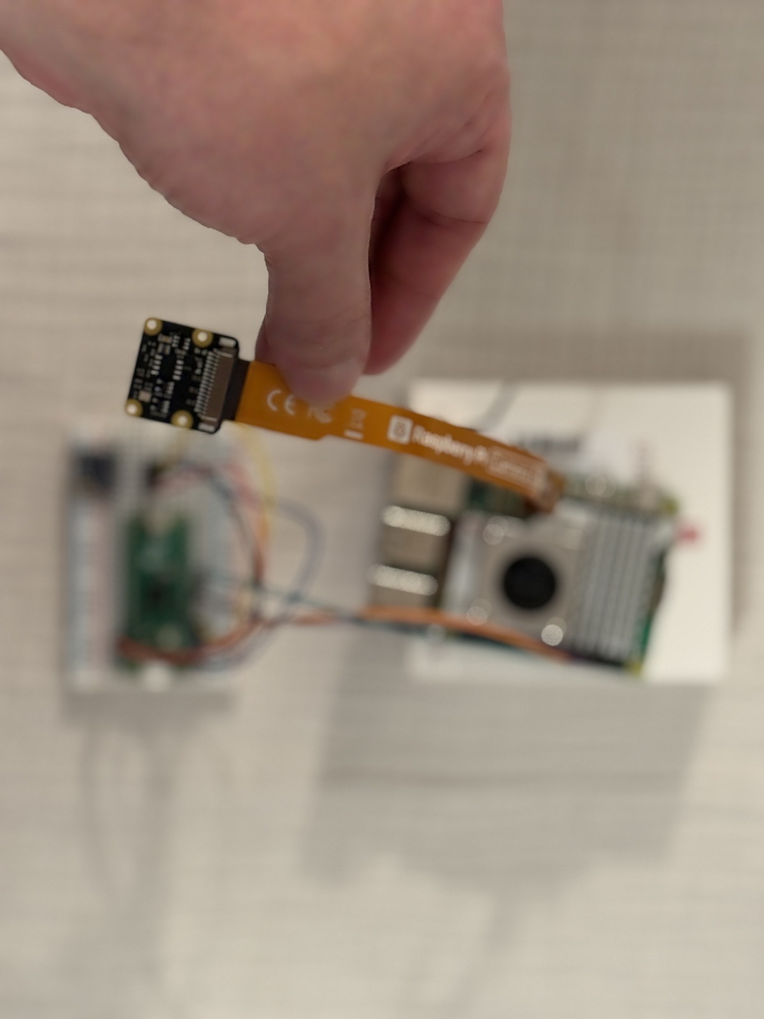
docs/images/real_build/stage2_37_camera_module3_orange_ribbon_seated_and_locked.jpg
