arctic-trail/karhunkierros-sar-drone/docs/images/real_build/stage2_39_straightening_hook_pin_with_pliers.jpg

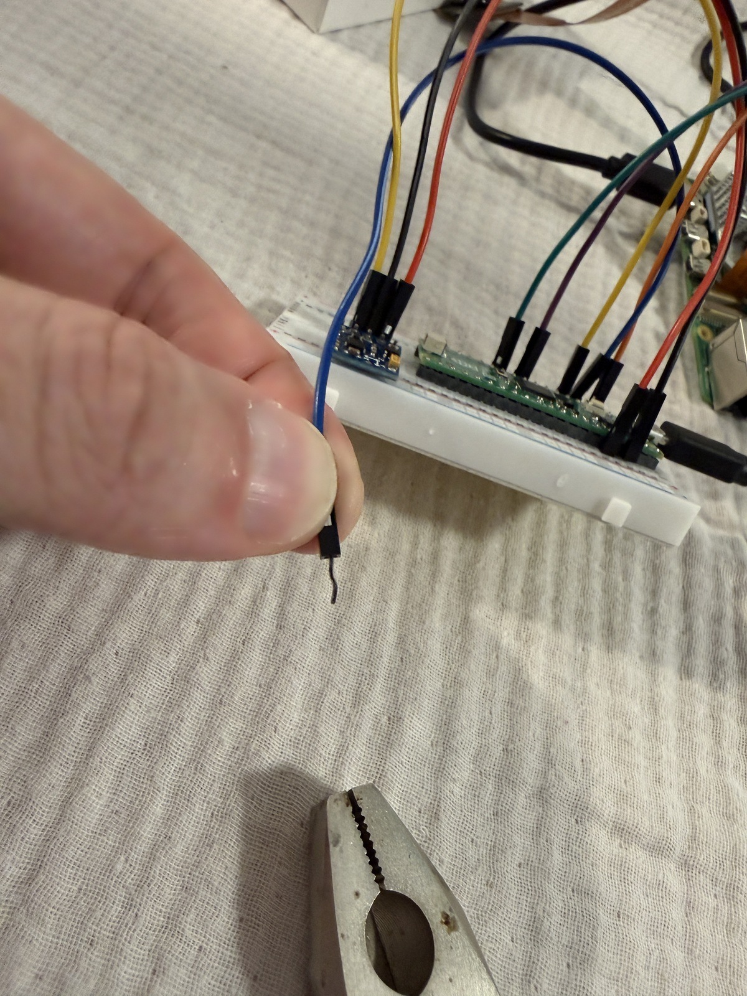
docs/images/real_build/stage2_39_straightening_hook_pin_with_pliers.jpg
