arctic-trail/karhunkierros-sar-drone/docs/images/real_build/stage2_40_compass_shifted_down_2_empty_bottom_holes_closeup.jpg

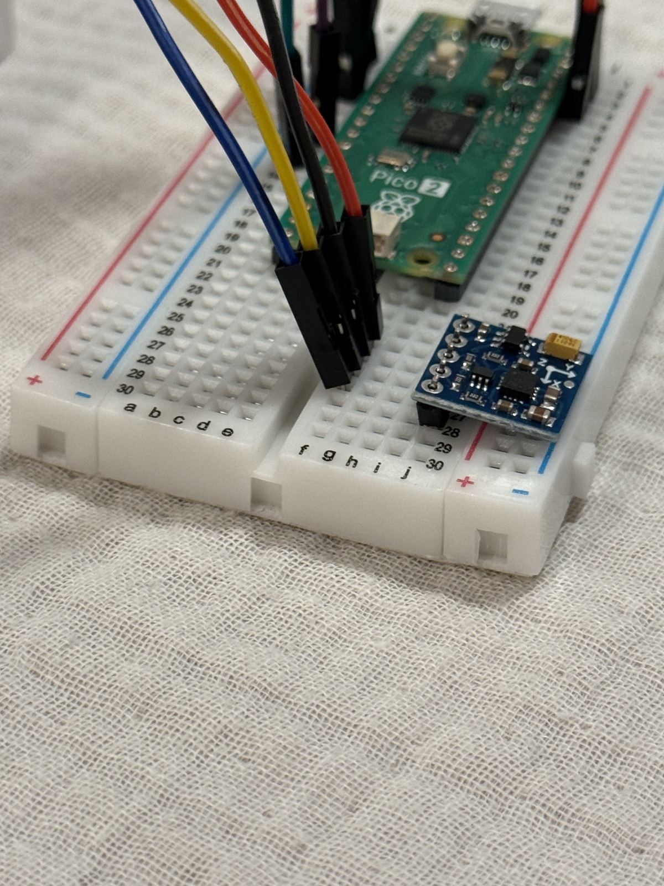
docs/images/real_build/stage2_40_compass_shifted_down_2_empty_bottom_holes_closeup.jpg
