arctic-trail/karhunkierros-sar-drone/docs/images/real_build/stage2_42_complete_benchtop_system_powered_golden.jpg

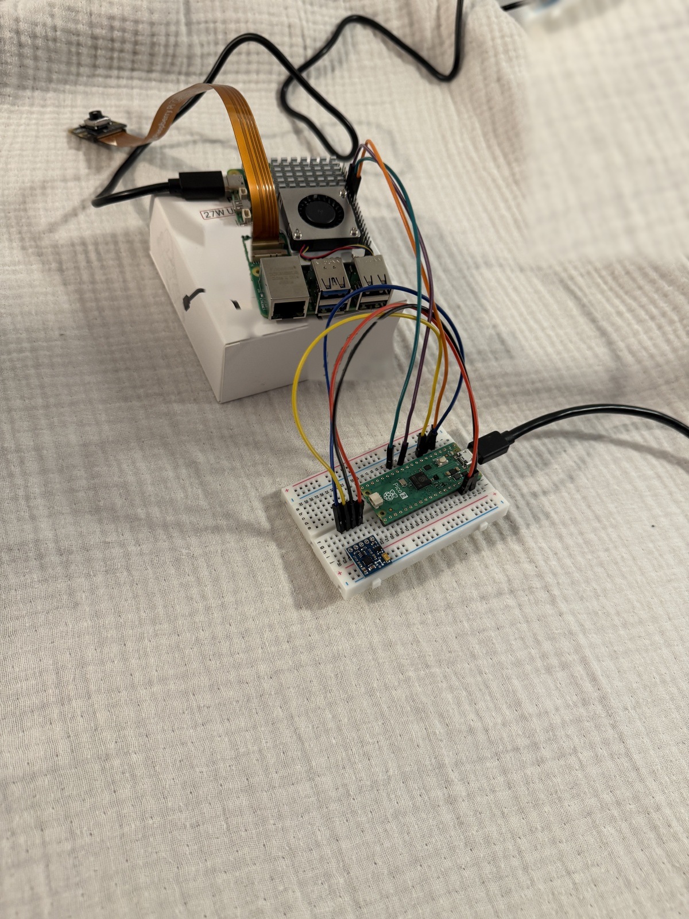
docs/images/real_build/stage2_42_complete_benchtop_system_powered_golden.jpg
