arctic-trail/karhunkierros-sar-drone/docs/images/real_build/stage3_01_four_fiber_and_power_packages_staged.jpg

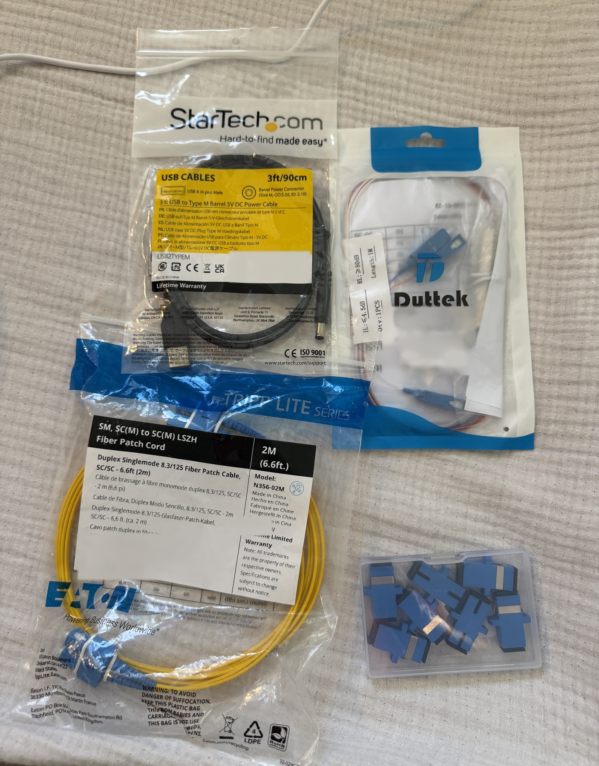
docs/images/real_build/stage3_01_four_fiber_and_power_packages_staged.jpg
