arctic-trail/karhunkierros-sar-drone/docs/images/real_build/stage3_02_two_startech_media_converter_boxes.jpg

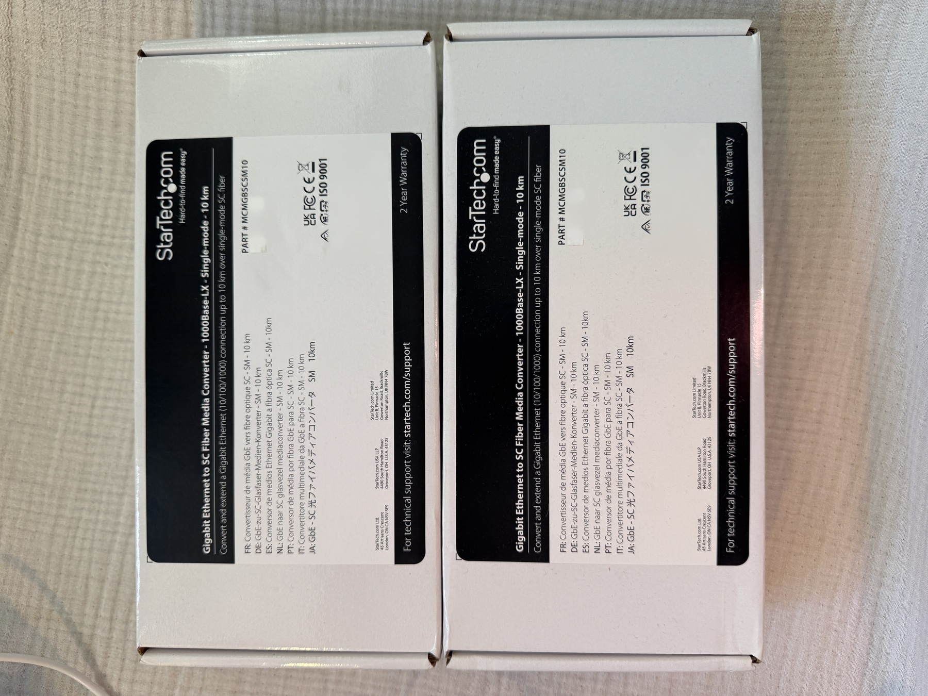
docs/images/real_build/stage3_02_two_startech_media_converter_boxes.jpg
