arctic-trail/karhunkierros-sar-drone/docs/images/real_build/stage3_03_unboxed_startech_converters_with_5v_power_bricks.jpg

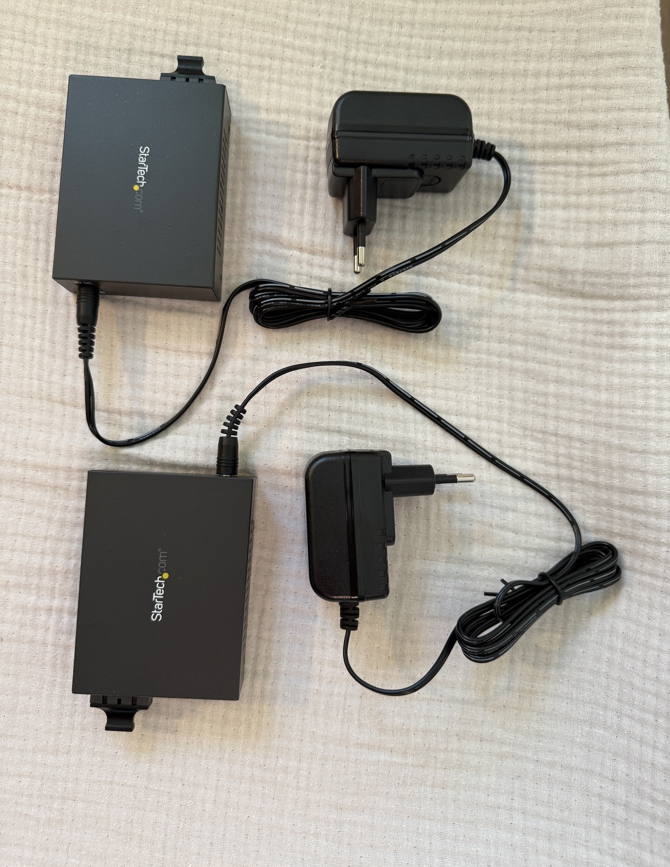
docs/images/real_build/stage3_03_unboxed_startech_converters_with_5v_power_bricks.jpg
