arctic-trail/karhunkierros-sar-drone/docs/images/real_build/stage3_04_startech_front_ports_and_5v_dc_jack_closeup.jpg

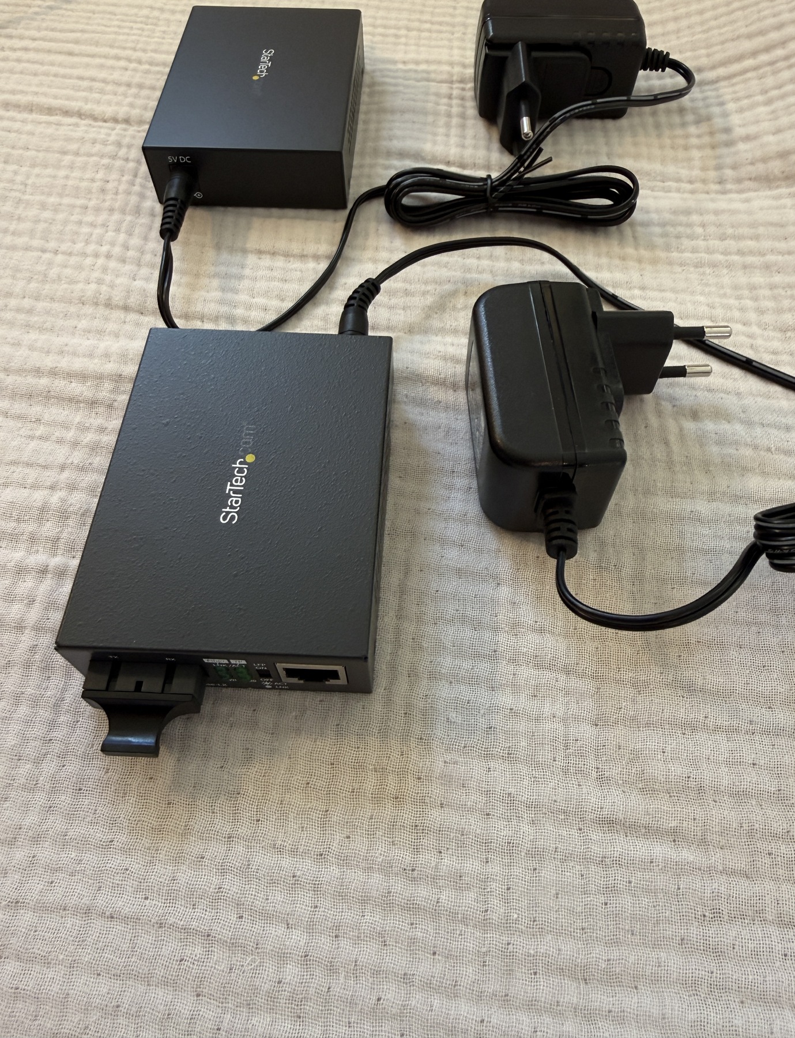
docs/images/real_build/stage3_04_startech_front_ports_and_5v_dc_jack_closeup.jpg
