arctic-trail/karhunkierros-sar-drone/docs/images/real_build/stage3_05_both_startech_boxes_ethernet_cables_connected.jpg

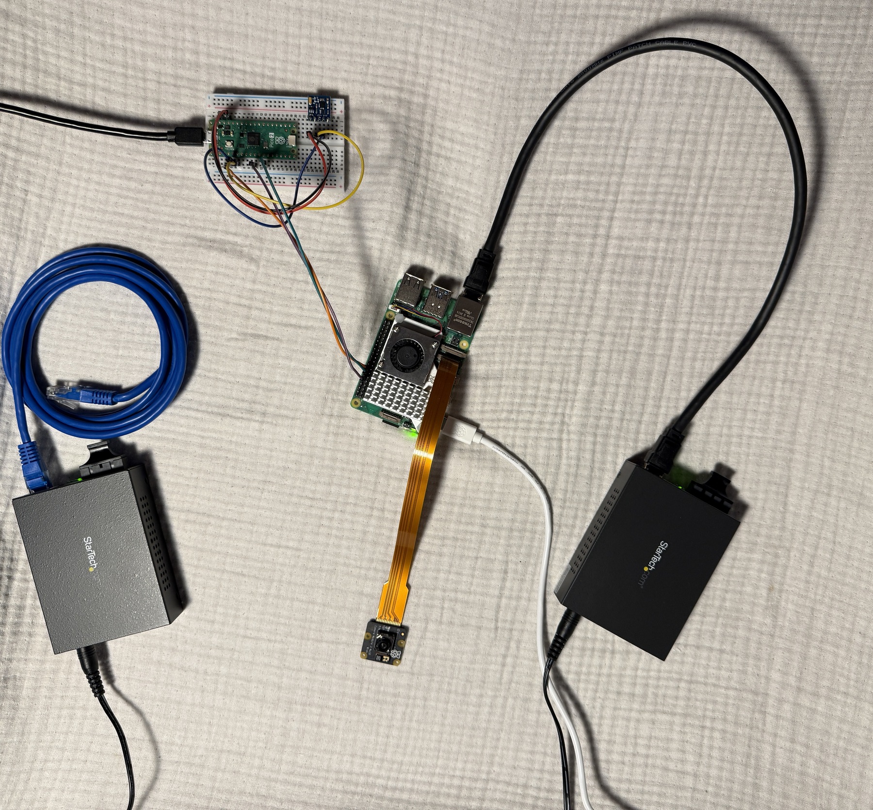
docs/images/real_build/stage3_05_both_startech_boxes_ethernet_cables_connected.jpg
