arctic-trail/karhunkierros-sar-drone/docs/images/real_build/stage3_06_blue_ethernet_in_macbook_usbc_adapter.jpg

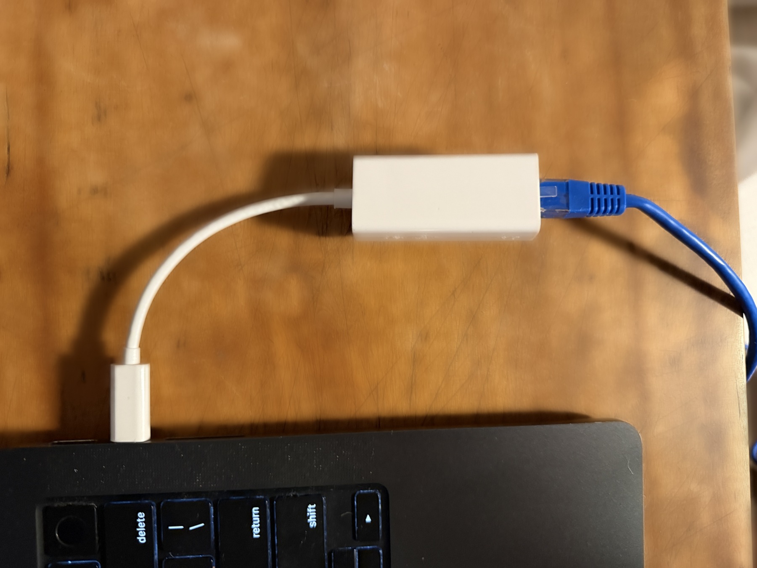
docs/images/real_build/stage3_06_blue_ethernet_in_macbook_usbc_adapter.jpg
