arctic-trail/karhunkierros-sar-drone/docs/images/real_build/stage3_07_duttek_blue_and_orange_plugs_caps_removed.jpg

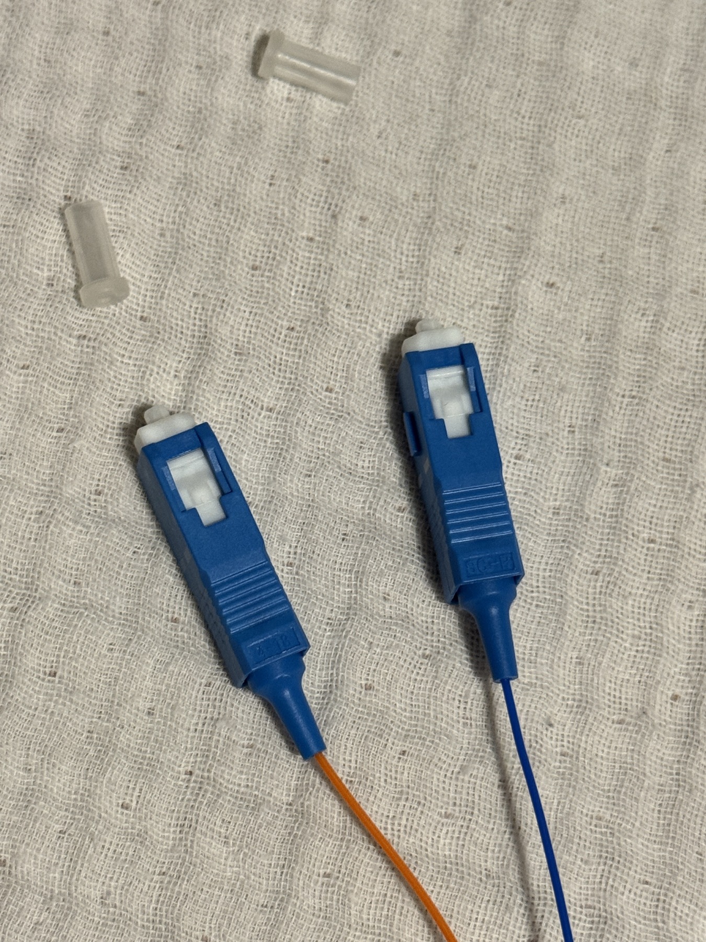
docs/images/real_build/stage3_07_duttek_blue_and_orange_plugs_caps_removed.jpg
