arctic-trail/karhunkierros-sar-drone/docs/images/real_build/stage3_08_duttek_splitter_all_three_cords_white_blue_orange.jpg

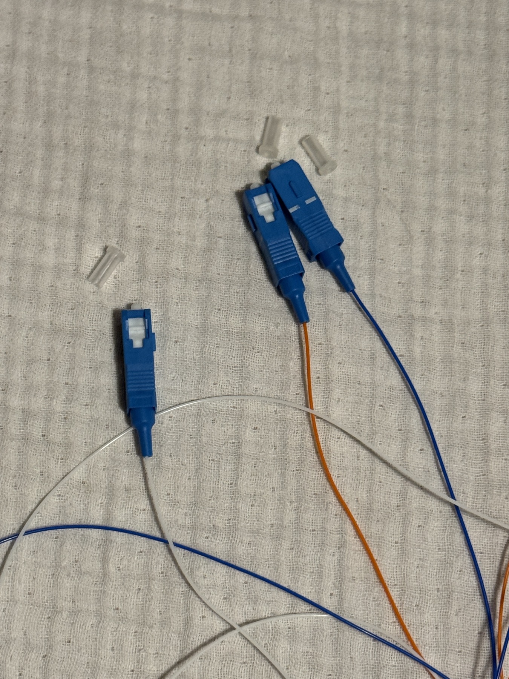
docs/images/real_build/stage3_08_duttek_splitter_all_three_cords_white_blue_orange.jpg
