arctic-trail/karhunkierros-sar-drone/docs/images/real_build/stage3_09_blue_sc_coupler_black_dust_caps_removed.jpg

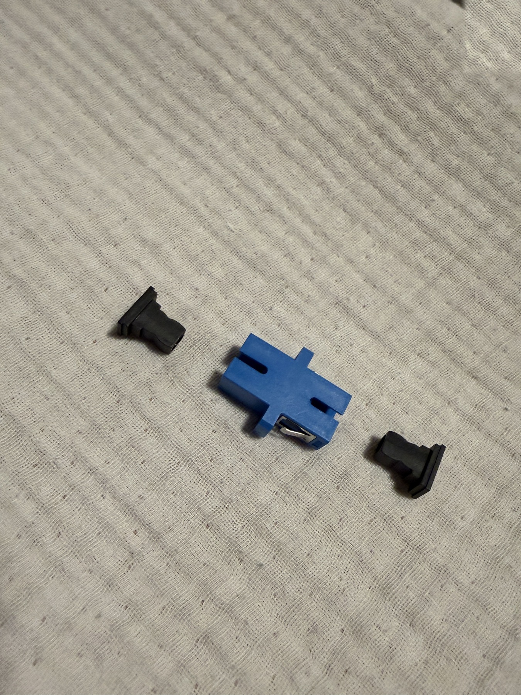
docs/images/real_build/stage3_09_blue_sc_coupler_black_dust_caps_removed.jpg
