arctic-trail/karhunkierros-sar-drone/docs/images/real_build/stage3_10_yellow_duplex_fiber_cable_unbagged.jpg

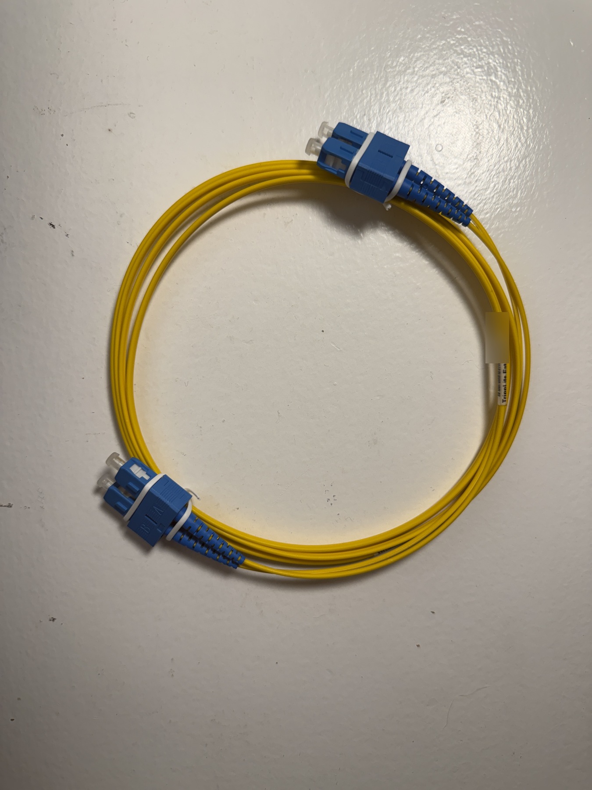
docs/images/real_build/stage3_10_yellow_duplex_fiber_cable_unbagged.jpg
