arctic-trail/karhunkierros-sar-drone/docs/images/real_build/stage3_11_prying_open_duplex_clip_on_yellow_fiber.jpg

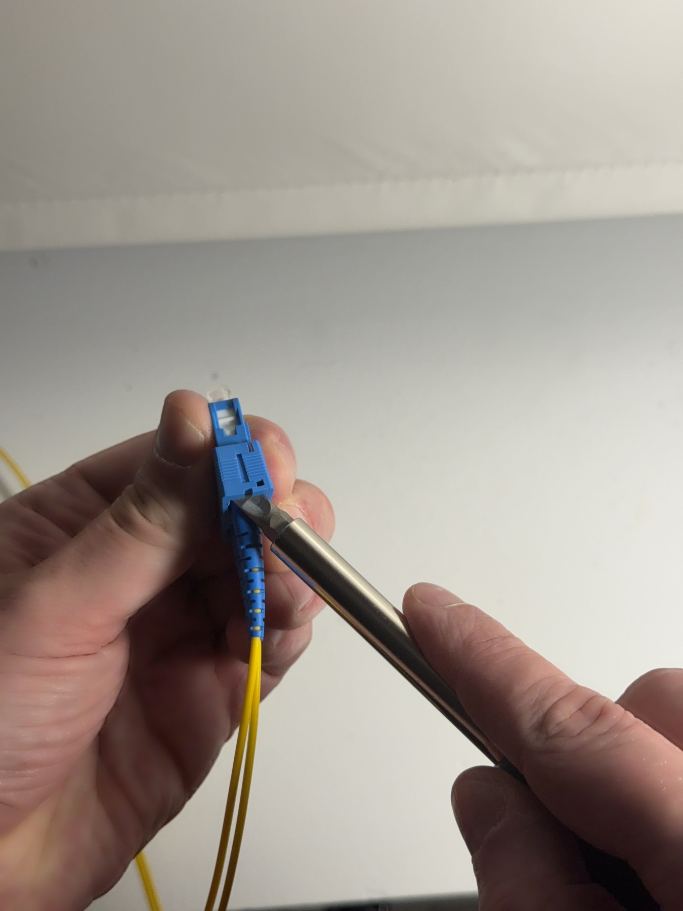
docs/images/real_build/stage3_11_prying_open_duplex_clip_on_yellow_fiber.jpg
