arctic-trail/karhunkierros-sar-drone/docs/images/real_build/stage3_12_duplex_clip_removed_two_yellow_fiber_plugs_separated.jpg

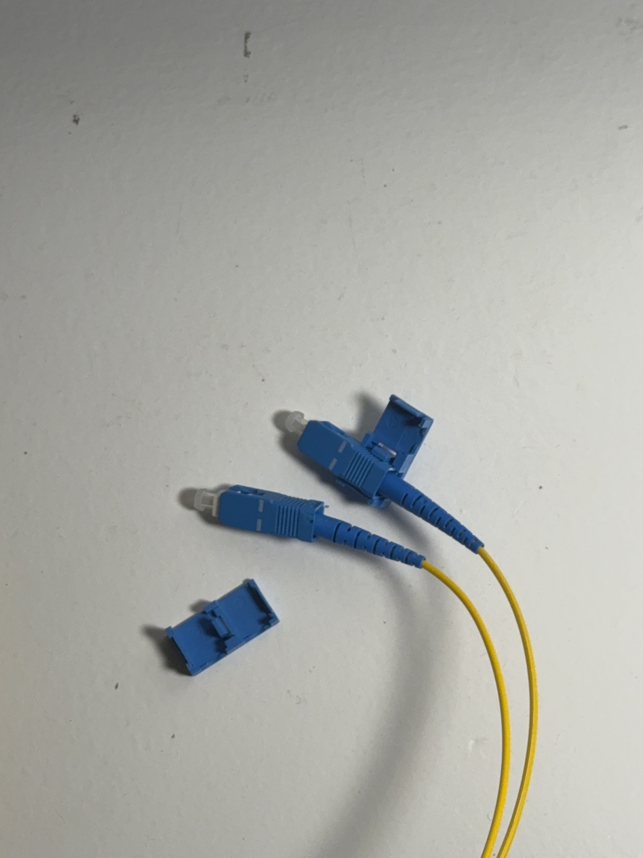
docs/images/real_build/stage3_12_duplex_clip_removed_two_yellow_fiber_plugs_separated.jpg
