arctic-trail/karhunkierros-sar-drone/docs/images/real_build/stage3_13a_locating_white_wrap_label_on_yellow_duplex_cord.jpg

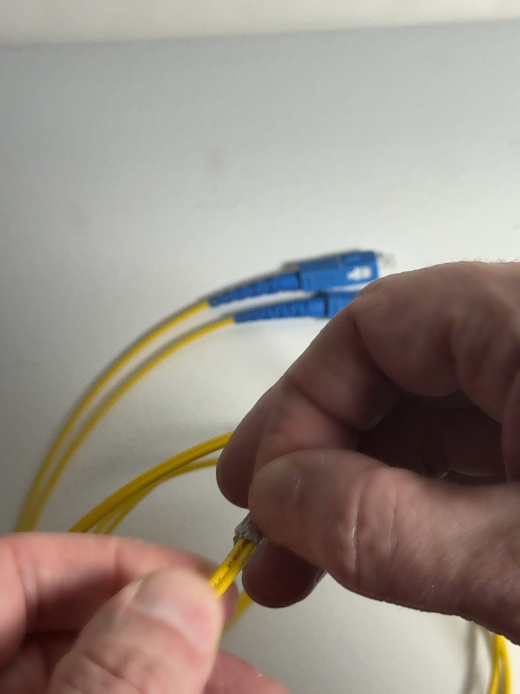
docs/images/real_build/stage3_13a_locating_white_wrap_label_on_yellow_duplex_cord.jpg
