arctic-trail/karhunkierros-sar-drone/docs/images/real_build/stage3_13b_peeling_white_wrap_label_to_separate_yellow_strands.jpg

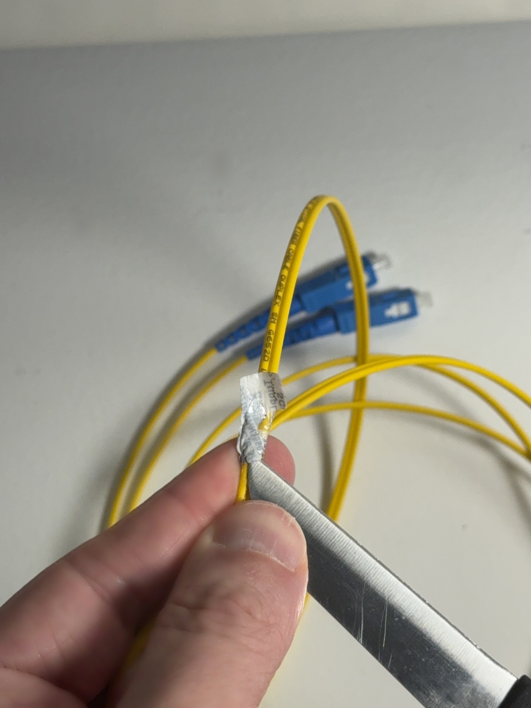
docs/images/real_build/stage3_13b_peeling_white_wrap_label_to_separate_yellow_strands.jpg
