arctic-trail/karhunkierros-sar-drone/docs/images/real_build/stage3_14_unzipping_duplex_yellow_fiber_into_single_strand.jpg

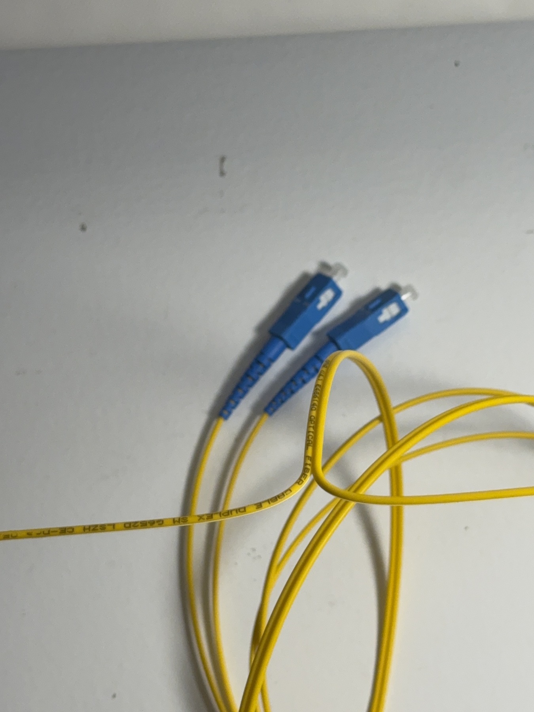
docs/images/real_build/stage3_14_unzipping_duplex_yellow_fiber_into_single_strand.jpg
