arctic-trail/karhunkierros-sar-drone/docs/images/real_build/stage3_15_single_yellow_fiber_strand_ready_caps_removed.jpg

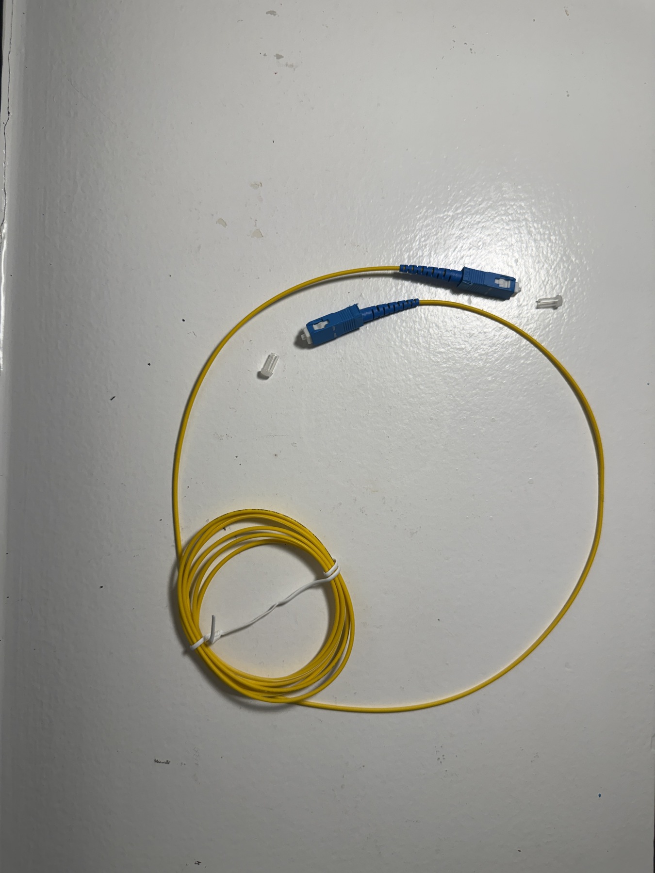
docs/images/real_build/stage3_15_single_yellow_fiber_strand_ready_caps_removed.jpg
