arctic-trail/karhunkierros-sar-drone/docs/images/real_build/stage3_16_blue_coupler_joining_orange_splitter_and_yellow_fiber.jpg

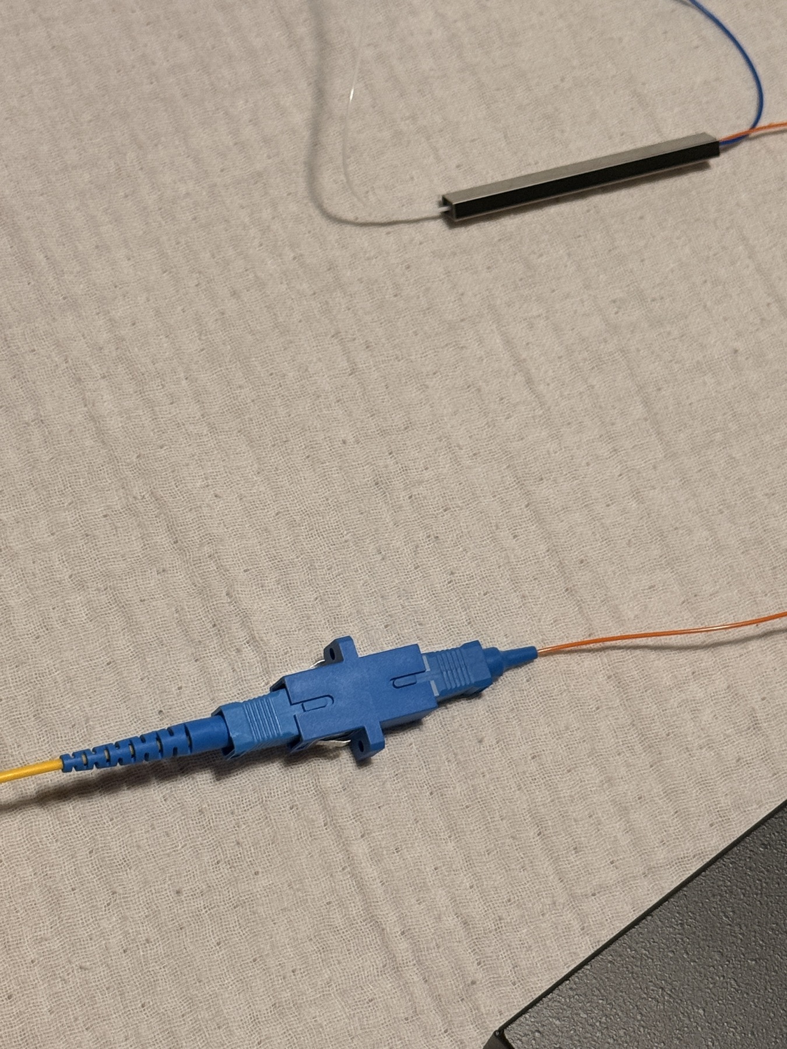
docs/images/real_build/stage3_16_blue_coupler_joining_orange_splitter_and_yellow_fiber.jpg
