arctic-trail/karhunkierros-sar-drone/docs/images/real_build/stage3_17_pi_startech_box1_white_tx_blue_rx_all_4_green_leds.jpg

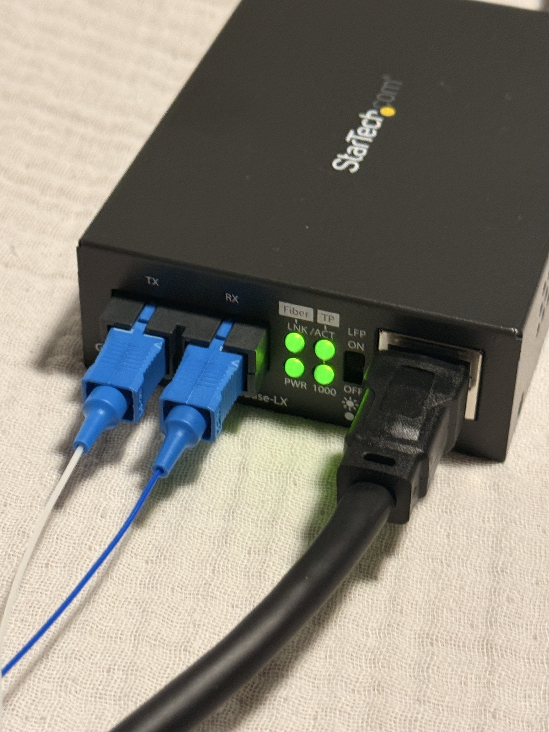
docs/images/real_build/stage3_17_pi_startech_box1_white_tx_blue_rx_all_4_green_leds.jpg
