arctic-trail/karhunkierros-sar-drone/docs/images/real_build/stage3_18_field_side_topdown_pi5_breadboard_box1_splitter_coupler.jpg

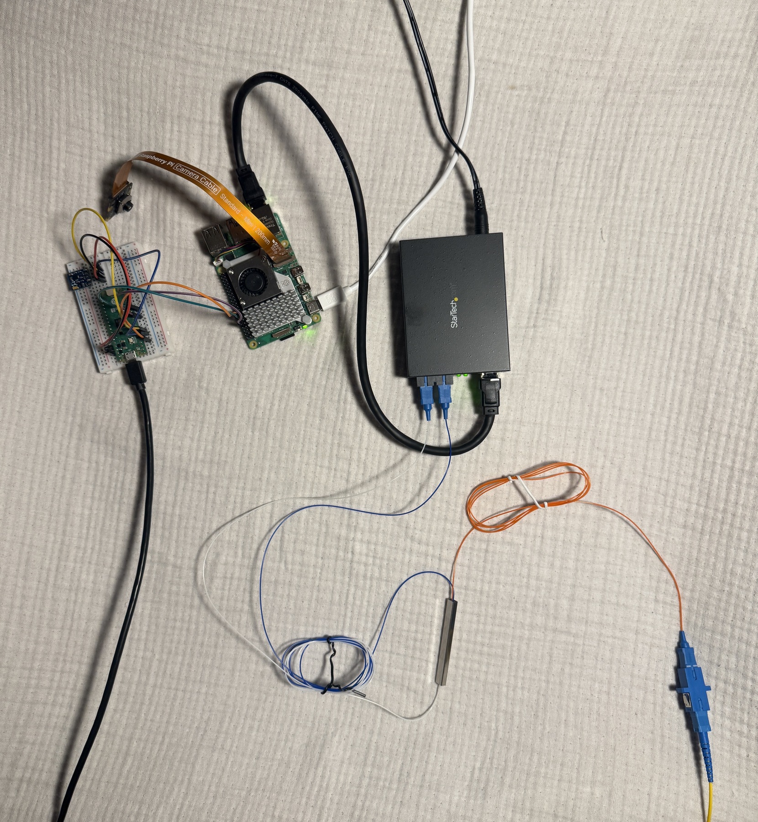
docs/images/real_build/stage3_18_field_side_topdown_pi5_breadboard_box1_splitter_coupler.jpg
