arctic-trail/karhunkierros-sar-drone/docs/images/real_build/stage3_19_field_side_angled_box1_4_green_leds_and_splitter.jpg

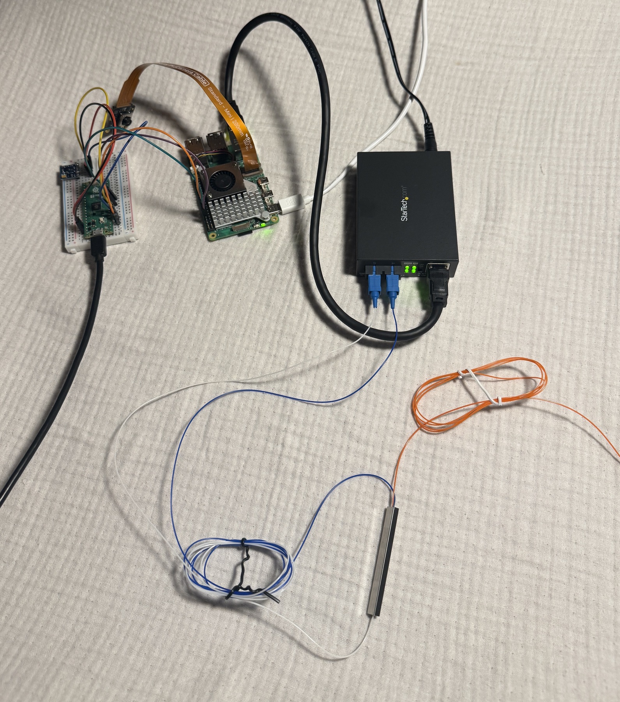
docs/images/real_build/stage3_19_field_side_angled_box1_4_green_leds_and_splitter.jpg
