arctic-trail/karhunkierros-sar-drone/docs/images/real_build/stage3_20_macbook_box2_lfp_on_only_pwr_led_before_switch_off.jpg

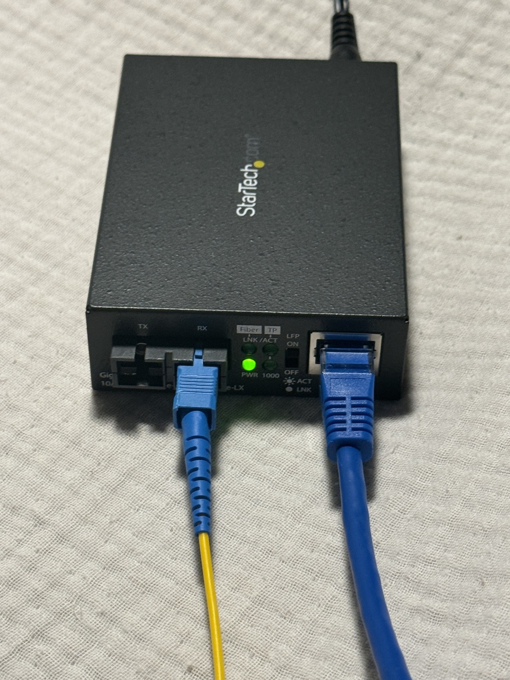
docs/images/real_build/stage3_20_macbook_box2_lfp_on_only_pwr_led_before_switch_off.jpg
