arctic-trail/karhunkierros-sar-drone/docs/images/real_build/stage3_21_lfp_switched_off_power_cycled_3_green_leds_ethernet_up.jpg

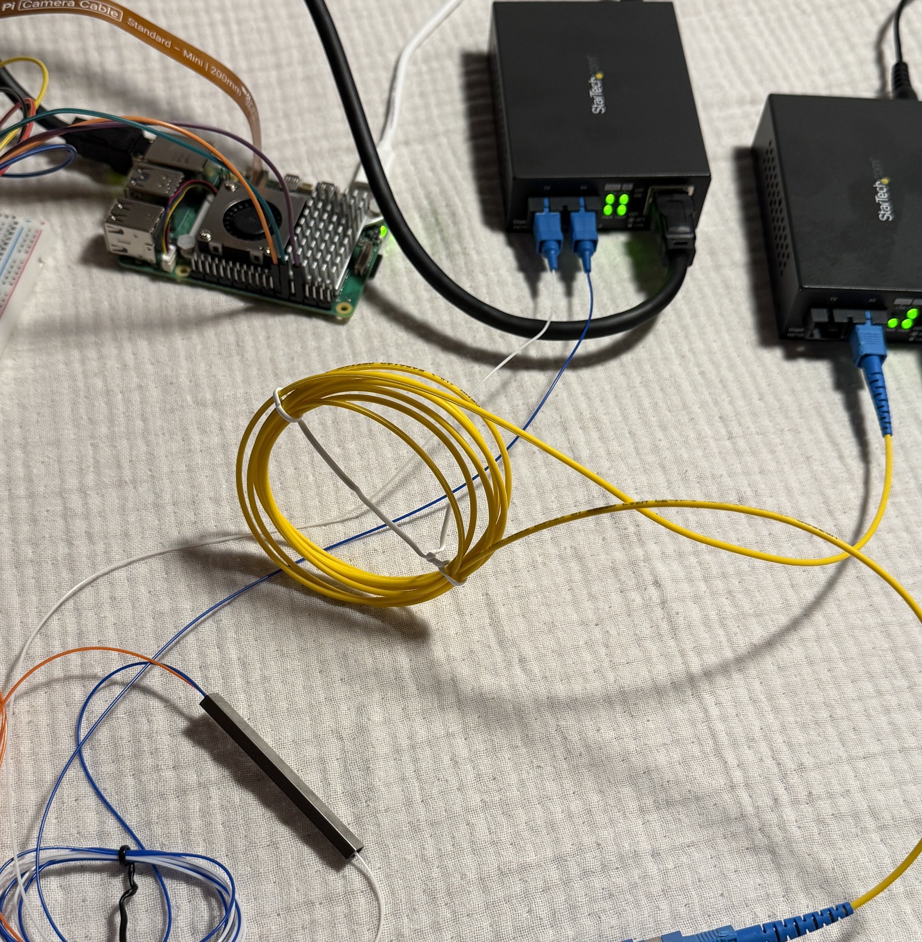
docs/images/real_build/stage3_21_lfp_switched_off_power_cycled_3_green_leds_ethernet_up.jpg
