arctic-trail/karhunkierros-sar-drone/docs/images/real_build/stage3_23_full_benchtop_angled_both_boxes_all_8_green_leds.jpg

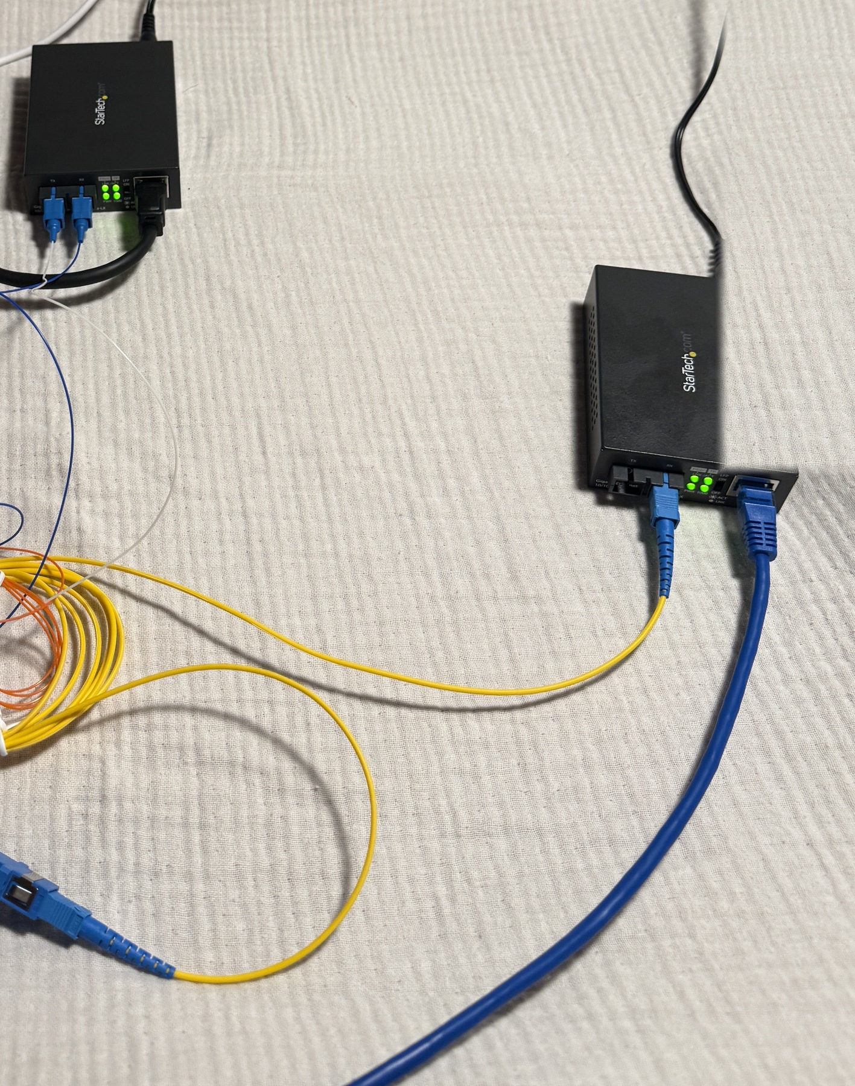
docs/images/real_build/stage3_23_full_benchtop_angled_both_boxes_all_8_green_leds.jpg
