arctic-trail/karhunkierros-sar-drone/docs/images/real_build/stage4_01_boreal_trail_yolo_standing_lock.png

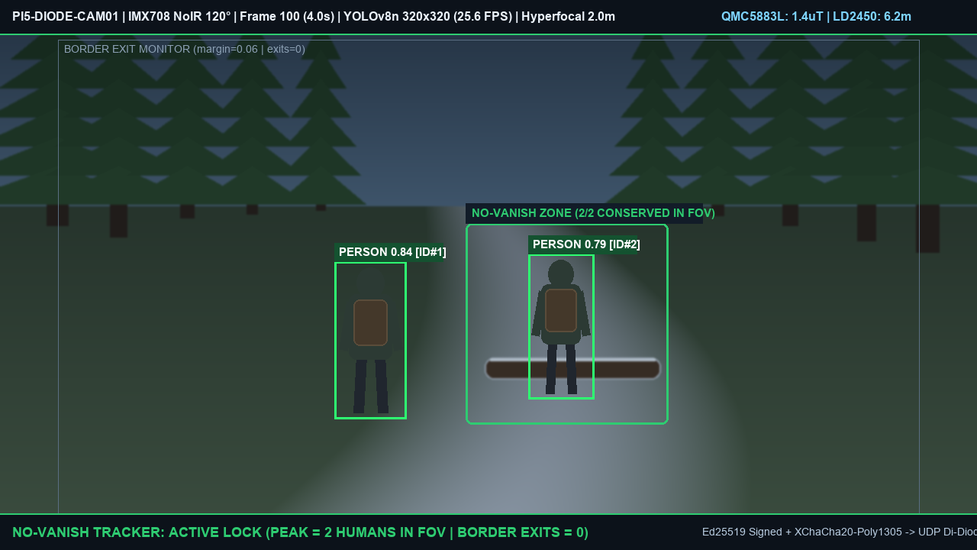
docs/images/real_build/stage4_01_boreal_trail_yolo_standing_lock.png
