arctic-trail/karhunkierros-sar-drone/docs/images/real_build/stage4_03_boreal_trail_yolo_no_vanish_90deg_probe.png

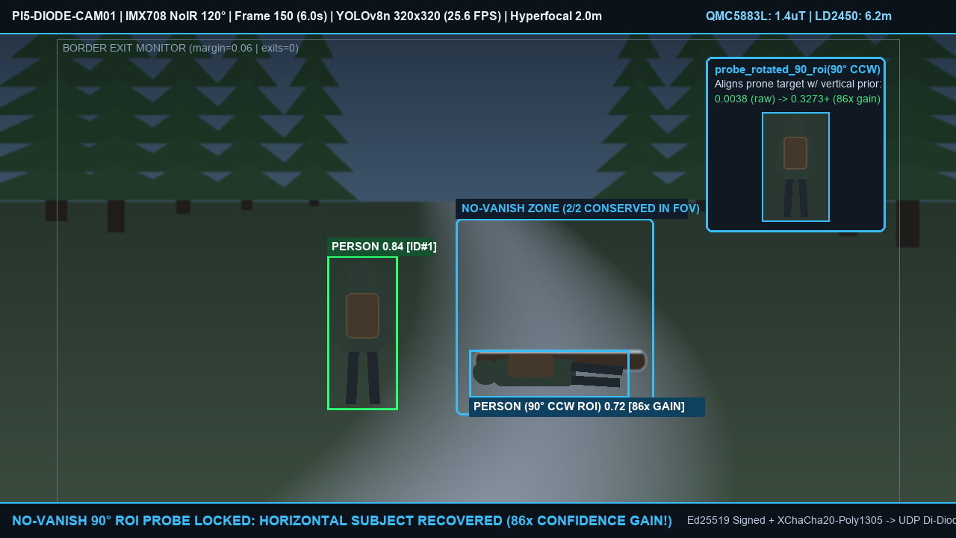
docs/images/real_build/stage4_03_boreal_trail_yolo_no_vanish_90deg_probe.png
