arctic-trail/karhunkierros-sar-drone/docs/images/real_build/stage2_26_pi5_gpio_outer_column_verified_side_view.jpg

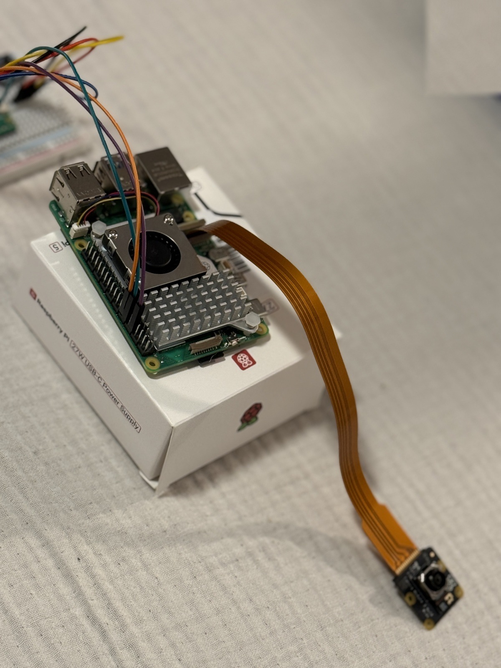
docs/images/real_build/stage2_26_pi5_gpio_outer_column_verified_side_view.jpg
