arctic-trail/karhunkierros-sar-drone/docs/images/real_build/stage2_27_pi5_gpio_outer_column_verified_angled_view.jpg

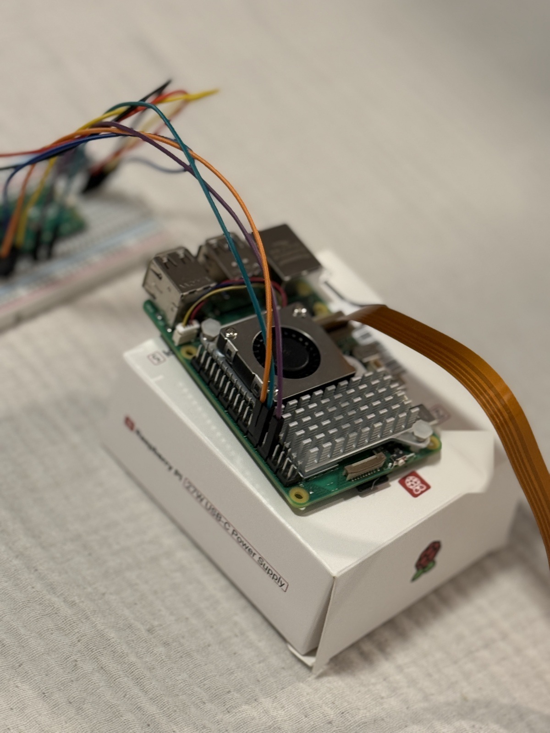
docs/images/real_build/stage2_27_pi5_gpio_outer_column_verified_angled_view.jpg
