arctic-trail/karhunkierros-sar-drone/docs/images/real_build/stage3_22_macbook_startech_box2_all_4_green_leds_rx_verified_closeup.jpg

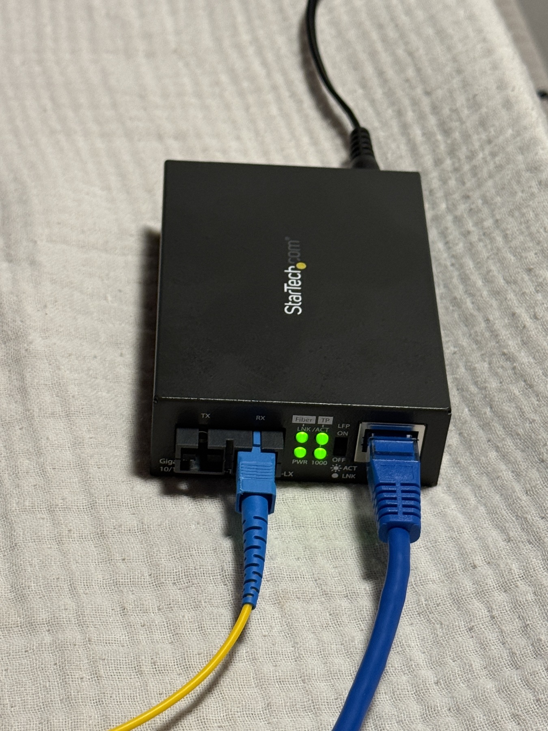
docs/images/real_build/stage3_22_macbook_startech_box2_all_4_green_leds_rx_verified_closeup.jpg
