arctic-trail/karhunkierros-sar-drone/docs/images/real_build/stage2_38_blue_wire_hook_pin_risk.jpg

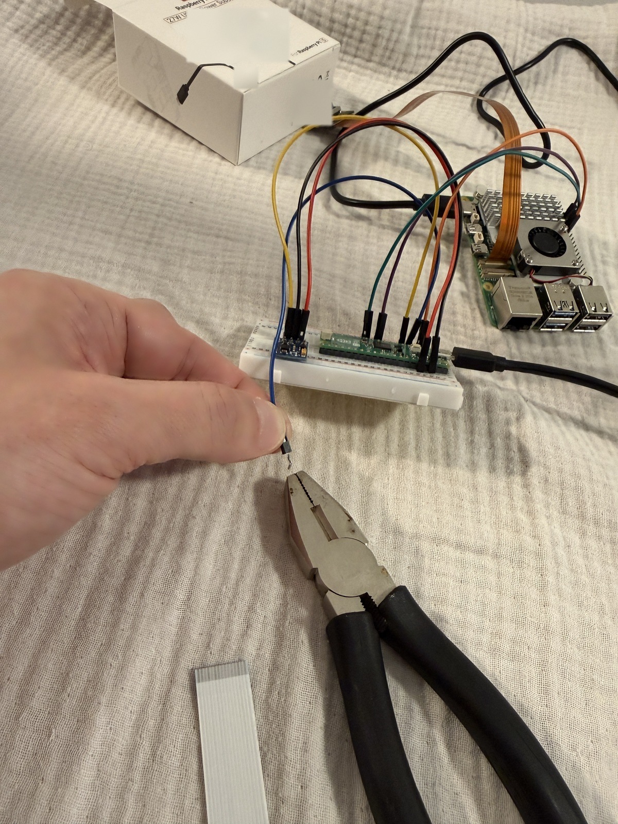
docs/images/real_build/stage2_38_blue_wire_hook_pin_risk.jpg
