arctic-trail/karhunkierros-sar-drone/maritime_usv_finlab06/cad/ark_fpv_ardurover_45_usv.param

# ArduRover 4.5+ Turnkey Maritime USV Profile (FIN_LAB_06A / FIN-LAB-06)
# Hardware: ARK FPV STM32H743 (USA) + u-blox ZED-F9P (CH) + PNI RM3100 (USA)
FRAME_CLASS,2
FRAME_TYPE,0
PILOT_STEER_TYPE,1
SERVO1_FUNCTION,73
SERVO3_FUNCTION,74
MOT_THR_MIN,12
MOT_THR_MAX,95
MOT_SLEW_RATE,45
CRUISE_SPEED,1.54
CRUISE_THROTTLE,48
WP_RADIUS,1.50
WP_OVERSHOOT,1.0
NAVL1_PERIOD,5.5
NAVL1_DAMPING,0.85
ATC_STR_RAT_P,0.28
ATC_STR_RAT_I,0.12
ATC_STR_RAT_D,0.01
ATC_SPEED_P,0.45
ATC_SPEED_I,0.20
COMPASS_TYPEMASK,0
EK3_SRC1_POSXY,3
EK3_SRC1_VELXY,3
EK3_SRC2_POSXY,6
EK3_SRC2_VELXY,6
AIS_TYPE,1
OA_TYPE,2
OA_MARGIN_MAX,185.0
FS_THR_ENABLE,2
FS_BATT_ENABLE,2
BATT_LOW_VOLT,12.2
BATT_CRT_VOLT,11.8
