arctic-trail/karhunkierros-sar-drone/run_guided_bench_doctor.py

#!/usr/bin/env python3
"""
File: run_guided_bench_doctor.py
Description: Interactive & Automated IKEA-Style Benchtop Hardware Doctor & Bring-Up Assistant.
             Walks a builder with zero electronics experience through verifying:
               [Stage 1] Pico 2 [P07] USB / BOOTSEL & QMC5883L [P08] I2C0 (0x0d)
               [Stage 2] Breadboard Hole-by-Hole Wiring (W1..W7) & Pi [P01] + Camera [P05]
               [Stage 3] Collector Ethernet / 1x2 Optical Fiber Diode [P13]-[P16] (10.10.0.100)
               [Stage 4] End-to-End Ed25519 Signed Alert + Live Web Dashboard Verification
             Includes pin-exact troubleshooting hints referencing the exact breadboard holes
             (e.g., Hole j5, Hole j3, Hole a6, Hole a7, Hole a11, Hole a4, Hole a13).
License: MIT
"""
import argparse
import glob
import json
import os
import shutil
import socket
import subprocess
import sys
import tempfile
import time
import urllib.request

SCRIPT_DIR = os.path.dirname(os.path.abspath(__file__))
REPO_ROOT = os.path.dirname(SCRIPT_DIR)

# Prevent OS file-copy utilities from creating resource-fork or bytecode junk files
os.environ["COPYFILE_DISABLE"] = "1"
os.environ["PYTHONDONTWRITEBYTECODE"] = "1"

OS_JUNK_NAMES = {".DS_Store", ".Spotlight-V100", ".fseventsd", ".Trashes", ".TemporaryItems", "Thumbs.db", "desktop.ini"}


def purge_os_junk_metadata(target_path):
    """
    Recursively delete any OS indexer or temporary junk artifacts from a folder or volume.
    """
    if not target_path or not os.path.exists(target_path):
        return 0
    removed = 0
    if os.path.isfile(target_path):
        return 0
    for root, dirs, files in os.walk(target_path, topdown=False):
        for fname in files:
            if fname in OS_JUNK_NAMES or fname.startswith("._"):
                try:
                    os.remove(os.path.join(root, fname))
                    removed += 1
                except OSError:
                    pass
        for dname in dirs:
            if dname in OS_JUNK_NAMES or dname.startswith("._"):
                shutil.rmtree(os.path.join(root, dname), ignore_errors=True)
                removed += 1
    return removed


def copy_clean_file_bytes(src_path, dst_path):
    """
    Copy raw file payload bytes without copying OS extended attributes or resource forks.
    """
    with open(src_path, "rb") as fsrc:
        payload = fsrc.read()
    with open(dst_path, "wb") as fdst:
        fdst.write(payload)
        fdst.flush()
        os.fsync(fdst.fileno())


def flash_pico_cleanly(uf2_path=None, bootsel_vol=None):
    """
    Flash MicroPython .uf2 onto Raspberry Pi Pico 2 (RP2350) / Pico (RP2040) cleanly.
    Prefers the all-in-one `arctic_trailcam_pico2_complete.uf2` (MicroPython + main.py + test_qmc5883l.py)
    flashed directly over raw USB PICOBOOT via `picotool load -v -x`.
    """
    if not uf2_path:
        bundled_uf2 = os.path.join(SCRIPT_DIR, "pico_gatekeeper", "arctic_trailcam_pico2_complete.uf2")
        if os.path.isfile(bundled_uf2):
            uf2_path = bundled_uf2
        else:
            candidates = sorted(
                glob.glob(os.path.expanduser("~/Downloads/RPI_PICO2*.uf2"))
                + glob.glob(os.path.expanduser("~/Downloads/RPI_PICO*.uf2"))
            )
            if candidates:
                uf2_path = candidates[-1]
    if not uf2_path or not os.path.isfile(uf2_path):
        print("  [!] No MicroPython .uf2 file found.")
        return False

    purge_os_junk_metadata(uf2_path)
    if bootsel_vol and os.path.isdir(bootsel_vol):
        purge_os_junk_metadata(bootsel_vol)

    picotool_bin = shutil.which("picotool")
    if picotool_bin:
        print(f"  [*] Flashing {os.path.basename(uf2_path)} directly over raw USB via picotool...")
        proc = subprocess.run(
            [picotool_bin, "load", "-v", "-x", uf2_path],
            stdout=subprocess.PIPE,
            stderr=subprocess.STDOUT,
            text=True,
            timeout=30,
        )
        if proc.returncode == 0:
            print("  [✓] picotool hardware-verified flash & reboot succeeded!")
            return True
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
