arctic-trail/karhunkierros-sar-drone/(commit log)

2026-10-20 Initial release: Karhunkierros SAR Drone & Ground Sensor Reference
2026-10-20 Add top-of-document concept-stage disclaimers across README, docs & PDFs and prune unreferenced assets
2026-10-20 Add 28-slide architecture presentation deck & sync Stage 2-3 hardware guides
2026-10-20 Use synthetic frame numbers in Stage 4 boreal trail illustrations
2026-10-21 Add FIN-LAB-01 v1.0 U-Space surge track fusion, fast fixed-wing nav profile & discrete-event nest contention twin
2026-10-21 Add FIN-LAB-02 350-400 km/h 3D STEP/STL CAD airframe, [P12-HEATED] 6.5s launch nest, 285 km/h COTS fast-climber & Northern-Flank gap solver
2026-10-21 docs(fast-sar-jet): add 16 CAD-reconciled isometric subsystem & airspace-safety design plates and architecture guide
2026-10-21 feat(finlab): wire FIN-LAB-01 live-stream load test, FIN-SIG-LIB v1.0 dataset, [P12-BELT], [P12-HEATED/CAPTURE] & FIN-LAB-06 USV into finlab-suite
2026-10-21 docs,sim: complete 100% civilian SAR & U-Space sanitization across SAR, drone_observer, and Plates 17-18
2026-10-21 feat(sim,docs): add 2D wind-tunnel hinged flaperon & attached wake fix plus Plate 23 wing/control/VG trade study
2026-10-21 docs(readme): remove awkward '(Inspiration vs. Use Case)' parenthetical
2026-10-22 docs: embed Plate 23 in ENGINEERING_DESIGN_AND_ARCHITECTURE.md and update README test/plate counts
2026-10-22 docs: sync 25-plate engineering gallery references, Pitot/Normal-Law FCS and 100k-flight FMEA links across READMEs
2026-10-22 Upgrade SAR C&C console with Google Earth tile pyramid, zero-overlap sector search, 1-click drone camera/drop cancel, and MAVLink v2 field bridge
2026-10-22 Add live external LLM JEV client (<=1.15s timeout) and /console shortcut route
    [dashboard_server.py, playbook_agent_dispatcher.py]
2026-10-22 Fix continuous drone flight on box resize/redraw, 8-handle box stretch, direct drone drag/pin/track, and 1:1 trackpad X/Y bounds steering
    [run_full_verification_and_readiness_audit.py]
2026-10-22 Document 20 Extreme-Arctic Protections & v0.1 Convergence Freeze (Plate 29)
2026-10-22 Add FinLab-06 Arctic Maritime USV 6-DOF COLREGs & Dual-Mode Hydrofoil Architecture
    [ark_fpv_ardurover_45_usv.param, finlab06a_catamaran_1850mm.step, finlab06a_catamaran_1850mm.stl, finlab06a_hull_frames_and_deck_1to1.dxf]
2026-10-22 Add complete 6-persona SAR operator UX specification and current-vs-target gap analysis
2026-10-22 Deliver structured playbook fields (zero regex), dynamic 60Hz safe-envelope gauges, mobile_responder.html & accurate 3-zone trailcam spec
2026-10-22 Harden bidirectional MAVLink v2 RX parser, Haversine geodesy, atomic disk state sync, and 6-Persona Production vs. Missing Physical Gates audit (44/44 tests pass)
    [dashboard_server.py, mavlink_field_bridge.py, run_full_verification_and_readiness_audit.py]
2026-10-22 Refactor JEV LLM Auto Dispatcher for multi-provider keep-alive, cycle-aware thrash & dwell gates, multi-target veto failover, and Helo/RTH preemption
    [dashboard_server.py, playbook_agent_dispatcher.py]
2026-10-22 Fix 1x real-time physical velocity scaling (0.5x-100x selector) and add 1-click Manual Practice Mission mode
2026-10-22 feat(ui): add 1-click Snowmobile/Hiker Auto-Track, Visual Auto-Track on Sight & 2-Way Voice Intercom
2026-10-23 Feat(SAR/FIN-LAB-01): Add Option B Karhunkierros-X8 coaxial SAR upgrade, Sled B-Prop electric carrier lineup (<300 km EU compliance), and v1.2 multi-band acoustic & optical tether hazard detector
2026-10-24 Add zero-BOM-change small-blob thermal gait tracker, LiDAR fog gate & 18m corridor planner
2026-10-24 Add 6-iteration AI-native aerospace playbook audit, kinematic split gate & VRS-safe fog descent
2026-10-28 Add Opaslyhty Golden Iter 3 SSOT/CAD/C++17 SIL, JSBSim sar_sim_v2 & FIN-LAB-02 updates
    [Allied_EU_COTS_BOM.csv, opaslyhty_sar_quad_fc_config.param, opaslyhty_x500v2_sar_assembly.step, opaslyhty_x500v2_sar_assembly.stl, opaslyhty_x500v2_sar_cnc_plates.dxf, pixhawk6c_4s_sar.param]
2026-10-28 Enforce strict COTS quadcopter & electric fixed-wing SAR scope and CAD SSOT
    [dashboard_server.py, northern_flank_red_gap_solver.py, run_full_verification_and_readiness_audit.py]
2026-11-12 Add complete real-photo bench build guide (Blocks 1-3), EAR/ITAR <=9Hz compliance dossier, and v0.4 Polar-Night CAD/avionics updates
    [Allied_EU_COTS_BOM.csv, opaslyhty_sar_quad_fc_config.param, opaslyhty_x500v2_sar_assembly.step, opaslyhty_x500v2_sar_assembly.stl, pixhawk6c_4s_sar.param]
2026-11-12 Add Final Step 9 90-degree T-antenna deck mounting visual card to build guide and root README
2026-11-13 Complete Step 6E, 9B, 9D & 9E live bench verification (915 MHz LoRa, 0.0 deg IMU & dual optical/LWIR belly cameras)
